Ring-F-nebula/fpga-multitimbral-instrument/firmware/src/fx_pitch_coeff.v

// Bend +/-200 cents plus vibrato +/-100 cents. Q16 frequency ratio.
module fx_pitch_coeff(input signed [9:0] cents,output reg [16:0] coeff);
wire signed [9:0] bounded=cents< -300?-10'sd300:cents>300?10'sd300:cents;
wire [9:0] address=bounded+10'sd300;
always @* case(address)
10'd0:coeff=17'd55109;
10'd1:coeff=17'd55141;
10'd2:coeff=17'd55173;
10'd3:coeff=17'd55205;
10'd4:coeff=17'd55236;
10'd5:coeff=17'd55268;
10'd6:coeff=17'd55300;
10'd7:coeff=17'd55332;
10'd8:coeff=17'd55364;
10'd9:coeff=17'd55396;
10'd10:coeff=17'd55428;
10'd11:coeff=17'd55460;
10'd12:coeff=17'd55492;
10'd13:coeff=17'd55524;
10'd14:coeff=17'd55556;
10'd15:coeff=17'd55589;
10'd16:coeff=17'd55621;
10'd17:coeff=17'd55653;
10'd18:coeff=17'd55685;
10'd19:coeff=17'd55717;
10'd20:coeff=17'd55749;
10'd21:coeff=17'd55782;
10'd22:coeff=17'd55814;
10'd23:coeff=17'd55846;
10'd24:coeff=17'd55878;
10'd25:coeff=17'd55911;
10'd26:coeff=17'd55943;
10'd27:coeff=17'd55975;
10'd28:coeff=17'd56008;
10'd29:coeff=17'd56040;
10'd30:coeff=17'd56072;
10'd31:coeff=17'd56105;
10'd32:coeff=17'd56137;
10'd33:coeff=17'd56170;
10'd34:coeff=17'd56202;
10'd35:coeff=17'd56234;
10'd36:coeff=17'd56267;
10'd37:coeff=17'd56299;
10'd38:coeff=17'd56332;
10'd39:coeff=17'd56365;
10'd40:coeff=17'd56397;
10'd41:coeff=17'd56430;
10'd42:coeff=17'd56462;
10'd43:coeff=17'd56495;
10'd44:coeff=17'd56528;
10'd45:coeff=17'd56560;
10'd46:coeff=17'd56593;
10'd47:coeff=17'd56626;
10'd48:coeff=17'd56658;
10'd49:coeff=17'd56691;
10'd50:coeff=17'd56724;
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
10'd582:coeff=17'd77130;
10'd583:coeff=17'd77174;
10'd584:coeff=17'd77219;
10'd585:coeff=17'd77264;
10'd586:coeff=17'd77308;
10'd587:coeff=17'd77353;
10'd588:coeff=17'd77398;
10'd589:coeff=17'd77442;
10'd590:coeff=17'd77487;
10'd591:coeff=17'd77532;
10'd592:coeff=17'd77577;
10'd593:coeff=17'd77621;
10'd594:coeff=17'd77666;
10'd595:coeff=17'd77711;
10'd596:coeff=17'd77756;
10'd597:coeff=17'd77801;
10'd598:coeff=17'd77846;
10'd599:coeff=17'd77891;
10'd600:coeff=17'd77936;
default:coeff=65536;
endcase
endmodule
