Ring-F-nebula/fpga-multitimbral-instrument/firmware/src/guitar_wave_table.v

// Analytic, sample-measured spectra; six initialized 16-kbit BSRAMs.
// Three registered stages: table read, spectral blend multiply, final sum.
module guitar_wave_table(input clk,enable,input [23:0] phase,step,input [7:0] brightness,
 output reg signed [12:0] value=0);
 wire [1:0] band=step>=24'd368000 ? 2'd2 : step>=24'd184000 ? 2'd1 : 2'd0;
 wire [11:0] address={band,phase[23:14]};
 wire [15:0] body,attack;
 guitar_body_sp body_rom(.clk(clk),.enable(enable),.address(address),.data(body));
 guitar_attack_sp attack_rom(.clk(clk),.enable(enable),.address(address),.data(attack));
 reg [7:0] brightness_q=0;
 reg signed [12:0] body_q=0;
 reg signed [22:0] delta=0;
 wire signed [13:0] difference=$signed(attack)-$signed(body);
 always @(posedge clk)begin
  brightness_q<=brightness;body_q<=$signed(body);
  delta<=difference*$signed({1'b0,brightness_q});
  value<=body_q+($signed(delta)>>>8);
 end
endmodule
module guitar_body_sp(input clk,enable,input [11:0] address,output [15:0] data);
wire [31:0] bank_data[0:2];reg [1:0] bank_q=0;
always @(posedge clk)if(enable)bank_q<=address[11:10];
SP #(.BIT_WIDTH(16),.READ_MODE(1'b0),.WRITE_MODE(2'b00),.INIT_RAM_00(256'h05880552051504d10486043403dc037e031b02b3024701d7016400ee00780000),.INIT_RAM_01(256'h05b105cb05e405fb060f0621062e0638063c063c0636062a061705fe05de05b6),.INIT_RAM_02(256'h04af04ac04ac04af04b504be04ca04d904ea04fe0514052b0545055f057a0596),.INIT_RAM_03(256'h05b0059f058d057905660552053e052a0516050404f204e204d404c704bc04b4),.INIT_RAM_04(256'h05f305fa0600060406070609060906080605060005fa05f205e805dc05cf05c0),.INIT_RAM_05(256'h05620569057105790582058b0594059e05a805b205bc05c605d005da05e305eb),.INIT_RAM_06(256'h05370537053705380539053a053b053d053f054205450548054c05510556055c),.INIT_RAM_07(256'h052305260529052c052e05300531053205330534053505350536053605360536),.INIT_RAM_08(256'h04a304af04bb04c604d004da04e404ed04f504fd0504050a05100516051b051f),.INIT_RAM_09(256'h03d703e103ec03f804040410041d042b0438044604530461046f047c04890496),.INIT_RAM_0A(256'h03a303a203a003a0039f039f03a003a203a403a803ac03b103b703be03c503ce),.INIT_RAM_0B(256'h03790383038d0395039b03a003a403a703a903aa03ab03aa03a903a803a603a5),.INIT_RAM_0C(256'h02270241025c0276028f02a902c102d902f00305031a032d033f0350035f036d),.INIT_RAM_0D(256'h00e900f300ff010c011a012a013c014f01630179018f01a701bf01d901f2020c),.INIT_RAM_0E(256'h00fd00f600ef00e900e200dd00d800d400d100d000cf00d000d200d500db00e1),.INIT_RAM_0F(256'h012c0130013301350135013501330131012e012a0125011f01190112010b0104),.INIT_RAM_10(256'h006f007e008d009d00ac00bb00c900d700e400f000fb01060110011801200126),.INIT_RAM_11(256'hffbdffc2ffc8ffcfffd6ffdfffe8fff3fffe000a00170025003300410050005f),.INIT_RAM_12(256'hffcaffc7ffc4ffc1ffbeffbbffb8ffb6ffb4ffb3ffb2ffb2ffb3ffb4ffb6ffb9),.INIT_RAM_13(256'hffc6ffc9ffcdffd0ffd2ffd4ffd5ffd6ffd7ffd6ffd6ffd5ffd3ffd1ffcfffcc),.INIT_RAM_14(256'hff77ff7bff7fff84ff89ff8eff94ff99ff9effa4ffa9ffaeffb4ffb8ffbdffc2),.INIT_RAM_15(256'hff53ff54ff55ff56ff57ff58ff5aff5cff5eff60ff62ff65ff68ff6bff6fff73),.INIT_RAM_16(256'hff51ff51ff50ff4fff4fff4fff4fff4fff4fff4fff4fff50ff50ff51ff51ff52),.INIT_RAM_17(256'hff7dff7aff76ff72ff6eff6bff67ff64ff61ff5eff5cff59ff57ff56ff54ff53),.INIT_RAM_18(256'hffa1ffa1ffa1ffa0ff9fff9eff9cff9aff98ff95ff93ff8fff8cff89ff85ff81),.INIT_RAM_19(256'hff93ff92ff92ff93ff94ff95ff96ff97ff99ff9aff9bff9dff9eff9fffa0ffa1),.INIT_RAM_1A(256'hffc2ffbeffbaffb6ffb2ffaeffaaffa6ffa3ff9fff9cff9aff97ff96ff94ff93),.INIT_RAM_1B(256'hffaaffb2ffb9ffbfffc4ffc8ffccffceffd0ffd0ffd0ffcfffceffccffc9ffc6),.INIT_RAM_1C(256'hff02ff0aff13ff1dff28ff33ff3eff4aff56ff61ff6dff78ff83ff8eff98ffa1),.INIT_RAM_1D(256'hff2cff20ff15ff0bff02fefbfef4fef0feecfeeafeeafeebfeedfef0fef5fefb),.INIT_RAM_1E(256'h0003fffaffefffe4ffd7ffcaffbcffaeff9fff90ff81ff72ff63ff54ff46ff38),.INIT_RAM_1F(256'h0006000b00110016001a001e002100230024002400230021001d00190013000c),.INIT_RAM_20(256'hffedffe7ffe3ffdfffddffdcffdcffddffdfffe2ffe6ffeaffeffff5fffa0000),.INIT_RAM_21(256'h00ba00ac009d008e007f007000610052004400360029001c00110006fffdfff4),.INIT_RAM_22(256'h010b0110011301150116011601140110010c010500fe00f500eb00e000d400c8),.INIT_RAM_23(256'h00680072007d00880093009f00aa00b600c200cd00d800e300ed00f600fe0105),.INIT_RAM_24(256'h0037003400320031003000300030003200340038003c00410047004e0056005f),.INIT_RAM_25(256'h006c006a0069006600640061005d005a00560052004e004a00460042003e003a),.INIT_RAM_26(256'h00600061006200630065006600670069006a006b006c006d006e006e006d006d),.INIT_RAM_27(256'h007b007700740071006d006b006800660064006200610060005f005f005f005f),.INIT_RAM_28(256'h00ac00aa00a900a700a400a2009f009c009900950092008e008a00860083007f),.INIT_RAM_29(256'h00af00af00b000b000b100b100b100b100b100b100b100b100b000af00af00ad),.INIT_RAM_2A(256'h009100950098009b009e00a000a200a400a600a800a900aa00ab00ac00ad00ae),.INIT_RAM_2B(256'h00430048004c00520057005c00620067006c00720077007c008100850089008d),.INIT_RAM_2C(256'h0031002f002d002b002a002a0029002a002b002c002e003000330037003a003e),.INIT_RAM_2D(256'h004a004c004d004e004e004d004c004a004800450042003f003c003900360034),.INIT_RAM_2E(256'hffb0ffbfffcdffdbffe9fff60002000d00180021002a00310038003e00430047),.INIT_RAM_2F(256'hfee0fee8fef0fefaff05ff10ff1cff29ff37ff45ff54ff63ff73ff82ff91ffa1),.INIT_RAM_30(256'hfef5feeefee7fee1fedbfed6fed2fecffecdfecbfecbfecbfecdfed0fed4feda),.INIT_RAM_31(256'hff25ff2bff2eff30ff31ff30ff2fff2cff28ff23ff1eff17ff11ff0aff03fefc),.INIT_RAM_32(256'hfe0efe27fe41fe59fe71fe87fe9dfeb1fec4fed6fee6fef4ff01ff0dff17ff1f),.INIT_RAM_33(256'hfca1fcb0fcc1fcd3fce6fcfbfd10fd27fd3ffd57fd71fd8afda4fdbffdd9fdf4),.INIT_RAM_34(256'hfc5afc58fc57fc56fc55fc56fc57fc59fc5cfc60fc65fc6bfc73fc7dfc87fc93),.INIT_RAM_35(256'hfc3bfc42fc49fc4ffc54fc58fc5cfc5efc60fc61fc61fc60fc60fc5efc5dfc5b),.INIT_RAM_36(256'hfb77fb84fb91fb9ffbadfbbafbc8fbd5fbe3fbf0fbfcfc08fc14fc1ffc29fc32),.INIT_RAM_37(256'hfae5faeafaf0faf6fafcfb03fb0bfb13fb1cfb26fb30fb3afb45fb51fb5dfb6a),.INIT_RAM_38(256'hfacafacafacafacbfacbfaccfacdfacefacffad0fad2fad4fad7fadafaddfae1),.INIT_RAM_39(256'hfaaafaaffab4fab8fabbfabefac1fac3fac5fac6fac7fac8fac9fac9fac9faca),.INIT_RAM_3A(256'hfa1dfa26fa30fa3afa44fa4efa58fa62fa6cfa75fa7efa87fa8ffa97fa9efaa4),.INIT_RAM_3B(256'hfa31fa24fa18fa0efa06fa00f9fbf9f8f9f7f9f7f9f9f9fcfa00fa06fa0dfa15),.INIT_RAM_3C(256'hfb44fb39fb2cfb1efb0efafcfaeafad6fac2faaefa9afa87fa73fa61fa50fa40),.INIT_RAM_3D(256'hfa86faa1fabbfad5faecfb02fb16fb27fb36fb42fb4bfb51fb54fb54fb51fb4c),.INIT_RAM_3E(256'hfa22fa02f9e9f9d6f9caf9c4f9c4f9c8f9d2f9dff9f1fa05fa1cfa35fa4ffa6a),.INIT_RAM_3F(256'hff88ff12fe9cfe29fdb9fd4dfce5fc82fc24fbccfb7afb2ffaebfaaefa78fa4a)) bank_0(
.DO(bank_data[0]),.DI(32'd0),.BLKSEL(3'd0),.AD({address[9:0],4'd0}),.WRE(1'b0),.CLK(clk),.CE(enable&&address[11:10]==0),.OCE(1'b1),.RESET(1'b0));
SP #(.BIT_WIDTH(16),.READ_MODE(1'b0),.WRITE_MODE(2'b00),.INIT_RAM_00(256'h03790346031002d902a10268022e01f201b60179013b00fd00be007f00400000),.INIT_RAM_01(256'h05c105ac0594057a055e0541052104ff04db04b5048e04640439040b03dc03ac),.INIT_RAM_02(256'h062e0632063506370637063606340630062b0624061b0611060505f705e705d5),.INIT_RAM_03(256'h059b05a605b005bb05c605d105db05e605f005fa0603060c0615061c06230629),.INIT_RAM_04(256'h052d053005330537053b05400546054c0553055a0562056b0574057d05870591),.INIT_RAM_05(256'h054a05450541053d053a053605330530052e052c052b052a05290529052a052b),.INIT_RAM_06(256'h057f057e057d057b057805760573056f056c056805640560055b05570552054e),.INIT_RAM_07(256'h0544054c0553055a05600566056b056f057305770579057c057d057f057f057f),.INIT_RAM_08(256'h049c04a804b304bf04cb04d604e204ed04f80503050d05170521052a0533053c),.INIT_RAM_09(256'h03f003f90402040c04160420042a04350440044b04560461046d047804840490),.INIT_RAM_0A(256'h037e0384038a03900396039d03a303aa03b103b803bf03c703ce03d603df03e7),.INIT_RAM_0B(256'h0313031b0323032b0332033903400347034d0354035a03600366036c03720378),.INIT_RAM_0C(256'h02640271027e028b029702a302af02bb02c602d102db02e502ef02f80302030a),.INIT_RAM_0D(256'h0181018f019d01ab01ba01c801d601e501f402020210021f022d023b02490256),.INIT_RAM_0E(256'h00cc00d400dd00e600f000fa0104010f011a01260132013e014b015801660173),.INIT_RAM_0F(256'h008500870089008b008d009000930097009b00a000a500aa00b000b600bd00c4),.INIT_RAM_10(256'h007c007d007e007e007e007f007f007f007f0080008000800081008200830084),.INIT_RAM_11(256'h004f00540059005e006200650069006c006f00720074007600780079007a007b),.INIT_RAM_12(256'hffdeffe6ffeefff6fffe0006000e0015001d0024002b00320038003e0044004a),.INIT_RAM_13(256'hff6cff71ff77ff7dff83ff8aff91ff98ff9fffa7ffaeffb6ffbeffc6ffceffd6),.INIT_RAM_14(256'hff46ff46ff46ff46ff47ff48ff49ff4bff4dff50ff53ff56ff5aff5eff62ff67),.INIT_RAM_15(256'hff6aff67ff64ff61ff5eff5bff58ff55ff53ff50ff4eff4cff4bff49ff48ff47),.INIT_RAM_16(256'hff91ff8fff8eff8cff8bff89ff86ff84ff82ff7fff7cff79ff77ff74ff70ff6d),.INIT_RAM_17(256'hff8cff8dff8eff8fff90ff91ff92ff93ff93ff94ff94ff94ff93ff93ff92ff92),.INIT_RAM_18(256'hff78ff78ff79ff7aff7bff7cff7dff7eff80ff81ff83ff84ff86ff87ff89ff8a),.INIT_RAM_19(256'hff85ff83ff81ff7fff7dff7cff7bff7aff79ff78ff77ff77ff77ff77ff77ff77),.INIT_RAM_1A(256'hffa9ffa7ffa5ffa3ffa1ff9fff9cff9aff97ff95ff92ff90ff8eff8bff89ff87),.INIT_RAM_1B(256'hffa9ffabffacffaeffafffb0ffb0ffb1ffb1ffb1ffb0ffafffafffadffacffab),.INIT_RAM_1C(256'hff6dff72ff77ff7bff80ff84ff88ff8cff90ff94ff98ff9bff9effa1ffa4ffa7),.INIT_RAM_1D(256'hff38ff39ff3bff3dff3fff42ff45ff48ff4bff4fff53ff57ff5cff60ff64ff69),.INIT_RAM_1E(256'hff62ff5cff56ff51ff4cff48ff44ff41ff3eff3bff39ff38ff37ff37ff37ff37),.INIT_RAM_1F(256'hfff5ffebffe0ffd5ffcbffc1ffb7ffadffa3ff9aff91ff88ff80ff78ff70ff69),.INIT_RAM_20(256'h0090008800800078006f0066005d00530049003f0035002b00200015000b0000),.INIT_RAM_21(256'h00c900c900c900c800c700c500c200bf00bc00b800b400af00aa00a4009e0097),.INIT_RAM_22(256'h009c00a000a400a900ad00b100b500b800bb00be00c100c300c500c700c800c9),.INIT_RAM_23(256'h005c005f006200650068006c007000740078007c008000850089008e00930097),.INIT_RAM_24(256'h00540053005100510050004f004f004f00500050005100520054005500570059),.INIT_RAM_25(256'h0077007500720070006e006b0069006600640061005f005d005b005900570055),.INIT_RAM_26(256'h008900890089008900890088008700860085008400830081007f007d007b0079),.INIT_RAM_27(256'h00770079007a007c007d007f0080008200830084008500860087008800880089),.INIT_RAM_28(256'h006e006d006d006c006c006c006d006d006e006f007000710072007300740076),.INIT_RAM_29(256'h0090008c0089008700840081007e007c007a00770075007400720071006f006e),.INIT_RAM_2A(256'h00b800b700b500b400b200b000ad00ab00a800a500a2009f009c009900960093),.INIT_RAM_2B(256'h009e00a200a600aa00ad00b000b300b500b700b800b900ba00ba00ba00ba00b9),.INIT_RAM_2C(256'h0032003a0042004a0052005900610068006f0076007d00830089008f00940099),.INIT_RAM_2D(256'hffbcffc2ffc8ffceffd5ffdcffe3ffebfff2fffa0002000a0012001a0022002a),.INIT_RAM_2E(256'hff86ff87ff88ff8aff8cff8eff91ff94ff97ff9bff9effa2ffa7ffacffb1ffb6),.INIT_RAM_2F(256'hff7dff7eff7fff80ff80ff80ff81ff81ff81ff81ff82ff82ff82ff83ff84ff85),.INIT_RAM_30(256'hff43ff4aff50ff56ff5bff60ff65ff69ff6dff70ff73ff75ff77ff79ff7bff7c),.INIT_RAM_31(256'hfe9afea8feb5fec2fecefedafee6fef1fefcff06ff10ff1aff23ff2cff34ff3c),.INIT_RAM_32(256'hfdb7fdc5fdd3fde1fdf0fdfefe0cfe1bfe2afe38fe46fe55fe63fe71fe7ffe8d),.INIT_RAM_33(256'hfcfefd08fd11fd1bfd25fd2ffd3afd45fd51fd5dfd69fd75fd82fd8ffd9cfdaa),.INIT_RAM_34(256'hfc8efc94fc9afca0fca6fcacfcb3fcb9fcc0fcc7fccefcd5fcddfce5fcedfcf6),.INIT_RAM_35(256'hfc21fc2afc32fc39fc41fc48fc4ffc56fc5dfc63fc6afc70fc76fc7cfc82fc88),.INIT_RAM_36(256'hfb7cfb88fb93fb9ffbaafbb5fbc0fbcbfbd6fbe0fbeafbf4fbfefc07fc10fc19),.INIT_RAM_37(256'hfacdfad6fadffae9faf3fafdfb08fb13fb1efb2afb35fb41fb4dfb58fb64fb70),.INIT_RAM_38(256'hfa81fa81fa83fa84fa87fa89fa8dfa91fa95fa9afaa0faa6faadfab4fabcfac4),.INIT_RAM_39(256'hfaaefaa9faa5faa0fa9cfa98fa94fa91fa8dfa8afa88fa85fa83fa82fa81fa81),.INIT_RAM_3A(256'hfad6fad7fad7fad6fad5fad4fad2fad0facdfacafac6fac3fabffabbfab6fab2),.INIT_RAM_3B(256'hfa79fa83fa8cfa95fa9efaa6faadfab4fabafac0fac5fac9facdfad0fad3fad5),.INIT_RAM_3C(256'hf9ddf9e4f9ebf9f4f9fdfa06fa10fa1afa25fa2ffa3afa45fa50fa5afa65fa6f),.INIT_RAM_3D(256'hfa19fa09f9fbf9eff9e5f9dcf9d5f9d0f9ccf9caf9c9f9c9f9cbf9cef9d2f9d7),.INIT_RAM_3E(256'hfc24fbf5fbc7fb9cfb72fb4bfb25fb01fadffabffaa2fa86fa6cfa54fa3ffa2b),.INIT_RAM_3F(256'hffc0ff81ff42ff03fec5fe87fe4afe0efdd2fd98fd5ffd27fcf0fcbafc87fc54)) bank_1(
.DO(bank_data[1]),.DI(32'd0),.BLKSEL(3'd0),.AD({address[9:0],4'd0}),.WRE(1'b0),.CLK(clk),.CE(enable&&address[11:10]==1),.OCE(1'b1),.RESET(1'b0));
SP #(.BIT_WIDTH(16),.READ_MODE(1'b0),.WRITE_MODE(2'b00),.INIT_RAM_00(256'h0189016f0155013b0121010700ed00d300b9009f0084006a004f0035001a0000),.INIT_RAM_01(256'h030f02f802e102ca02b2029a0282026a025102390220020701ee01d501bc01a2),.INIT_RAM_02(256'h045e044b04380424041103fd03e903d403bf03aa0395037f03690353033d0326),.INIT_RAM_03(256'h055e05510543053505270518050804f904e904d904c804b704a6049404830470),.INIT_RAM_04(256'h060305fc05f405ec05e305da05d105c705bd05b205a8059c059105850578056c),.INIT_RAM_05(256'h06480646064406420640063d063906360632062d06280623061e06180611060b),.INIT_RAM_06(256'h063006340637063b063e064106430645064706480649064a064a064a064a0649),.INIT_RAM_07(256'h05c705d005d805e005e805f005f705fe0605060b06110617061c06220627062b),.INIT_RAM_08(256'h0521052d053905440550055b05660570057b0585058f059905a305ac05b605bf),.INIT_RAM_09(256'h04540461046f047c048a049704a404b104be04cb04d804e404f104fd05090516),.INIT_RAM_0A(256'h037503830391039f03ad03bb03c903d703e503f30401040f041d042b04380446),.INIT_RAM_0B(256'h029b02a802b502c302d002de02eb02f90306031403220330033d034b03590367),.INIT_RAM_0C(256'h01d601e201ed01f902050211021d022902350241024e025b026702740281028e),.INIT_RAM_0D(256'h0132013c0145014e01580162016b01750180018a0194019f01aa01b501c001cb),.INIT_RAM_0E(256'h00b500bc00c300ca00d100d800df00e700ef00f700ff0107010f011801210129),.INIT_RAM_0F(256'h005e00620067006b00700075007a007f0085008a00900096009c00a200a800ae),.INIT_RAM_10(256'h0027002a002c002f003200350038003b003f004200460049004d005100550059),.INIT_RAM_11(256'h0008000a000b000d000e001000120013001500170019001b001d002000220024),.INIT_RAM_12(256'hfff7fff8fff9fffafffbfffcfffdfffeffff0000000100020003000400060007),.INIT_RAM_13(256'hffebffecffedffeeffeeffeffff0fff1fff1fff2fff3fff4fff4fff5fff6fff7),.INIT_RAM_14(256'hffdcffdeffdfffe0ffe1ffe2ffe3ffe4ffe5ffe5ffe6ffe7ffe8ffe9ffeaffeb),.INIT_RAM_15(256'hffc7ffc8ffcaffcbffcdffceffd0ffd1ffd3ffd4ffd5ffd6ffd8ffd9ffdaffdb),.INIT_RAM_16(256'hffa9ffabffadffafffb1ffb3ffb5ffb7ffb9ffbbffbcffbeffc0ffc2ffc3ffc5),.INIT_RAM_17(256'hff87ff89ff8cff8eff90ff92ff94ff96ff99ff9bff9dff9fffa1ffa3ffa5ffa7),.INIT_RAM_18(256'hff65ff67ff69ff6bff6dff70ff72ff74ff76ff78ff7aff7cff7eff81ff83ff85),.INIT_RAM_19(256'hff4aff4cff4dff4fff50ff52ff53ff55ff57ff58ff5aff5cff5eff60ff62ff63),.INIT_RAM_1A(256'hff3dff3dff3dff3eff3fff3fff40ff41ff42ff42ff43ff44ff46ff47ff48ff49),.INIT_RAM_1B(256'hff40ff3fff3fff3eff3dff3dff3dff3cff3cff3cff3cff3cff3cff3cff3cff3c),.INIT_RAM_1C(256'hff58ff56ff54ff52ff50ff4eff4dff4bff49ff48ff47ff45ff44ff43ff42ff41),.INIT_RAM_1D(256'hff82ff7fff7cff79ff76ff73ff70ff6dff6bff68ff65ff63ff61ff5eff5cff5a),.INIT_RAM_1E(256'hffbbffb7ffb3ffafffabffa8ffa4ffa0ff9dff99ff96ff92ff8fff8bff88ff85),.INIT_RAM_1F(256'hfffcfff8fff3ffefffebffe7ffe3ffdfffdbffd7ffd3ffceffcaffc6ffc2ffbf),.INIT_RAM_20(256'h003e003a00360032002d002900250021001d001900150011000d000800040000),.INIT_RAM_21(256'h007800750071006e006a006700630060005c005800550051004d004900450041),.INIT_RAM_22(256'h00a400a2009f009d009b0098009500930090008d008a008700840081007e007b),.INIT_RAM_23(256'h00be00bd00bc00bb00b900b800b700b500b300b200b000ae00ac00aa00a800a6),.INIT_RAM_24(256'h00c400c400c400c400c400c400c400c400c300c300c300c200c100c100c000bf),.INIT_RAM_25(256'h00b800b900ba00bc00bd00be00be00bf00c000c100c100c200c300c300c300c4),.INIT_RAM_26(256'h009e00a000a200a400a600a800a900ab00ad00ae00b000b100b300b400b600b7),.INIT_RAM_27(256'h007d007f0082008400860088008a008c008e00900093009500970099009b009d),.INIT_RAM_28(256'h005b005d005f0061006300650067006a006c006e00700072007400770079007b),.INIT_RAM_29(256'h003d003e004000420044004500470049004b004d004f00510053005500570059),.INIT_RAM_2A(256'h002600270028002a002b002c002d002f0030003200330035003600380039003b),.INIT_RAM_2B(256'h0016001700180019001a001b001b001c001d001e001f00200021002200240025),.INIT_RAM_2C(256'h000a000b000c000c000d000e000f000f00100011001200120013001400150015),.INIT_RAM_2D(256'hfffafffcfffdfffeffff00000001000200030004000500060007000800090009),.INIT_RAM_2E(256'hffdeffe0ffe3ffe5ffe7ffe9ffebffedffeefff0fff2fff3fff5fff6fff8fff9),.INIT_RAM_2F(256'hffabffafffb3ffb7ffbaffbeffc1ffc5ffc8ffcbffceffd1ffd4ffd6ffd9ffdc),.INIT_RAM_30(256'hff58ff5eff64ff6aff70ff76ff7bff81ff86ff8bff90ff95ff99ff9effa2ffa7),.INIT_RAM_31(256'hfedffee8fef1fef9ff01ff09ff11ff19ff21ff28ff2fff36ff3dff44ff4bff52),.INIT_RAM_32(256'hfe40fe4bfe56fe61fe6cfe76fe80fe8bfe95fe9efea8feb2febbfec4fecefed7),.INIT_RAM_33(256'hfd7ffd8cfd99fda5fdb2fdbffdcbfdd7fde3fdeffdfbfe07fe13fe1efe2afe35),.INIT_RAM_34(256'hfca7fcb5fcc3fcd0fcdefcecfcfafd07fd15fd22fd30fd3dfd4bfd58fd65fd72),.INIT_RAM_35(256'hfbc8fbd5fbe3fbf1fbfffc0dfc1bfc29fc37fc45fc53fc61fc6ffc7dfc8bfc99),.INIT_RAM_36(256'hfaf7fb03fb0ffb1cfb28fb35fb42fb4ffb5cfb69fb76fb84fb91fb9ffbacfbba),.INIT_RAM_37(256'hfa4afa54fa5dfa67fa71fa7bfa85fa90fa9afaa5fab0fabcfac7fad3fadffaea),.INIT_RAM_38(256'hf9d9f9def9e4f9e9f9eff9f5f9fbfa02fa09fa10fa18fa20fa28fa30fa39fa41),.INIT_RAM_39(256'hf9b6f9b6f9b6f9b6f9b7f9b8f9b9f9bbf9bdf9bff9c2f9c5f9c9f9ccf9d0f9d5),.INIT_RAM_3A(256'hf9eff9e8f9e2f9ddf9d8f9d3f9cef9caf9c7f9c3f9c0f9bef9bcf9baf9b8f9b7),.INIT_RAM_3B(256'hfa88fa7bfa6ffa64fa58fa4efa43fa39fa2ffa26fa1dfa14fa0cfa04f9fdf9f5),.INIT_RAM_3C(256'hfb7dfb6cfb5afb49fb38fb27fb17fb07faf8fae8fad9facbfabdfaaffaa2fa94),.INIT_RAM_3D(256'hfcc3fcadfc97fc81fc6bfc56fc41fc2cfc17fc03fbeffbdcfbc8fbb5fba2fb90),.INIT_RAM_3E(256'hfe44fe2bfe12fdf9fde0fdc7fdaffd96fd7efd66fd4efd36fd1ffd08fcf1fcda),.INIT_RAM_3F(256'hffe6ffcbffb1ff96ff7cff61ff47ff2dff13fef9fedffec5feabfe91fe77fe5e)) bank_2(
.DO(bank_data[2]),.DI(32'd0),.BLKSEL(3'd0),.AD({address[9:0],4'd0}),.WRE(1'b0),.CLK(clk),.CE(enable&&address[11:10]==2),.OCE(1'b1),.RESET(1'b0));
assign data=bank_data[bank_q][15:0];
endmodule
module guitar_attack_sp(input clk,enable,input [11:0] address,output [15:0] data);
wire [31:0] bank_data[0:2];reg [1:0] bank_q=0;
always @(posedge clk)if(enable)bank_q<=address[11:10];
SP #(.BIT_WIDTH(16),.READ_MODE(1'b0),.WRITE_MODE(2'b00),.INIT_RAM_00(256'h070806d30691064405ec0589051c04a50425039d030e027901df014100a10000),.INIT_RAM_01(256'h056c05ae05ef062e066a06a206d5070207290747075d0769076c076407510732),.INIT_RAM_02(256'h031d03170318031f032c0340035a037a03a003cc03fd0432046c04a904e8052a),.INIT_RAM_03(256'h0555052b050004d404a7047a044e042203f803d003aa03880369034e03390328),.INIT_RAM_04(256'h065c06630668066a06690664065c065106420630061a060005e405c405a2057c),.INIT_RAM_05(256'h0516052d0545055d0575058d05a505bd05d405ea05ff06130625063606450652),.INIT_RAM_06(256'h0439043c04400446044e04580462046f047d048c049c04ae04c104d504ea0500),.INIT_RAM_07(256'h04ab049f04930488047c04710467045d0454044c04450440043b043804370437),.INIT_RAM_08(256'h04de04e704ed04f204f604f704f704f504f204ed04e604df04d604cc04c204b7),.INIT_RAM_09(256'h03d603e703f8040a041c042f044204550468047a048c049d04ad04bb04c804d4),.INIT_RAM_0A(256'h037a037903770377037603770379037c03810386038e039603a003ac03b903c7),.INIT_RAM_0B(256'h0319032c033d034c03590364036d03740379037d037f03800380037f037e037c),.INIT_RAM_0C(256'h0140015e017d019d01be01df0200022102410261027f029d02b902d402ed0304),.INIT_RAM_0D(256'h0073006e006c006c006e007200790083008f009d00ae00c200d700ee01080123),.INIT_RAM_0E(256'h015c014c013b012a0118010700f500e400d300c300b400a50098008c0082007a),.INIT_RAM_0F(256'h01d201d401d501d501d301d001cc01c601bf01b601ad01a201960189017b016c),.INIT_RAM_10(256'h010b011e013001420153016301730181018f019c01a701b201bb01c201c901ce),.INIT_RAM_11(256'h0019002000280031003d00490057006600760087009900ac00be00d100e500f8),.INIT_RAM_12(256'h0099008800780068005a004c003f0034002a0021001b00160013001200120015),.INIT_RAM_13(256'h010b01140119011d011d011c01180111010900ff00f400e600d800c900b900a9),.INIT_RAM_14(256'hff83ffa2ffc1ffe0ffff001e003b00580074008e00a600bd00d100e300f30101),.INIT_RAM_15(256'hfe72fe72fe75fe7afe82fe8bfe98fea7feb8fecbfee0fef8ff11ff2cff48ff65),.INIT_RAM_16(256'hff47ff34ff22ff0ffefdfeebfed9fec9feb9feabfe9dfe92fe87fe7ffe79fe74),.INIT_RAM_17(256'h000900050000fff9fff1ffe8ffdeffd3ffc7ffbaffacff9dff8dff7cff6bff59),.INIT_RAM_18(256'hffc9ffd2ffdcffe4ffecfff4fffa000000050009000c000e000f000f000e000c),.INIT_RAM_19(256'hff28ff2fff36ff3fff48ff51ff5cff66ff71ff7cff87ff93ff9effa9ffb4ffbf),.INIT_RAM_1A(256'hff4eff45ff3cff33ff2cff25ff20ff1bff18ff16ff15ff15ff17ff19ff1dff22),.INIT_RAM_1B(256'hffbdffbeffbeffbcffb9ffb4ffaeffa7ff9fff96ff8dff82ff78ff6dff63ff58),.INIT_RAM_1C(256'hfee7fef9ff0cff1fff31ff43ff55ff65ff75ff83ff90ff9cffa6ffaeffb4ffb9),.INIT_RAM_1D(256'hfe73fe6cfe67fe63fe63fe64fe67fe6cfe74fe7dfe88fe95fea3feb3fec3fed5),.INIT_RAM_1E(256'hff81ff6fff5dff4aff36ff23ff0ffefbfee8fed5fec3feb2fea2fe94fe87fe7c),.INIT_RAM_1F(256'hfffffffefffdfffbfff8fff5fff1ffebffe5ffddffd3ffc9ffbdffb0ffa1ff92),.INIT_RAM_20(256'h005f005000430037002d0023001b0015000f000b000800050003000200010000),.INIT_RAM_21(256'h0179016c015e014e013d012b0118010500f100dd00ca00b600a30091007f006e),.INIT_RAM_22(256'h013d014d015d016b01780183018c01940199019c019d019d01990194018d0184),.INIT_RAM_23(256'h004c0052005a00640070007d008b009b00ab00bd00cf00e100f401070119012b),.INIT_RAM_24(256'h009d00930088007e0073006a006100590052004c004700440042004200430047),.INIT_RAM_25(256'h00e300e700e900eb00eb00ea00e800e500e000db00d400cd00c400bb00b200a8),.INIT_RAM_26(256'h004c00570062006d00790084008f009a00a400af00b800c100ca00d100d800de),.INIT_RAM_27(256'hfff2fff1fff1fff2fff4fff7fffb00000006000c0014001c0024002e00370041),.INIT_RAM_28(256'h0095008400730063005400460039002d00220018000f00070000fffbfff7fff4),.INIT_RAM_29(256'h018701810179016e016301550147013701270115010300f100de00cc00b900a7),.INIT_RAM_2A(256'h00b800d400ef0108012001350148015901680175017e0186018b018e018e018c),.INIT_RAM_2B(256'hff0dff1dff2fff43ff5aff72ff8cffa8ffc5ffe200010020003f005e007d009b),.INIT_RAM_2C(256'hff47ff37ff28ff1aff0cff01fef7feeffee8fee4fee3fee3fee7feecfef5feff),.INIT_RAM_2D(256'hffeeffeeffedffeaffe5ffdfffd6ffccffc1ffb4ffa6ff98ff88ff78ff67ff57),.INIT_RAM_2E(256'hff1bff2fff42ff54ff67ff79ff8aff9affa9ffb7ffc3ffcfffd8ffe0ffe7ffeb),.INIT_RAM_2F(256'hfe37fe3efe45fe4efe59fe64fe71fe7ffe8dfe9dfeadfebefed0fee2fef5ff08),.INIT_RAM_30(256'hfe85fe77fe6afe5efe53fe4afe41fe3afe34fe30fe2dfe2bfe2bfe2cfe2efe32),.INIT_RAM_31(256'hff7eff74ff68ff5bff4cff3dff2dff1cff0bfef9fee8fed6fec5feb4fea4fe94),.INIT_RAM_32(256'hfef8ff12ff29ff3eff52ff63ff71ff7dff87ff8eff92ff94ff94ff92ff8dff86),.INIT_RAM_33(256'hfd13fd2cfd47fd63fd81fd9ffdbffddffe00fe21fe42fe63fe83fea2fec0fedd),.INIT_RAM_34(256'hfc82fc81fc80fc80fc81fc83fc87fc8cfc93fc9cfca7fcb4fcc3fcd4fce7fcfc),.INIT_RAM_35(256'hfc47fc54fc60fc6afc72fc7afc7ffc84fc87fc89fc8afc89fc89fc87fc86fc84),.INIT_RAM_36(256'hfb38fb45fb53fb63fb74fb86fb98fbabfbbefbd1fbe4fbf6fc08fc19fc2afc39),.INIT_RAM_37(256'hfb3efb34fb2afb21fb1afb13fb0efb0bfb09fb09fb0afb0efb13fb19fb22fb2c),.INIT_RAM_38(256'hfbc9fbc8fbc5fbc0fbbbfbb4fbacfba3fb99fb8ffb84fb78fb6dfb61fb55fb49),.INIT_RAM_39(256'hfb16fb2bfb3ffb52fb64fb74fb83fb91fb9efba8fbb2fbbafbc0fbc4fbc7fbc9),.INIT_RAM_3A(256'hf9bbf9caf9dbf9edfa01fa16fa2cfa43fa5bfa73fa8bfaa3fabbfad3faeafb00),.INIT_RAM_3B(256'hfa5efa3cfa1cfa00f9e6f9d0f9bef9aff9a4f99cf997f996f998f99df9a4f9ae),.INIT_RAM_3C(256'hfcc7fcb2fc97fc78fc56fc30fc08fbdefbb2fb86fb59fb2cfb00fad5faabfa84),.INIT_RAM_3D(256'hfb18fb57fb94fbcefc03fc34fc60fc86fca6fcc0fcd4fce1fce8fce9fce3fcd8),.INIT_RAM_3E(256'hf8aff89cf894f897f8a3f8b9f8d7f8fef92bf95ef996f9d2fa11fa52fa94fad6),.INIT_RAM_3F(256'hff5ffebffe21fd87fcf2fc63fbdbfb5bfae4fa77fa14f9bcf96ff92df8f8f8ce)) bank_0(
.DO(bank_data[0]),.DI(32'd0),.BLKSEL(3'd0),.AD({address[9:0],4'd0}),.WRE(1'b0),.CLK(clk),.CE(enable&&address[11:10]==0),.OCE(1'b1),.RESET(1'b0));
SP #(.BIT_WIDTH(16),.READ_MODE(1'b0),.WRITE_MODE(2'b00),.INIT_RAM_00(256'h0350031e02eb02b70282024b021401db01a10167012c00f100b50079003d0000),.INIT_RAM_01(256'h057f056a0554053b0520050404e504c504a2047e04580430040703db03af0380),.INIT_RAM_02(256'h05e505e905ed05ef05ef05ef05ed05e905e405de05d605cc05c005b305a30592),.INIT_RAM_03(256'h05470553055f056b05760582058d059905a305ae05b805c105ca05d205d905e0),.INIT_RAM_04(256'h04c104c504ca04d004d604dd04e404ec04f404fd05070511051b05260531053c),.INIT_RAM_05(256'h04c904c504c204bf04bc04ba04b804b604b504b404b404b504b604b804ba04bd),.INIT_RAM_06(256'h050c05090506050204fe04fa04f604f104ed04e804e404df04da04d604d104cd),.INIT_RAM_07(256'h05030507050b050e05100513051405160516051605160516051405130511050f),.INIT_RAM_08(256'h048c049604a004a904b204ba04c304cb04d304da04e104e804ee04f404f904fe),.INIT_RAM_09(256'h03e603f103fb04060410041b04260430043b04450450045a0464046f04790483),.INIT_RAM_0A(256'h0345034f03590363036d03770380038a0395039f03a903b303bd03c703d203dc),.INIT_RAM_0B(256'h029c02a702b202bd02c802d302de02e902f302fe03080312031d03270331033b),.INIT_RAM_0C(256'h01d701e401f001fd020a02160223022f023c024802540261026d027902840290),.INIT_RAM_0D(256'h0124012d01360140014a01550160016b01760182018d019901a601b201be01cb),.INIT_RAM_0E(256'h00d200d400d500d800da00de00e200e600eb00f000f600fc0103010b0113011b),.INIT_RAM_0F(256'h00f800f400ef00eb00e700e300e000dd00da00d700d500d400d200d200d100d2),.INIT_RAM_10(256'h013f013c013901350131012d012901240120011b01160111010c0107010200fd),.INIT_RAM_11(256'h012d01320136013a013e01400143014501460147014701470146014501430141),.INIT_RAM_12(256'h00a000ab00b600c100cc00d600e000ea00f300fc0104010c0114011b01210127),.INIT_RAM_13(256'hffe8fff3fffd00080014001f002b00360042004e005a00660072007d00890095),.INIT_RAM_14(256'hff6fff73ff79ff7eff84ff8aff91ff98ff9fffa7ffafffb8ffc1ffcaffd4ffde),.INIT_RAM_15(256'hff55ff55ff54ff54ff54ff55ff56ff57ff58ff59ff5bff5eff60ff63ff67ff6b),.INIT_RAM_16(256'hff6cff6aff68ff67ff65ff63ff62ff60ff5fff5dff5bff5aff59ff58ff57ff56),.INIT_RAM_17(256'hff7eff7dff7dff7cff7bff7aff79ff78ff77ff76ff75ff73ff72ff70ff6fff6d),.INIT_RAM_18(256'hff85ff85ff84ff84ff84ff83ff83ff82ff82ff82ff81ff81ff80ff80ff7fff7f),.INIT_RAM_19(256'hff8eff8dff8dff8cff8cff8bff8bff8aff89ff89ff88ff88ff87ff87ff86ff86),.INIT_RAM_1A(256'hff88ff8aff8bff8cff8dff8eff8eff8fff8fff8fff8fff8fff8fff8fff8fff8e),.INIT_RAM_1B(256'hff52ff57ff5cff60ff65ff69ff6dff71ff74ff77ff7aff7dff80ff82ff84ff86),.INIT_RAM_1C(256'hfef7fefcff02ff08ff0dff13ff19ff1fff25ff2bff31ff37ff3cff42ff47ff4d),.INIT_RAM_1D(256'hfecafec9fec9fecafecbfecdfecffed1fed4fed7fedbfedffee3fee8feedfef2),.INIT_RAM_1E(256'hff20ff16ff0dff05fefdfef5feeefee8fee2feddfed9fed5fed1fecffeccfecb),.INIT_RAM_1F(256'hfff1ffe2ffd4ffc5ffb6ffa8ff9aff8cff7fff71ff65ff58ff4cff40ff35ff2a),.INIT_RAM_20(256'h00cb00c000b400a8009b008f0081007400660058004a003b002c001e000f0000),.INIT_RAM_21(256'h01340131012f012b01270123011e01180112010b010300fb00f300ea00e000d6),.INIT_RAM_22(256'h01130118011d012101250129012c012f01310133013501360137013701360135),.INIT_RAM_23(256'h00b900be00c400c900cf00d500db00e100e700ed00f300f800fe01040109010e),.INIT_RAM_24(256'h007c007e0080008300860089008c008f00930097009b00a000a400a900ae00b3),.INIT_RAM_25(256'h007100710071007100710071007100710072007200730074007500760078007a),.INIT_RAM_26(256'h007a007900790078007800770077007600750075007400740073007300720072),.INIT_RAM_27(256'h008100800080007f007f007e007e007e007d007d007c007c007c007b007b007a),.INIT_RAM_28(256'h00910090008e008d008b008a0089008800870086008500840083008300820081),.INIT_RAM_29(256'h00a900a800a700a600a500a300a100a0009e009d009b00990098009600940093),.INIT_RAM_2A(256'h0099009d00a000a200a500a700a800a900aa00ab00ac00ac00ac00ab00ab00aa),.INIT_RAM_2B(256'h002c0036003f00480051005900610068006f0076007c00820087008d00910095),.INIT_RAM_2C(256'hff77ff83ff8eff9affa6ffb2ffbeffcaffd5ffe1ffecfff80003000d00180022),.INIT_RAM_2D(256'hfedffee5feecfef4fefcff04ff0dff16ff20ff2aff34ff3fff4aff55ff60ff6b),.INIT_RAM_2E(256'hfebdfebbfebafeb9feb9feb9febafebbfebdfec0fec2fec6fecafecefed3fed9),.INIT_RAM_2F(256'hfefefef9fef4feeffeeafee5fee0fedcfed7fed3fecffecbfec7fec4fec1febf),.INIT_RAM_30(256'hff2fff2eff2eff2cff2bff29ff26ff23ff20ff1dff19ff15ff11ff0cff08ff03),.INIT_RAM_31(256'hfeedfef5fefdff04ff0aff10ff15ff1aff1eff22ff26ff28ff2bff2cff2eff2e),.INIT_RAM_32(256'hfe42fe4efe5afe67fe73fe7efe8afe95fea0feabfeb6fec0fecafed3fedcfee5),.INIT_RAM_33(256'hfd7cfd87fd93fd9ffdacfdb8fdc4fdd1fdddfdeafdf6fe03fe10fe1cfe29fe35),.INIT_RAM_34(256'hfccffcd9fce3fceefcf8fd02fd0dfd17fd22fd2dfd38fd43fd4efd59fd64fd70),.INIT_RAM_35(256'hfc2efc39fc43fc4dfc57fc61fc6bfc76fc80fc89fc93fc9dfca7fcb1fcbbfcc5),.INIT_RAM_36(256'hfb87fb91fb9cfba6fbb0fbbbfbc5fbd0fbdafbe5fbf0fbfafc05fc0ffc1afc24),.INIT_RAM_37(256'hfb07fb0cfb12fb18fb1ffb26fb2dfb35fb3dfb46fb4efb57fb60fb6afb74fb7d),.INIT_RAM_38(256'hfaeffaedfaecfaeafaeafaeafaeafaeafaecfaedfaf0faf2faf5faf9fafdfb02),.INIT_RAM_39(256'hfb2ffb2afb26fb21fb1cfb18fb13fb0ffb0afb06fb02fafefafafaf7faf4faf1),.INIT_RAM_3A(256'hfb46fb48fb4afb4bfb4cfb4cfb4bfb4afb48fb46fb44fb41fb3efb3bfb37fb33),.INIT_RAM_3B(256'hfacffadafae5faeffaf9fb03fb0cfb14fb1cfb23fb2afb30fb36fb3bfb3ffb43),.INIT_RAM_3C(256'hfa27fa2efa36fa3ffa48fa52fa5dfa67fa73fa7efa8afa95faa1faadfab9fac4),.INIT_RAM_3D(256'hfa5dfa4dfa40fa34fa2afa22fa1cfa17fa13fa11fa11fa11fa13fa17fa1bfa20),.INIT_RAM_3E(256'hfc51fc25fbf9fbd0fba8fb82fb5efb3bfb1bfafcfae0fac5faacfa96fa81fa6e),.INIT_RAM_3F(256'hffc3ff87ff4bff0ffed4fe99fe5ffe25fdecfdb5fd7efd49fd15fce2fcb0fc80)) bank_1(
.DO(bank_data[1]),.DI(32'd0),.BLKSEL(3'd0),.AD({address[9:0],4'd0}),.WRE(1'b0),.CLK(clk),.CE(enable&&address[11:10]==1),.OCE(1'b1),.RESET(1'b0));
SP #(.BIT_WIDTH(16),.READ_MODE(1'b0),.WRITE_MODE(2'b00),.INIT_RAM_00(256'h017a01610148012f011600fd00e400cb00b20098007f0066004c003300190000),.INIT_RAM_01(256'h02f002da02c302ad0296028002690251023a0223020b01f301db01c301ab0192),.INIT_RAM_02(256'h042d041b040903f703e403d203be03ab03970383036f035a03450330031b0305),.INIT_RAM_03(256'h051d0510050404f704e904db04cd04bf04b004a104910481047104610450043f),.INIT_RAM_04(256'h05b105ab05a4059d0595058d0585057c0573056905600555054b054005340529),.INIT_RAM_05(256'h05e705e605e505e405e205e005de05db05d805d405d005cc05c705c205bd05b7),.INIT_RAM_06(256'h05c405c905cd05d105d405d805db05de05e005e205e405e505e605e705e705e7),.INIT_RAM_07(256'h0556055f056705700578057f0587058e0595059c05a305a905af05b505ba05bf),.INIT_RAM_08(256'h04b204bd04c904d404df04ea04f504ff050a0514051e05280531053b0544054d),.INIT_RAM_09(256'h03ee03fb040704140421042d043a04460452045f046b04770483048f049b04a6),.INIT_RAM_0A(256'h0322032e033b034803540361036e037b0388039403a103ae03bb03c803d403e1),.INIT_RAM_0B(256'h0262026d027902840290029c02a702b302bf02cb02d702e402f002fc03090315),.INIT_RAM_0C(256'h01be01c701d001da01e401ed01f70201020c02160220022b02360241024c0257),.INIT_RAM_0D(256'h013e0145014c0153015a0162016901710179018101890192019a01a301ac01b5),.INIT_RAM_0E(256'h00e500ea00ee00f300f800fd01020108010d01130118011e0124012b01310138),.INIT_RAM_0F(256'h00af00b200b400b700ba00bd00c000c300c600ca00cd00d100d500d900dd00e1),.INIT_RAM_10(256'h009300940095009600980099009b009d009e00a000a200a400a600a800aa00ad),.INIT_RAM_11(256'h00840085008600860087008800890089008a008b008c008d008e008f00900091),.INIT_RAM_12(256'h007800790079007a007b007c007d007e007e007f008000800081008200830083),.INIT_RAM_13(256'h0063006500660068006a006b006c006e006f0070007100730074007500760077),.INIT_RAM_14(256'h0040004300460048004b004d004f0052005400560058005a005c005e00600062),.INIT_RAM_15(256'h000d001100140018001b001f002200250029002c002f003200350038003b003e),.INIT_RAM_16(256'hffccffd1ffd5ffd9ffddffe2ffe6ffeaffeefff2fff6fffafffe000200060009),.INIT_RAM_17(256'hff85ff89ff8eff92ff97ff9bffa0ffa4ffa9ffadffb2ffb6ffbbffbfffc3ffc8),.INIT_RAM_18(256'hff41ff44ff49ff4dff51ff55ff59ff5dff62ff66ff6aff6fff73ff77ff7cff80),.INIT_RAM_19(256'hff0aff0dff10ff13ff16ff19ff1cff1fff23ff26ff2aff2dff31ff35ff39ff3d),.INIT_RAM_1A(256'hfeeafeecfeedfeeefef0fef1fef3fef5fef7fef9fefbfefdff00ff02ff05ff07),.INIT_RAM_1B(256'hfee9fee8fee7fee7fee6fee6fee6fee6fee6fee6fee6fee7fee7fee8fee9fee9),.INIT_RAM_1C(256'hff08ff05ff02fefffefdfefbfef8fef6fef4fef2fef1feeffeeefeecfeebfeea),.INIT_RAM_1D(256'hff44ff40ff3bff37ff33ff2eff2aff26ff23ff1fff1bff18ff14ff11ff0eff0b),.INIT_RAM_1E(256'hff99ff93ff8dff87ff82ff7cff77ff71ff6cff67ff62ff5dff58ff53ff4eff49),.INIT_RAM_1F(256'hfffafff4ffedffe7ffe1ffdbffd5ffceffc8ffc2ffbcffb6ffb0ffaaffa4ff9e),.INIT_RAM_20(256'h005c00560050004a0044003e00380032002b0025001f00190013000c00060000),.INIT_RAM_21(256'h00b200ad00a800a3009e00990094008f00890084007e00790073006d00670062),.INIT_RAM_22(256'h00f200ef00ec00e800e500e100dd00da00d600d200cd00c900c500c000bc00b7),.INIT_RAM_23(256'h0115011401120111010f010e010c010a010801050103010100fe00fb00f800f5),.INIT_RAM_24(256'h0117011801190119011a011a011a011a011a011a011a01190119011801170116),.INIT_RAM_25(256'h00fb00fe01000103010501070109010b010d010f011001120113011401160117),.INIT_RAM_26(256'h00c700cb00cf00d300d600da00dd00e100e400e700ea00ed00f000f300f600f9),.INIT_RAM_27(256'h00840089008d00910096009a009e00a300a700ab00af00b300b700bc00bf00c3),.INIT_RAM_28(256'h003d00410045004a004e00530057005c006000650069006e00720077007b0080),.INIT_RAM_29(256'hfffafffe00020006000a000e00120016001a001e00230027002b002f00340038),.INIT_RAM_2A(256'hffc5ffc8ffcbffceffd1ffd4ffd7ffdbffdeffe1ffe5ffe8ffecffeffff3fff7),.INIT_RAM_2B(256'hffa0ffa2ffa4ffa6ffa8ffaaffacffaeffb1ffb3ffb5ffb8ffbaffbdffc0ffc2),.INIT_RAM_2C(256'hff8aff8bff8cff8dff8fff90ff91ff92ff94ff95ff96ff98ff9aff9bff9dff9e),.INIT_RAM_2D(256'hff7dff7eff7fff80ff80ff81ff82ff82ff83ff84ff85ff86ff87ff87ff88ff89),.INIT_RAM_2E(256'hff70ff71ff72ff73ff74ff75ff76ff77ff77ff78ff79ff7aff7aff7bff7cff7d),.INIT_RAM_2F(256'hff56ff58ff5aff5cff5eff60ff62ff63ff65ff67ff68ff6aff6bff6cff6dff6f),.INIT_RAM_30(256'hff23ff27ff2bff2fff33ff36ff3aff3dff40ff43ff46ff49ff4cff4eff51ff53),.INIT_RAM_31(256'hfecffed5fedcfee2fee8feedfef3fef8fefeff03ff08ff0dff12ff16ff1bff1f),.INIT_RAM_32(256'hfe54fe5dfe66fe6efe77fe7ffe87fe8ffe97fe9efea6feadfeb4febbfec2fec8),.INIT_RAM_33(256'hfdb4fdbffdcafdd5fde0fdeafdf4fdfffe09fe13fe1cfe26fe30fe39fe42fe4b),.INIT_RAM_34(256'hfcf7fd04fd10fd1cfd29fd35fd41fd4dfd59fd64fd70fd7cfd87fd93fd9efda9),.INIT_RAM_35(256'hfc2cfc38fc45fc52fc5ffc6cfc78fc85fc92fc9ffcacfcb8fcc5fcd2fcdefceb),.INIT_RAM_36(256'hfb65fb71fb7dfb89fb95fba1fbaefbbafbc6fbd3fbdffbecfbf9fc05fc12fc1f),.INIT_RAM_37(256'hfabcfac5facffad8fae2faecfaf6fb01fb0bfb16fb21fb2cfb37fb43fb4efb5a),.INIT_RAM_38(256'hfa46fa4bfa51fa57fa5dfa64fa6bfa72fa79fa81fa88fa90fa99faa1faaafab3),.INIT_RAM_39(256'hfa19fa19fa1afa1bfa1cfa1efa20fa22fa25fa28fa2cfa2ffa33fa37fa3cfa41),.INIT_RAM_3A(256'hfa43fa3efa39fa34fa30fa2cfa28fa25fa22fa20fa1efa1cfa1bfa1afa19fa19),.INIT_RAM_3B(256'hfaccfac0fab5faabfaa0fa97fa8dfa84fa7bfa73fa6bfa63fa5cfa55fa4ffa49),.INIT_RAM_3C(256'hfbb0fb9ffb8ffb7ffb6ffb5ffb50fb41fb33fb25fb17fb09fafcfaf0fae3fad7),.INIT_RAM_3D(256'hfce5fcd0fcbbfca6fc91fc7dfc69fc55fc42fc2efc1cfc09fbf7fbe5fbd3fbc1),.INIT_RAM_3E(256'hfe55fe3dfe25fe0dfdf5fdddfdc6fdaffd97fd80fd6afd53fd3dfd26fd10fcfb),.INIT_RAM_3F(256'hffe7ffcdffb4ff9aff81ff68ff4eff35ff1cff03feeafed1feb8fe9ffe86fe6e)) bank_2(
.DO(bank_data[2]),.DI(32'd0),.BLKSEL(3'd0),.AD({address[9:0],4'd0}),.WRE(1'b0),.CLK(clk),.CE(enable&&address[11:10]==2),.OCE(1'b1),.RESET(1'b0));
assign data=bank_data[bank_q][15:0];
endmodule
