Ring-F-nebula/fpga-multitimbral-instrument/firmware/src/panel_map_address.v

// Parallel, mutually exclusive rectangle decoders, with dynamic labels
// taking priority over matrix labels. Latency and ROM addresses unchanged.
module panel_map_address(input [10:0] x,input [9:0] y,input [2:0] page_q,input [1:0] instrument_q,
 input [1:0] record_button_state,input [2:0] event_label_state,audio_label_state,practice_label_state,
 input [2:0] matrix_status,matrix_feedback,input running_q,finished_q,input [255:0] info_q,output [13:0] map_address);
 reg [7:0] map_row_base;
 always @*case(page_q)
 0:map_row_base=0;1:map_row_base=38;2:map_row_base=76;3:map_row_base=114;
 4:map_row_base=152;5:map_row_base=190;6:map_row_base=228;default:map_row_base=10;
 endcase

 wire [17:0] matrix_hit;
 wire [13:0] matrix_tree[1:63];
 wire [7:0] matrix_row_0=8'd227+{2'd0,y[9:4]};
 assign matrix_hit[0]=(page_q==6&&x>=0&&x<1024&&y>=16&&y<112);
 assign matrix_tree[32]=matrix_hit[0] ? {matrix_row_0,x[9:4]} : 14'd0;
 wire [7:0] matrix_row_1=8'd199+{2'd0,y[9:4]};
 assign matrix_hit[1]=(page_q==6&&x>=0&&x<1024&&y>=560&&y<592);
 assign matrix_tree[33]=matrix_hit[1] ? {matrix_row_1,x[9:4]} : 14'd0;
 wire [1:0] matrix_col_2=x[5:4]-2'd2;
 assign matrix_hit[2]=(page_q==6&&x>=96&&x<160&&y>=192&&y<208);
 assign matrix_tree[34]=matrix_hit[2] ? {12'd3776,matrix_col_2} : 14'd0;
 wire [1:0] matrix_col_3=x[5:4]-2'd2;
 assign matrix_hit[3]=(page_q==6&&x>=352&&x<416&&y>=192&&y<208);
 assign matrix_tree[35]=matrix_hit[3] ? {12'd3777,matrix_col_3} : 14'd0;
 wire [1:0] matrix_col_4=x[5:4]-2'd2;
 assign matrix_hit[4]=(page_q==6&&x>=608&&x<672&&y>=192&&y<208);
 assign matrix_tree[36]=matrix_hit[4] ? {12'd3778,matrix_col_4} : 14'd0;
 wire [1:0] matrix_col_5=x[5:4]-2'd2;
 assign matrix_hit[5]=(page_q==6&&x>=864&&x<928&&y>=192&&y<208);
 assign matrix_tree[37]=matrix_hit[5] ? {12'd3779,matrix_col_5} : 14'd0;
 wire [1:0] matrix_col_6=x[5:4]-2'd2;
 assign matrix_hit[6]=(page_q==6&&x>=96&&x<160&&y>=304&&y<320);
 assign matrix_tree[38]=matrix_hit[6] ? {12'd3780,matrix_col_6} : 14'd0;
 wire [1:0] matrix_col_7=x[5:4]-2'd2;
 assign matrix_hit[7]=(page_q==6&&x>=352&&x<416&&y>=304&&y<320);
 assign matrix_tree[39]=matrix_hit[7] ? {12'd3781,matrix_col_7} : 14'd0;
 wire [1:0] matrix_col_8=x[5:4]-2'd2;
 assign matrix_hit[8]=(page_q==6&&x>=608&&x<672&&y>=304&&y<320);
 assign matrix_tree[40]=matrix_hit[8] ? {12'd3782,matrix_col_8} : 14'd0;
 wire [1:0] matrix_col_9=x[5:4]-2'd2;
 assign matrix_hit[9]=(page_q==6&&x>=864&&x<928&&y>=304&&y<320);
 assign matrix_tree[41]=matrix_hit[9] ? {12'd3783,matrix_col_9} : 14'd0;
 wire [1:0] matrix_col_10=x[5:4]-2'd2;
 assign matrix_hit[10]=(page_q==6&&x>=96&&x<160&&y>=416&&y<432);
 assign matrix_tree[42]=matrix_hit[10] ? {12'd3784,matrix_col_10} : 14'd0;
 wire [1:0] matrix_col_11=x[5:4]-2'd2;
 assign matrix_hit[11]=(page_q==6&&x>=352&&x<416&&y>=416&&y<432);
 assign matrix_tree[43]=matrix_hit[11] ? {12'd3785,matrix_col_11} : 14'd0;
 wire [1:0] matrix_col_12=x[5:4]-2'd2;
 assign matrix_hit[12]=(page_q==6&&x>=608&&x<672&&y>=416&&y<432);
 assign matrix_tree[44]=matrix_hit[12] ? {12'd3786,matrix_col_12} : 14'd0;
 wire [1:0] matrix_col_13=x[5:4]-2'd2;
 assign matrix_hit[13]=(page_q==6&&x>=864&&x<928&&y>=416&&y<432);
 assign matrix_tree[45]=matrix_hit[13] ? {12'd3787,matrix_col_13} : 14'd0;
 wire [1:0] matrix_col_14=x[5:4]-2'd2;
 assign matrix_hit[14]=(page_q==6&&x>=96&&x<160&&y>=528&&y<544);
 assign matrix_tree[46]=matrix_hit[14] ? {12'd3788,matrix_col_14} : 14'd0;
 wire [1:0] matrix_col_15=x[5:4]-2'd2;
 assign matrix_hit[15]=(page_q==6&&x>=352&&x<416&&y>=528&&y<544);
 assign matrix_tree[47]=matrix_hit[15] ? {12'd3789,matrix_col_15} : 14'd0;
 wire [1:0] matrix_col_16=x[5:4]-2'd2;
 assign matrix_hit[16]=(page_q==6&&x>=608&&x<672&&y>=528&&y<544);
 assign matrix_tree[48]=matrix_hit[16] ? {12'd3790,matrix_col_16} : 14'd0;
 wire [1:0] matrix_col_17=x[5:4]-2'd2;
 assign matrix_hit[17]=(page_q==6&&x>=864&&x<928&&y>=528&&y<544);
 assign matrix_tree[49]=matrix_hit[17] ? {12'd3791,matrix_col_17} : 14'd0;
 assign matrix_tree[50]=14'd0;
 assign matrix_tree[51]=14'd0;
 assign matrix_tree[52]=14'd0;
 assign matrix_tree[53]=14'd0;
 assign matrix_tree[54]=14'd0;
 assign matrix_tree[55]=14'd0;
 assign matrix_tree[56]=14'd0;
 assign matrix_tree[57]=14'd0;
 assign matrix_tree[58]=14'd0;
 assign matrix_tree[59]=14'd0;
 assign matrix_tree[60]=14'd0;
 assign matrix_tree[61]=14'd0;
 assign matrix_tree[62]=14'd0;
 assign matrix_tree[63]=14'd0;
 assign matrix_tree[31]=matrix_tree[62]|matrix_tree[63];
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
 wire [7:0] base_row=map_row_base+{2'd0,y[9:4]};
 wire blank=page_q==6 || (page_q==0&&instrument_q==1&&x>=128&&((y>=368&&y<424)||(y>=64&&y<96&&x<512)));
 assign map_address=(|dynamic_hit)?dynamic_tree[1]:(|matrix_hit)?matrix_tree[1]:blank?14'd16383:{base_row,x[9:4]};
endmodule
