Ring-F-nebula/fpga-multitimbral-instrument/firmware/src/panel_rom.v

// Generated initialized Arora V SP BSRAM. See UG300 section 3.2.
// Same two-cycle text / one-cycle digit latency as the behavioral reference.
module panel_rom(input clk,input [13:0] map_address,input [3:0] row,
    output [31:0] text_row,input [8:0] digit_address,output [31:0] digit_row);
    wire [15:0] tile,text_bits;reg [3:0] row_q=0;
    always @(posedge clk)row_q<=row;
    panel_map_sp map(.clk(clk),.address(map_address),.data(tile));
    panel_text_sp text_pixels(.clk(clk),.address({tile[10:0],row_q}),.data(text_bits));
    genvar px;generate for(px=0;px<16;px=px+1)begin:expand_coverage
        assign text_row[px*2+:2]={2{text_bits[px]}};
    end endgenerate
    panel_digits_sp digit_pixels(.clk(clk),.address(digit_address),.data(digit_row));
endmodule
module panel_map_sp(input clk,input [13:0] address,output [15:0] data);
wire [31:0] bank_data[0:15];reg [3:0] bank_q=0;
always @(posedge clk)bank_q<=address[13:10];
SP #(.BIT_WIDTH(16),.READ_MODE(1'b0),.WRITE_MODE(2'b00),.INIT_RAM_04(256'h0000000000000000000500040003000200000000000000000000000100000000),.INIT_RAM_06(256'h0000000000000000000000000000000000000008000700060000000000000000),.INIT_RAM_08(256'h0000000000000000000e000d000c000b0000000000000000000a000900000000),.INIT_RAM_0A(256'h0000000000000014001300000000000000000012001100100000000f00000000),.INIT_RAM_0B(256'h00000000001f001e001d001c001b001a00000000000000190018001700160015),.INIT_RAM_0C(256'h0000000000000000002500240023002200000000000000000021002000000000),.INIT_RAM_0E(256'h0000000000000000002600000000000000000000000000000000000000000000),.INIT_RAM_0F(256'h000000000000002f002e002d002c0000000000000000002b002a002900280027),.INIT_RAM_10(256'h0037003600350034003300320031003000000000000000000000000000000000),.INIT_RAM_11(256'h0000000000000000000000000000000000000000000000000000003a00390038),.INIT_RAM_14(256'h004200410040003f003e003d003c003b00000000000000000000000000000000),.INIT_RAM_15(256'h0000000000000000000000000000000000000000000000000000004500440043),.INIT_RAM_1C(256'h0048004700460000000000000000000000000000000000000000000000000000),.INIT_RAM_1D(256'h00000000004b004a004900000000000000000000000000000000000000000000),.INIT_RAM_1E(256'h0000000000000050004f004e004d004c00000000000000000000000000000000),.INIT_RAM_20(256'h0056005500540000000000000000000000000000000000530052005100000000),.INIT_RAM_21(256'h0000000000590058005700000000000000000000000000000000000000000000),.INIT_RAM_22(256'h000000000000005e005d005c005b005a00000000000000000000000000000000),.INIT_RAM_24(256'h0000000000000000000000000000000000000000000000610060005f00000000),.INIT_RAM_2C(256'h0000000000660065006400630062000000000000000000000000000000000000),.INIT_RAM_2E(256'h006c006b000000000000000000000000006a0069000000000000006800670000),.INIT_RAM_2F(256'h000000000000000000710070006f006e0000000000000000000000000000006d),.INIT_RAM_30(256'h0000000000760075007400730072000000000000000000000000000000000000),.INIT_RAM_31(256'h0000000000790078007700000000000000000000000000000000000000000000),.INIT_RAM_32(256'h00820081000000000000000000000080007f007e007d00000000007c007b007a),.INIT_RAM_33(256'h0000000000000000008800870086008500000000000000000000000000840083),.INIT_RAM_34(256'h00000000000000000000000000000000000000000000008b008a008900000000),.INIT_RAM_38(256'h00000000000000000000000000000000000000000000008e008d008c00000000)) bank_0(
.DO(bank_data[0]),.DI(32'd0),.BLKSEL(3'd0),.AD({address[9:0],4'd0}),
.WRE(1'b0),.CLK(clk),.CE(address[13:10]==0),.OCE(1'b1),.RESET(1'b0));
SP #(.BIT_WIDTH(16),.READ_MODE(1'b0),.WRITE_MODE(2'b00),.INIT_RAM_08(256'h0000000000000000000000000000000000000000000000910090008f00000000),.INIT_RAM_0C(256'h0000000000000000000000000000000000000000000000940093009200000000),.INIT_RAM_14(256'h0000000000000000000000960095000000000000000000000000000000000000),.INIT_RAM_15(256'h0000000000000000009b009a0000000000000000000000000099009800970000),.INIT_RAM_16(256'h009d009c00000000000000000000000000000000000000000000000000000000),.INIT_RAM_17(256'h00000000000000a300a200a1000000000000000000000000000000a0009f009e),.INIT_RAM_18(256'h0000000000000000000000a600a50000000000000000000000a4000000000000),.INIT_RAM_19(256'h000000000000000000aa00a9000000000000000000000000000000a800a70000),.INIT_RAM_1A(256'h00ac00ab00000000000000000000000000000000000000000000000000000000),.INIT_RAM_1B(256'h000000000000000000b100b0000000000000000000000000000000af00ae00ad),.INIT_RAM_1C(256'h0000000000000000000000000000000000000000000000b400b300b200000000),.INIT_RAM_1D(256'h000000c000bf00be00bd00bc00bb00ba00b900b800b700b600b5000000000000),.INIT_RAM_21(256'h000000cc00cb00ca00c900c800c700c600c500c400c300c200c1000000000000),.INIT_RAM_2C(256'h0000000000000000000000000000000000000000000000cf00ce00cd00000000),.INIT_RAM_30(256'h0000000000000000000000000000000000000000000000d200d100d000000000)) bank_1(
.DO(bank_data[1]),.DI(32'd0),.BLKSEL(3'd0),.AD({address[9:0],4'd0}),
.WRE(1'b0),.CLK(clk),.CE(address[13:10]==1),.OCE(1'b1),.RESET(1'b0));
SP #(.BIT_WIDTH(16),.READ_MODE(1'b0),.WRITE_MODE(2'b00),.INIT_RAM_00(256'h0000000000000000000000000000000000000000000000d500d400d300000000),.INIT_RAM_04(256'h0000000000000000000000000000000000000000000000d800d700d600000000),.INIT_RAM_0C(256'h0000000000000000000000000000000000000000000000dc00db00da00d90000),.INIT_RAM_10(256'h0000000000000000000000000000000000000000000000e000df00de00dd0000),.INIT_RAM_1C(256'h000000000000000000e400e300e200e100000000000000000000000100000000),.INIT_RAM_1E(256'h0000000000000000000000000000000000000008000700060000000000000000),.INIT_RAM_20(256'h000000000000000000e800e700e600e50000000000000000000a000900000000),.INIT_RAM_22(256'h0000000000000014001300000000000000000012001100100000000f00000000),.INIT_RAM_23(256'h00000000001f001e001d001c001b001a00000000000000190018001700160015),.INIT_RAM_24(256'h000000000000000000ec00eb00ea00e900000000000000000021002000000000),.INIT_RAM_26(256'h0000000000000000002600000000000000000000000000000000000000000000),.INIT_RAM_27(256'h000000000000002f002e002d002c0000000000000000002b002a002900280027),.INIT_RAM_28(256'h00f400f300f200f100f000ef00ee00ed00000000000000000000000000000000),.INIT_RAM_29(256'h0000000000000000000000000000000000000000000000f900f800f700f600f5),.INIT_RAM_2C(256'h0101010000ff00fe00fd00fc00fb00fa00000000000000000000000000000000),.INIT_RAM_2D(256'h0000000000000000000000000000000000000000000001060105010401030102),.INIT_RAM_34(256'h0000010a01090108006800000107000000000000000000000000000000000000),.INIT_RAM_36(256'h0000000000000000010f010a010e010d010c010b000000000000000000000000),.INIT_RAM_38(256'h0000011501140113011201110110000000000000000000530052005100000000),.INIT_RAM_39(256'h0117011600000000000000000000000000000000000000000000000000000000),.INIT_RAM_3A(256'h000000000000011f011e011d011c011b011a0119011800000000000000000000),.INIT_RAM_3C(256'h0126012501240123012201210120000000000000000000610060005f00000000),.INIT_RAM_3D(256'h0000000000000000000000000000000000000000012c012b012a012901280127),.INIT_RAM_3E(256'h00000000000001340133013201310130012f012e012d00000000000000000000)) bank_2(
.DO(bank_data[2]),.DI(32'd0),.BLKSEL(3'd0),.AD({address[9:0],4'd0}),
.WRE(1'b0),.CLK(clk),.CE(address[13:10]==2),.OCE(1'b1),.RESET(1'b0));
SP #(.BIT_WIDTH(16),.READ_MODE(1'b0),.WRITE_MODE(2'b00),.INIT_RAM_00(256'h013b013a01390138013701360135000000000000000000000000000000000000),.INIT_RAM_01(256'h000000000000000000000000000000000000000001410140013f013e013d013c),.INIT_RAM_06(256'h0000000000000000000000000000000001440143014200000000000000000000),.INIT_RAM_07(256'h0000000000000147014601450000000000000000000000000000000000000000),.INIT_RAM_0A(256'h00000000000000000000000000000000014a0149014800000000000000000000),.INIT_RAM_0B(256'h000000000000014d014c014b0000000000000000000000000000000000000000),.INIT_RAM_0C(256'h00000000000001510150014f014e0000000000000000008b008a008900000000),.INIT_RAM_10(256'h00000157015601550154015301520000000000000000008e008d008c00000000),.INIT_RAM_11(256'h0159000000000000015800000000000000000000000000000000000000000000),.INIT_RAM_12(256'h000000000000000000000000015f015e015d015c015b0000000000000000015a),.INIT_RAM_13(256'h0000000000000162016100000000000000000160000000000000000000000000),.INIT_RAM_16(256'h0000000000000000000000000167016601650164016300000000000000000000),.INIT_RAM_17(256'h0000000000000169016800000000000000000000000000000000000000000000),.INIT_RAM_1E(256'h00000000000000000000000000000000016c016b016a00000000000000000000),.INIT_RAM_1F(256'h000000000000016f016e016d0000000000000000000000000000000000000000),.INIT_RAM_20(256'h0000017501740173017201710170000000000000000000910090008f00000000),.INIT_RAM_21(256'h0177000000000000017600000000000000000000000000000000000000000000),.INIT_RAM_22(256'h00000000000000000000000000000000017b017a017900000000000000000178),.INIT_RAM_23(256'h000000000000017e017d017c0000000000000000000000000000000000000000),.INIT_RAM_24(256'h000001840183018201810180017f000000000000000000940093009200000000),.INIT_RAM_25(256'h0185000000000000000000000000000000000000000000000000000000000000),.INIT_RAM_2A(256'h0000000000000000000000000000018901880187018600000000000000000000),.INIT_RAM_2E(256'h000000000000000000000000018e018d018c018b018a00000000000000000000),.INIT_RAM_2F(256'h000000000000019101900000000000000000018f000000000000000000000000),.INIT_RAM_30(256'h00000000019601950194019301920000000000000000000000a4000000000000),.INIT_RAM_34(256'h0000019c019b019a019901980197000000000000000000b400b300b200000000),.INIT_RAM_35(256'h0159000000000000015800000000000000000000000000000000000000000000),.INIT_RAM_36(256'h00000000000000000000000001a0019f0000019e019d0000000000000000015a),.INIT_RAM_3A(256'h00000000000000000000000001a501a401a301a201a100000000000000000000),.INIT_RAM_3B(256'h000000000000019101900000000000000000018f000000000000000000000000)) bank_3(
.DO(bank_data[3]),.DI(32'd0),.BLKSEL(3'd0),.AD({address[9:0],4'd0}),
.WRE(1'b0),.CLK(clk),.CE(address[13:10]==3),.OCE(1'b1),.RESET(1'b0));
SP #(.BIT_WIDTH(16),.READ_MODE(1'b0),.WRITE_MODE(2'b00),.INIT_RAM_02(256'h00000000000000000000000001a0019f018801a701a600000000000000000000),.INIT_RAM_04(256'h000001ad01ac01ab01aa01a901a8000000000000000000cf00ce00cd00000000),.INIT_RAM_05(256'h0177000000000000017600000000000000000000000000000000000000000000),.INIT_RAM_06(256'h00000000000000000000000001a501a401b001af01ae00000000000000000178),.INIT_RAM_07(256'h000000000000019101900000000000000000018f000000000000000000000000),.INIT_RAM_08(256'h000001b601b501b401b301b201b1000000000000000000d200d100d000000000),.INIT_RAM_09(256'h0185000000000000000000000000000000000000000000000000000000000000),.INIT_RAM_0E(256'h000000000000000001bc01bb000001ba01b901b801b700000000000000000000),.INIT_RAM_10(256'h000001c101c001bf01be01bd0000000000000000000000000000000000000000),.INIT_RAM_11(256'h01cb01ca01c901c801c700000000000001c601c501c401c301c2000000000000),.INIT_RAM_12(256'h000000000000000001d201d101d001cf01ce01cd01cc00000000000000000000),.INIT_RAM_13(256'h000000000000019101900000000000000000018f000000000000000000000000),.INIT_RAM_14(256'h000001d701d601d501d401d30000000000000000000000000000000000000000),.INIT_RAM_15(256'h01e001df01de01dd01dc000000000000000001db01da01d901d8000000000000),.INIT_RAM_18(256'h0000000000000000000000000000000000000000000000d500d400d300000000),.INIT_RAM_1C(256'h0000000000000000000000000000000000000000000000d800d700d600000000),.INIT_RAM_20(256'h01e3000000000000000001e201e1000000000000000000000000000000000000),.INIT_RAM_21(256'h01e900000000000000000000000001e801e701e60000000001e50000000001e4),.INIT_RAM_22(256'h0000000001f001ef01ee01ed01ec0000000000000000000001eb01ea00000000),.INIT_RAM_24(256'h0000000000000000000000000000000000000000000000dc00db00da00d90000),.INIT_RAM_28(256'h0000000000000000000000000000000000000000000000e000df00de00dd0000),.INIT_RAM_34(256'h000000000000000001f401f301f201f100000000000000000000000100000000),.INIT_RAM_36(256'h0000000000000000000000000000000000000008000700060000000000000000),.INIT_RAM_38(256'h000000000000000001f801f701f601f50000000000000000000a000900000000),.INIT_RAM_3A(256'h0000000000000014001300000000000000000012001100100000000f00000000),.INIT_RAM_3B(256'h00000000001f001e001d001c001b001a00000000000000190018001700160015),.INIT_RAM_3C(256'h000000000000000001fc01fb01fa01f900000000000000000021002000000000),.INIT_RAM_3E(256'h0000000000000000002600000000000000000000000000000000000000000000),.INIT_RAM_3F(256'h000000000000002f002e002d002c0000000000000000002b002a002900280027)) bank_4(
.DO(bank_data[4]),.DI(32'd0),.BLKSEL(3'd0),.AD({address[9:0],4'd0}),
.WRE(1'b0),.CLK(clk),.CE(address[13:10]==4),.OCE(1'b1),.RESET(1'b0));
SP #(.BIT_WIDTH(16),.READ_MODE(1'b0),.WRITE_MODE(2'b00),.INIT_RAM_00(256'h0204020302020201020001ff01fe01fd00000000000000000000000000000000),.INIT_RAM_04(256'h020b020a02090208020702060169020500000000000000000000000000000000),.INIT_RAM_10(256'h000000000000020f020e020d020c000000000000000000530052005100000000),.INIT_RAM_11(256'h0000021402130212000000000000000000000211021000000000000000000000),.INIT_RAM_12(256'h0219021800000000000000000217021602150000000000000000000000000000),.INIT_RAM_13(256'h00000000000000000211021000000000000000000000000000000000021b021a),.INIT_RAM_14(256'h000000000000021f021e021d021c000000000000000000610060005f00000000),.INIT_RAM_15(256'h0000022402230222000000000000000000000221022000000000000000000000),.INIT_RAM_16(256'h0229022800000000000000000227022602250000000000000000000000000000),.INIT_RAM_17(256'h00000000000000000221022000000000000000000000000000000000022b022a),.INIT_RAM_20(256'h000000000230022f022e022d022c000000000000000000000000000000000000),.INIT_RAM_21(256'h0234023302320231000000000000000000000000000000000000000000000000),.INIT_RAM_22(256'h0236023500000000000000000000000000000000000000000000000000000000),.INIT_RAM_23(256'h000000000000000000000000000000000000000000000000000000000237022e),.INIT_RAM_24(256'h00000000023c023b023a023902380000000000000000008b008a008900000000),.INIT_RAM_25(256'h0240023f023e023d000000000000000000000000000000000000000000000000),.INIT_RAM_26(256'h0242024100000000000000000000000000000000000000000000000000000000),.INIT_RAM_27(256'h000000000000000000000000000000000000000000000000000000000243023a),.INIT_RAM_28(256'h00000000000000000000000000000000000000000000008e008d008c00000000),.INIT_RAM_2C(256'h0000000000000000024502440000000000000000000000000000000000000000),.INIT_RAM_2D(256'h0000000001760000000000000000000000000246000000000000000000000000),.INIT_RAM_2E(256'h0244000000000000000000000178017700000000000000000000000000000000),.INIT_RAM_2F(256'h0000000000000000024600000000000000000000000000000000000000000245),.INIT_RAM_31(256'h0000000000000000000000000000000000000247000000000000000000000000),.INIT_RAM_32(256'h0000000000000000000000000000018500000000000000000000000000000000),.INIT_RAM_33(256'h0000000000000000024700000000000000000000000000000000000000000000),.INIT_RAM_38(256'h0000000000000237024a02490248000000000000000000910090008f00000000),.INIT_RAM_39(256'h024e024d024c024b000000000000000000000000000000000000000000000000),.INIT_RAM_3A(256'h0250024f00000000000000000000000000000000000000000000000000000000),.INIT_RAM_3B(256'h00000000000000000000000000000000000000000000000000000230022f0251),.INIT_RAM_3C(256'h0000000000000243025402530252000000000000000000940093009200000000),.INIT_RAM_3D(256'h0258025702560255000000000000000000000000000000000000000000000000),.INIT_RAM_3E(256'h025a025900000000000000000000000000000000000000000000000000000000),.INIT_RAM_3F(256'h0000000000000000000000000000000000000000000000000000023c023b025b)) bank_5(
.DO(bank_data[5]),.DI(32'd0),.BLKSEL(3'd0),.AD({address[9:0],4'd0}),
.WRE(1'b0),.CLK(clk),.CE(address[13:10]==5),.OCE(1'b1),.RESET(1'b0));
SP #(.BIT_WIDTH(16),.READ_MODE(1'b0),.WRITE_MODE(2'b00),.INIT_RAM_04(256'h0000000000000000024502440000000000000000000000000000000000000000),.INIT_RAM_05(256'h0000000001760000000000000000000000000246000000000000000000000000),.INIT_RAM_06(256'h0244000000000000000000000178017700000000000000000000000000000000),.INIT_RAM_07(256'h0000000000000000024600000000000000000000000000000000000000000245),.INIT_RAM_08(256'h00000000000000000000000000000000000000000000000000a4000000000000),.INIT_RAM_09(256'h0000000000000000000000000000000000000247000000000000000000000000),.INIT_RAM_0A(256'h0000000000000000000000000000018500000000000000000000000000000000),.INIT_RAM_0B(256'h0000000000000000024700000000000000000000000000000000000000000000),.INIT_RAM_0C(256'h0000000000000000000000000000000000000000000000b400b300b200000000),.INIT_RAM_10(256'h0000000000000237025e025d025c000000000000000000000000000000000000),.INIT_RAM_11(256'h024e024d0260025f000000000000000000000000000000000000000000000000),.INIT_RAM_12(256'h025d025c00000000000000000000000000000000000000000000000000000000),.INIT_RAM_13(256'h000000000000000000000000000000000000000000000000000000000237025e),.INIT_RAM_14(256'h0000000000000243026302620261000000000000000000000000000000000000),.INIT_RAM_15(256'h0258025702650264000000000000000000000000000000000000000000000000),.INIT_RAM_16(256'h0262026100000000000000000000000000000000000000000000000000000000),.INIT_RAM_17(256'h0000000000000000000000000000000000000000000000000000000002430263),.INIT_RAM_1C(256'h0000000000000000024502440000000000000000000000cf00ce00cd00000000),.INIT_RAM_1D(256'h0000000001760000000000000000000000000246000000000000000000000000),.INIT_RAM_1E(256'h0244000000000000000000000178017700000000000000000000000000000000),.INIT_RAM_1F(256'h0000000000000000024600000000000000000000000000000000000000000245),.INIT_RAM_20(256'h0000000000000000000000000000000000000000000000d200d100d000000000),.INIT_RAM_21(256'h0000000000000000000000000000000000000247000000000000000000000000),.INIT_RAM_22(256'h0000000000000000000000000000018500000000000000000000000000000000),.INIT_RAM_23(256'h0000000000000000024700000000000000000000000000000000000000000000),.INIT_RAM_30(256'h0000000000000000000000000000000000000000000000d500d400d300000000),.INIT_RAM_34(256'h0267026600000000000000000000000000000000000000d800d700d600000000),.INIT_RAM_35(256'h0000000000000000000000000000000000000000000000000000000002680000),.INIT_RAM_37(256'h00000000000000000000000000000000026a0269000000000000000000000000),.INIT_RAM_38(256'h026d026c026b0000000000000000000000000000000000000000000000000000),.INIT_RAM_39(256'h02710000000000000000000000000000000000000000000000000270026f026e),.INIT_RAM_3A(256'h0000000000000000000000000000000002790278027702760275027402730272),.INIT_RAM_3B(256'h0000000000000000000002810280027f027e027d027c027b027a000000000000),.INIT_RAM_3C(256'h0000028302820000000000000000000000000000000000dc00db00da00d90000),.INIT_RAM_3D(256'h0000000000000000000000000000000000000000000000000000028500000284),.INIT_RAM_3F(256'h000000000000000000000169028b028a02840289028802870286000000000000)) bank_6(
.DO(bank_data[6]),.DI(32'd0),.BLKSEL(3'd0),.AD({address[9:0],4'd0}),
.WRE(1'b0),.CLK(clk),.CE(address[13:10]==6),.OCE(1'b1),.RESET(1'b0));
SP #(.BIT_WIDTH(16),.READ_MODE(1'b0),.WRITE_MODE(2'b00),.INIT_RAM_00(256'h0000000000000000000000000000000000000000000000e000df00de00dd0000),.INIT_RAM_0C(256'h0000000000000000028f028e028d028c00000000000000000000000100000000),.INIT_RAM_0E(256'h0000000000000000000000000000000000000008000700060000000000000000),.INIT_RAM_10(256'h000000000000000002930292029102900000000000000000000a000900000000),.INIT_RAM_12(256'h0000000000000014001300000000000000000012001100100000000f00000000),.INIT_RAM_13(256'h00000000001f001e001d001c001b001a00000000000000190018001700160015),.INIT_RAM_14(256'h0000000000000000029702960295029400000000000000000021002000000000),.INIT_RAM_16(256'h0000000000000000002600000000000000000000000000000000000000000000),.INIT_RAM_17(256'h000000000000002f002e002d002c0000000000000000002b002a002900280027),.INIT_RAM_18(256'h029f029e029d029c029b029a0299029800000000000000000000000000000000),.INIT_RAM_19(256'h00000000000000000000000000000000000000000000000000000000000002a0),.INIT_RAM_1C(256'h0000000000fe000002a100000169000000000000000000000000000000000000),.INIT_RAM_1D(256'h00000000000000000000000000000000000000000000000000000000000002a2),.INIT_RAM_24(256'h02a902a802a702a602a502a402a3000000000000000000000000000000000000),.INIT_RAM_25(256'h0000000000000000000000000000000002b002af02ae02ad02ac02ab02aa01a6),.INIT_RAM_28(256'h02b702b602b502b402b302b202b1000000000000000000530052005100000000),.INIT_RAM_29(256'h0000000000000000000000000000000002bf02be02bd02bc02bb02ba02b902b8),.INIT_RAM_2A(256'h0000000002c402c302c202c102c0000000000000000000000000000000000000),.INIT_RAM_2B(256'h0000000000000000000002ca02c902c802c702c602c500000000000000000000),.INIT_RAM_2C(256'h02d102d002cf02ce02cd02cc02cb000000000000000000610060005f00000000),.INIT_RAM_2D(256'h0000000000000000000000000000000002d902d802d702d602d502d402d302d2),.INIT_RAM_2E(256'h0000000002de02dd02dc02db02da000000000000000000000000000000000000),.INIT_RAM_2F(256'h000000000000000002e502e402e302e202e102e002df00000000000000000000),.INIT_RAM_30(256'h02ec02eb02ea02e902e802e702e6000000000000000000000000000000000000),.INIT_RAM_31(256'h0000000000000000000002f702f602f502f402f302f202f102f002ef02ee02ed),.INIT_RAM_34(256'h000002fc02fb02fa000002f902f8000000000000000000000000000000000000),.INIT_RAM_35(256'h000000000000000000000306030503040303030203010300000002ff02fe02fd),.INIT_RAM_3C(256'h00000000000000000000000000000000000000000000008b008a008900000000)) bank_7(
.DO(bank_data[7]),.DI(32'd0),.BLKSEL(3'd0),.AD({address[9:0],4'd0}),
.WRE(1'b0),.CLK(clk),.CE(address[13:10]==7),.OCE(1'b1),.RESET(1'b0));
SP #(.BIT_WIDTH(16),.READ_MODE(1'b0),.WRITE_MODE(2'b00),.INIT_RAM_00(256'h00000000030b030a0309030803070000000000000000008e008d008c00000000),.INIT_RAM_04(256'h000000000310030f030e030d030c000000000000000000000000000000000000),.INIT_RAM_05(256'h0000017801770000000000000245024400000000000000000000000000000000),.INIT_RAM_06(256'h0315031400000000000000000000031303120311000000000000000000000000),.INIT_RAM_07(256'h00000000000000000000031b031a031903180317000000000000000000000316),.INIT_RAM_09(256'h0000000001850000000000000000000000000000000000000000000000000000),.INIT_RAM_0A(256'h0320031f00000000000000000000031e031d031c000000000000000000000000),.INIT_RAM_0B(256'h0000000000000000000003260325032403230322000000000000000000000321),.INIT_RAM_10(256'h0000000000000000000000000000000000000000000000910090008f00000000),.INIT_RAM_14(256'h0000000000000000000000000000000000000000000000940093009200000000),.INIT_RAM_18(256'h0000000000000000032903280327000000000000000000000000000000000000),.INIT_RAM_19(256'h032e032d000000000000000000000000032c032b032a00000000000000000000),.INIT_RAM_1A(256'h000000000000000000000000033203310330000000000000000000000000032f),.INIT_RAM_1B(256'h0000000000000000000000000000000000000000033503340333000000000000),.INIT_RAM_1C(256'h0000000000000000033803370336000000000000000000000000000000000000),.INIT_RAM_1D(256'h033d033c000000000000000000000000033b033a033900000000000000000000),.INIT_RAM_1E(256'h00000000000000000000000003410340033f000000000000000000000000033e),.INIT_RAM_1F(256'h0000000000000000000000000000000000000000034403430342000000000000),.INIT_RAM_20(256'h00000000000000000000000000000000000000000000000000a4000000000000),.INIT_RAM_24(256'h0000000000000000000000000000000000000000000000b400b300b200000000),.INIT_RAM_34(256'h0000000000000000000000000000000000000000000000cf00ce00cd00000000),.INIT_RAM_38(256'h034b034a03490348034703460345000000000000000000d200d100d000000000),.INIT_RAM_39(256'h000000000000000000000000000000000000000000000350034f034e034d034c),.INIT_RAM_3A(256'h0351000000000000000000000000000000000000000000000000000000000000),.INIT_RAM_3B(256'h0000000000000000000000000000000000000358035703560355035403530352),.INIT_RAM_3C(256'h035f035e035d035c035b035a0359000000000000000000000000000000000000),.INIT_RAM_3D(256'h0000000000000000000000000000000000000000036503640363036203610360),.INIT_RAM_3E(256'h0366000000000000000000000000000000000000000000000000000000000000),.INIT_RAM_3F(256'h000000000000000000000000000000000000036d036c036b036a036903680367)) bank_8(
.DO(bank_data[8]),.DI(32'd0),.BLKSEL(3'd0),.AD({address[9:0],4'd0}),
.WRE(1'b0),.CLK(clk),.CE(address[13:10]==8),.OCE(1'b1),.RESET(1'b0));
SP #(.BIT_WIDTH(16),.READ_MODE(1'b0),.WRITE_MODE(2'b00),.INIT_RAM_08(256'h0000000000000000000000000000000000000000000000d500d400d300000000),.INIT_RAM_0C(256'h0000000000000000000000000000000000000000000000d800d700d600000000),.INIT_RAM_14(256'h0000000000000000000000000000000000000000000000dc00db00da00d90000),.INIT_RAM_18(256'h0000000000000000000000000000000000000000000000e000df00de00dd0000),.INIT_RAM_24(256'h000000000000000003710370036f036e00000000000000000000000100000000),.INIT_RAM_26(256'h0000000000000000000000000000000000000008000700060000000000000000),.INIT_RAM_28(256'h000000000000000003750374037303720000000000000000000a000900000000),.INIT_RAM_2A(256'h0000000000000014001300000000000000000012001100100000000f00000000),.INIT_RAM_2B(256'h00000000001f001e001d001c001b001a00000000000000190018001700160015),.INIT_RAM_2C(256'h0000000000000000037903780377037600000000000000000021002000000000),.INIT_RAM_2E(256'h0000000000000000002600000000000000000000000000000000000000000000),.INIT_RAM_2F(256'h000000000000002f002e002d002c0000000000000000002b002a002900280027),.INIT_RAM_30(256'h03810380037f037e037d037c037b037a00000000000000000000000000000000),.INIT_RAM_31(256'h0000000000000000038d038c038b038a03890388038703860385038403830382),.INIT_RAM_34(256'h039503940393039203910390038f038e00000000000000000000000000000000),.INIT_RAM_35(256'h0000000000000000016903a0039f039e039d039c039b039a0399039803970396),.INIT_RAM_3C(256'h03a703a603a503a403a303a203a1000000000000000000000000000000000000),.INIT_RAM_3D(256'h00000000000000000000000000000000000000000000000003ab03aa03a903a8)) bank_9(
.DO(bank_data[9]),.DI(32'd0),.BLKSEL(3'd0),.AD({address[9:0],4'd0}),
.WRE(1'b0),.CLK(clk),.CE(address[13:10]==9),.OCE(1'b1),.RESET(1'b0));
SP #(.BIT_WIDTH(16),.READ_MODE(1'b0),.WRITE_MODE(2'b00),.INIT_RAM_00(256'h03b203b103b003af03ae03ad03ac000000000000000000530052005100000000),.INIT_RAM_01(256'h00000000000000000000000000000000000000000000000003b603b503b403b3),.INIT_RAM_02(256'h03c103c003bf03be03bd03bc03bb03ba03b903b803b700000000000000000000),.INIT_RAM_03(256'h00000000000000000000000000000000000000000000000000000000000003c2),.INIT_RAM_04(256'h0000000000000000000000000000000000000000000000610060005f00000000),.INIT_RAM_0C(256'h03c503c403c30000000000000000000000000000000000000000000000000000),.INIT_RAM_0D(256'h00000000000000000000000003c803c703c60000000000000000000000000000),.INIT_RAM_0E(256'h000003cf03ce03cd03cc000000000000000000000000000003cb03ca03c90000),.INIT_RAM_0F(256'h00000000000000000000000003d403d303d203d103d000000000000000000000),.INIT_RAM_10(256'h016903d603d50000000000000000000000000000000000000000000000000000),.INIT_RAM_11(256'h00000000000000000000000003d903d803d70000000000000000000000000000),.INIT_RAM_12(256'h000003e003df03de03dd000000000000000000000000000003dc03db03da0000),.INIT_RAM_13(256'h00000000000000000000000003e503e403e303e203e100000000000000000000),.INIT_RAM_14(256'h00000000000000000000000000000000000000000000008b008a008900000000),.INIT_RAM_18(256'h00000000000000000000000000000000000000000000008e008d008c00000000),.INIT_RAM_24(256'h03ec03eb03ea03e903e803e703e6000000000000000000000000000000000000),.INIT_RAM_25(256'h00000000000000000000000000000000000000000000000000000000000003ed),.INIT_RAM_26(256'h0000000003f603f503f403f303f203f103f003ef03ee00000000000000000000),.INIT_RAM_28(256'h03fd03fc03fb03fa03f903f803f7000000000000000000910090008f00000000),.INIT_RAM_29(256'h00000000000000000000000000000000000000000000000000000000000003fe),.INIT_RAM_2A(256'h000000000407040604050404040304020401040003ff00000000000000000000),.INIT_RAM_2C(256'h0000000000000000000000000000000000000000000000940093009200000000),.INIT_RAM_30(256'h000000000000040b040a04090408000000000000000000000000000000000000),.INIT_RAM_32(256'h00000000000000000000040d040c01a600680000000000000000000000000000),.INIT_RAM_33(256'h00000000000000000000038d040f0108010d040e000000000000000000000000),.INIT_RAM_36(256'h0417041604150000000004140413041204110410000000000000000000000000),.INIT_RAM_37(256'h00000000000000000000041e041d041c041b041a000000000000000004190418),.INIT_RAM_38(256'h000000000423042204210420041f0000000000000000000000a4000000000000),.INIT_RAM_3C(256'h0000000004280427042604250424000000000000000000b400b300b200000000)) bank_10(
.DO(bank_data[10]),.DI(32'd0),.BLKSEL(3'd0),.AD({address[9:0],4'd0}),
.WRE(1'b0),.CLK(clk),.CE(address[13:10]==10),.OCE(1'b1),.RESET(1'b0));
SP #(.BIT_WIDTH(16),.READ_MODE(1'b0),.WRITE_MODE(2'b00),.INIT_RAM_00(256'h0000042e042d042c042b042a0429000000000000000000000000000000000000),.INIT_RAM_02(256'h0000000000000000000000000000043204310430042f00000000000000000000),.INIT_RAM_03(256'h0000000000000000000000000000000004360435043404330000000000000000),.INIT_RAM_04(256'h0000043c043b043a043904380437000000000000000000000000000000000000),.INIT_RAM_0A(256'h00000000000000000000000004410440043f043e043d00000000000000000000),.INIT_RAM_0B(256'h0000000000000000000000000000044604450444044304420000000000000000),.INIT_RAM_0C(256'h0000000000000000000000000000000000000000000000cf00ce00cd00000000),.INIT_RAM_0E(256'h000000000000000000000000044b044a04490448044700000000000000000000),.INIT_RAM_0F(256'h00000000000000000000000000000450044f044e044d044c0000000000000000),.INIT_RAM_10(256'h0000000000000000000000000000000000000000000000d200d100d000000000),.INIT_RAM_18(256'h0454045304520451000000000000000000000000000000000000000000000000),.INIT_RAM_19(256'h045c045b045a0459045804570456000000000000000000000000000000000455),.INIT_RAM_1A(256'h00000000000004610460045f045e045d00000000000000000000000000000000),.INIT_RAM_1B(256'h0000000000000000000004660465046404630462000000000000000000000000),.INIT_RAM_20(256'h0000000000000000000000000000000000000000000000d500d400d300000000),.INIT_RAM_24(256'h000000000000046a046904680467000000000000000000d800d700d600000000),.INIT_RAM_25(256'h000000000000046e046d046c046b000000000000000000000000000000000000),.INIT_RAM_26(256'h000000000000047204710470046f000000000000000000000000000000000000),.INIT_RAM_28(256'h0000000000000476047504740473000000000000000000000000000000000000),.INIT_RAM_29(256'h000000000000047a047904780477000000000000000000000000000000000000),.INIT_RAM_2A(256'h000000000000047e047d047c047b000000000000000000000000000000000000),.INIT_RAM_2C(256'h0000000000000000000000000000000000000000000000dc00db00da00d90000),.INIT_RAM_30(256'h0486048504840483048204810480047f00000000000000e000df00de00dd0000),.INIT_RAM_31(256'h0496049504940493049204910490048f048e048d048c048b048a048904880487),.INIT_RAM_3C(256'h0000000000000000049a04990498049700000000000000000000000100000000),.INIT_RAM_3E(256'h0000000000000000000000000000000000000008000700060000000000000000)) bank_11(
.DO(bank_data[11]),.DI(32'd0),.BLKSEL(3'd0),.AD({address[9:0],4'd0}),
.WRE(1'b0),.CLK(clk),.CE(address[13:10]==11),.OCE(1'b1),.RESET(1'b0));
SP #(.BIT_WIDTH(16),.READ_MODE(1'b0),.WRITE_MODE(2'b00),.INIT_RAM_00(256'h0000000000000000049e049d049c049b0000000000000000000a000900000000),.INIT_RAM_02(256'h0000000000000014001300000000000000000012001100100000000f00000000),.INIT_RAM_03(256'h00000000001f001e001d001c001b001a00000000000000190018001700160015),.INIT_RAM_04(256'h000000000000000004a204a104a0049f00000000000000000021002000000000),.INIT_RAM_06(256'h0000000000000000002600000000000000000000000000000000000000000000),.INIT_RAM_07(256'h000000000000002f002e002d002c0000000000000000002b002a002900280027),.INIT_RAM_08(256'h04aa04a904a804a704a604a504a404a300000000000000000000000000000000),.INIT_RAM_09(256'h0000000000000000000000000000000004b204b104b004af04ae04ad04ac04ab),.INIT_RAM_0C(256'h04ba04b904b804b704b604b504b404b300000000000000000000000000000000),.INIT_RAM_0D(256'h0000000000000000000000000000000004c104c004bf04be02d404bd04bc04bb),.INIT_RAM_14(256'h000004c704c604c504c404c304c2000000000000000000000000000000000000),.INIT_RAM_16(256'h000000000000000004c800000000000000000000000000000000000000000000),.INIT_RAM_18(256'h04cf04ce04cd04cc04cb04ca04c9000000000000000000530052005100000000),.INIT_RAM_1A(256'h000000000000000004d604d504d404d304d204d104d000000000000000000000),.INIT_RAM_1C(256'h04dd04dc04db04da04d904d804d7000000000000000000610060005f00000000),.INIT_RAM_1E(256'h000000000000000004e404e304e204e104e004df04de00000000000000000000),.INIT_RAM_20(256'h04eb04ea04e904e804e704e604e5000000000000000000000000000000000000),.INIT_RAM_21(256'h00000000000000000000000000000000000004f204f104f004ef04ee04ed04ec),.INIT_RAM_22(256'h000004fc04fb04fa04f904f804f704f604f504f404f300000000000000000000),.INIT_RAM_2C(256'h00000000000000000000000000000000000000000000008b008a008900000000),.INIT_RAM_30(256'h00000000000000000000000000000000000000000000008e008d008c00000000),.INIT_RAM_34(256'h000005020501050004ff04fe04fd000000000000000000000000000000000000),.INIT_RAM_36(256'h0000000000000000000005020504050304ff04fe04fd00000000000000000000),.INIT_RAM_38(256'h0000000005090508050705060505000000000000000000000000000000000000),.INIT_RAM_3A(256'h0000000000000000000000000000050a05070506050500000000000000000000)) bank_12(
.DO(bank_data[12]),.DI(32'd0),.BLKSEL(3'd0),.AD({address[9:0],4'd0}),
.WRE(1'b0),.CLK(clk),.CE(address[13:10]==12),.OCE(1'b1),.RESET(1'b0));
SP #(.BIT_WIDTH(16),.READ_MODE(1'b0),.WRITE_MODE(2'b00),.INIT_RAM_00(256'h05110510050f050e050d050c050b000000000000000000910090008f00000000),.INIT_RAM_02(256'h051c051b051a0519051805170516051505140513051200000000000000000000),.INIT_RAM_04(256'h00000000051f051e051d02f80415000000000000000000940093009200000000),.INIT_RAM_06(256'h052400000521052301b40522000000000521052000fe00000000000000000000),.INIT_RAM_10(256'h00000000000000000000000000000000000000000000000000a4000000000000),.INIT_RAM_14(256'h052b052a05290528052705260525000000000000000000b400b300b200000000),.INIT_RAM_15(256'h000000000000000000000000000000000000000005310530052f052e052d052c),.INIT_RAM_16(256'h053c053b053a0539053805370536053505340533053200000000000000000000),.INIT_RAM_17(256'h000000000000000000000000000000000000000000000000000000000000053d),.INIT_RAM_24(256'h0000000000000000000000000000000000000000000000cf00ce00cd00000000),.INIT_RAM_28(256'h053e000000000000000000000000000000000000000000d200d100d000000000),.INIT_RAM_29(256'h000000000000000000000549054805470546054505440543054205410540053f),.INIT_RAM_2A(256'h054c054b054a0000000000000000000000000000000000000000000000000000),.INIT_RAM_2B(256'h0000000000000000000000000000000000000000055205510550054f054e054d),.INIT_RAM_2C(256'h0553000000000000000000000000000000000000000000000000000000000000),.INIT_RAM_2D(256'h00000000000000000000055e055d055c055b055a055905580557055605550554),.INIT_RAM_2E(256'h05610560055f0000000000000000000000000000000000000000000000000000),.INIT_RAM_2F(256'h0000000000000000000000000000000000000000056705660565056405630562),.INIT_RAM_38(256'h0000000000000000000000000000000000000000000000d500d400d300000000),.INIT_RAM_39(256'h0000000000000000000000000000056f056e056d056c056b056a056905680000),.INIT_RAM_3A(256'h0570000000000000000000000000000000000000000000000000000000000000),.INIT_RAM_3B(256'h0000000000000000000000000000000000000000000000000574057305720571),.INIT_RAM_3C(256'h0000000000000000000000000000000000000000000000d800d700d600000000),.INIT_RAM_3D(256'h0000000000000000000000000000057c057b057a057905780577057605750000),.INIT_RAM_3E(256'h057d000000000000000000000000000000000000000000000000000000000000),.INIT_RAM_3F(256'h00000000000000000000000000000000000000000000000005810580057f057e)) bank_13(
.DO(bank_data[13]),.DI(32'd0),.BLKSEL(3'd0),.AD({address[9:0],4'd0}),
.WRE(1'b0),.CLK(clk),.CE(address[13:10]==13),.OCE(1'b1),.RESET(1'b0));
SP #(.BIT_WIDTH(16),.READ_MODE(1'b0),.WRITE_MODE(2'b00),.INIT_RAM_04(256'h0000000000000000000000000000000000000000000000dc00db00da00d90000),.INIT_RAM_08(256'h0588058705860585058405830582000000000000000000e000df00de00dd0000),.INIT_RAM_09(256'h000000000000059505940593059205910590058f058e058d058c058b058a0589),.INIT_RAM_10(256'h059d0000000000000000000000000000059c059b059a05990598059705960000),.INIT_RAM_11(256'h05a1000000000000000005a0059f00000000000000000000000000000000059e),.INIT_RAM_12(256'h0000000000000000000000000000000000000000000000000000000005a305a2),.INIT_RAM_14(256'h0000000000000000000000000000000005aa05a905a805a705a605a505a40000),.INIT_RAM_17(256'h00000000000005af05ae05ad05ac05ab00000000000000000000000000000000),.INIT_RAM_18(256'h05b0000000000000000000000000000000000000000000000000000000000000),.INIT_RAM_19(256'h05b705b605b505b405b30000000000000000000005b2000000000000000005b1),.INIT_RAM_1A(256'h000000000000000000000000000000000000000000000000000005ba05b905b8),.INIT_RAM_1B(256'h00000000000005bf05be05bd05bc05bb00000000000000000000000000000000),.INIT_RAM_1C(256'h05c0000000000000000000000000000000000000000000000000000000000000),.INIT_RAM_1D(256'h05c705c605c505c405c30000000000000000000005c2000000000000000005c1),.INIT_RAM_1E(256'h000000000000000000000000000000000000000000000000000005ca05c905c8),.INIT_RAM_20(256'h05cb000000000000000000000000000000000000000000000000000000000000),.INIT_RAM_21(256'h05db05da05d905d805d705d605d505d405d305d205d105d005cf05ce05cd05cc),.INIT_RAM_22(256'h0000000000000000000000000000000000000000000000000000000005dd05dc),.INIT_RAM_24(256'h05de000000000000000000000000000000000000000000000000000000000000),.INIT_RAM_25(256'h05ee05ed05ec05eb05ea05e905e805e705e605e505e405e305e205e105e005df),.INIT_RAM_26(256'h0000000000000000000000000000000000000000000000000000000005f005ef),.INIT_RAM_28(256'h0000000005f205f1000000000000000000000000000000000000000000000000),.INIT_RAM_29(256'h05f7000000000000000000000000000005f605f505f405f30000000000000000),.INIT_RAM_2A(256'h0000000000000000000006020601060005ff05fe05fd05fc05fb05fa05f905f8),.INIT_RAM_2C(256'h0000000006040603000000000000000000000000000000000000000000000000),.INIT_RAM_2D(256'h0609000000000000000000000000000006080607060606050000000000000000),.INIT_RAM_2E(256'h0000000000000000000006140613061206110610060f060e060d060c060b060a),.INIT_RAM_30(256'h00000000061a0619000000000618000000000000061700000000061606150000),.INIT_RAM_31(256'h00000000061f061900000000061e00000000061d061c00000000061b06150000),.INIT_RAM_32(256'h0000000006270626000006250624062300000622062100000000062006150000),.INIT_RAM_33(256'h00000000062e06260000062d062c06230000062b062a00000000062906280000),.INIT_RAM_34(256'h000000000000063806370636063506340000000000000633063206310630062f),.INIT_RAM_35(256'h00000000000006380637063e063d063c00000000000006330632063b063a0639),.INIT_RAM_36(256'h000000000000064406430642063d063c00000000000006410640063f063a0639),.INIT_RAM_37(256'h000000000000064e064d064c064b064a00000000000006490648064706460645),.INIT_RAM_38(256'h000000000000065806570656065506540000000000000653065206510650064f),.INIT_RAM_39(256'h00000000000006580660065f065e065d0000000000000653065c065b065a0659),.INIT_RAM_3A(256'h000000000000066a066906680667066600000000000006650664066306620661),.INIT_RAM_3B(256'h00000000000006740673067206710670000000000000066f066e066d066c066b),.INIT_RAM_3C(256'h000000000000067e067d067c067b067a00000000000006790678067706760675),.INIT_RAM_3D(256'h000000000000065806570656065506540000000000000653065206510650064f),.INIT_RAM_3E(256'h000000000000000000000684068306820000000000000000000006810680067f),.INIT_RAM_3F(256'h0000000000000000000000000000068600000000000000000000000000000685)) bank_14(
.DO(bank_data[14]),.DI(32'd0),.BLKSEL(3'd0),.AD({address[9:0],4'd0}),
.WRE(1'b0),.CLK(clk),.CE(address[13:10]==14),.OCE(1'b1),.RESET(1'b0));
SP #(.BIT_WIDTH(16),.READ_MODE(1'b0),.WRITE_MODE(2'b00),.INIT_RAM_00(256'h0000000000000000000000000000068600000000000000000000000000000687),.INIT_RAM_01(256'h000000000000000000000000068b068a00000000000000000000000006890688),.INIT_RAM_02(256'h0000000000000000000000000000068d0000000000000000000000000000068c),.INIT_RAM_03(256'h00000000000000000000000006910690000000000000000000000000068f068e),.INIT_RAM_04(256'h0000000000000000000000000695069400000000000000000000000006930692),.INIT_RAM_05(256'h0000000000000674069d069c069b069a000000000000066f0699069806970696),.INIT_RAM_06(256'h000000000000067406a506a406a306a2000000000000066f06a106a0069f069e),.INIT_RAM_07(256'h0000000006b106b006af06ae06ad06ac0000000006ab06aa06a906a806a706a6),.INIT_RAM_08(256'h0000000000000638063706b706b606b50000000000000633063206b406b306b2),.INIT_RAM_09(256'h00000000000006c106c006bf06be06bd00000000000006bc06bb06ba06b906b8),.INIT_RAM_0A(256'h0000000000000000000006c405580557000000000000000006c306c205430542),.INIT_RAM_0B(256'h0000000000000000000006ca06c906c8000000000000000006c306c706c606c5),.INIT_RAM_0C(256'h000000000000000006d206d106d006cf000000000000000006ce06cd06cc06cb),.INIT_RAM_0D(256'h00000000000006dc06db06da06d906d800000000000006d706d606d506d406d3),.INIT_RAM_0E(256'h0000000006e806e706e606e506e406e30000000006e206e106e006df06de06dd),.INIT_RAM_0F(256'h00000000000006ee06ed06ec06b606b500000000000006eb06ea06e906b306b2),.INIT_RAM_10(256'h00000000000006c106c006bf06be06bd00000000000006bc06bb06ba06b906b8),.INIT_RAM_11(256'h0000000000000000000006f406f306f2000000000000000006c306f106f006ef),.INIT_RAM_12(256'h000000000000000006fa06f906f806cf000000000000000006f706f606f506cb),.INIT_RAM_13(256'h000000000000000006d206d106d006cf000000000000000006ce06cd06cc06cb),.INIT_RAM_14(256'h000000000000070006ff06fe06be06bd00000000000006fd06fc06fb06b906b8),.INIT_RAM_15(256'h00000000000000000000070607050704000000000000000006c3070307020701),.INIT_RAM_16(256'h00000000000000000000070d070c070b0000000000000000070a070907080707),.INIT_RAM_17(256'h000000000000000007130712071106cf00000000000000000710070f070e06cb),.INIT_RAM_18(256'h000000000000071d071c071b071a071900000000000007180717071607150714),.INIT_RAM_19(256'h0000072b072a07290728072707260725000007240723072207210720071f071e),.INIT_RAM_1A(256'h000000000737073607350734073307320000000007310730072f072e072d072c),.INIT_RAM_1B(256'h000000000000070006ff06fe06be06bd00000000000006fd06fc06fb06b906b8),.INIT_RAM_1C(256'h00000000000000000000070607050704000000000000000006c3070307020701),.INIT_RAM_1D(256'h00000000000000000000070d070c070b0000000000000000070a070907080707),.INIT_RAM_1E(256'h000000000000000007130712071106cf00000000000000000710070f070e06cb),.INIT_RAM_1F(256'h000000000000073d073c073b06be06bd000000000000073a0739073806b906b8),.INIT_RAM_20(256'h00000000074907480747074607450744000000000743074207410740073f073e),.INIT_RAM_21(256'h0000000007550754075307520751075000000000074f074e074d074c074b074a),.INIT_RAM_22(256'h0000000007610760075f075e075d075c00000000075b075a0759075807570756),.INIT_RAM_23(256'h0000076f076e076d076c076b076a076900000768076707660765076407630762),.INIT_RAM_24(256'h0000000007790778076c07770776077500000000077407730765077207710770),.INIT_RAM_25(256'h0000078707860785078407830782078100000780077f077e077d077c077b077a),.INIT_RAM_26(256'h000000000000079207910790078f078e00000000078d078c078b078a07890788),.INIT_RAM_27(256'h000007a0079f079e079d079c079b079a00000799079807970796079507940793),.INIT_RAM_28(256'h0000000000000000000007a2063506340000000000000000000007a10630062f),.INIT_RAM_29(256'h0000000000000000000007a807a707a60000000000000000000007a507a407a3),.INIT_RAM_2A(256'h00000000000000000000000007ac067a0000000000000000000007ab07aa07a9),.INIT_RAM_2B(256'h0000000000000000000007b207b107b00000000000000000000007af07ae07ad)) bank_15(
.DO(bank_data[15]),.DI(32'd0),.BLKSEL(3'd0),.AD({address[9:0],4'd0}),
.WRE(1'b0),.CLK(clk),.CE(address[13:10]==15),.OCE(1'b1),.RESET(1'b0));
assign data=bank_data[bank_q][15:0];
endmodule
module panel_text_sp(input clk,input [14:0] address,output [15:0] data);
wire [31:0] bank_data[0:31];reg [4:0] bank_q=0;
always @(posedge clk)bank_q<=address[14:10];
SP #(.BIT_WIDTH(16),.READ_MODE(1'b0),.WRITE_MODE(2'b00),.INIT_RAM_01(256'h3fff0fff00000000000000000000000000000000000000000000000000000000),.INIT_RAM_02(256'hf80607000740ffe0ff700038001c000800000000000000000000000000000000),.INIT_RAM_03(256'h03ff0c000c000fff0fff000e0006000700020000000000000000000000000000),.INIT_RAM_04(256'hfffefffe1c001800ffffffff3800300030000000000000000000000000000000),.INIT_RAM_05(256'h01ff01ff0000000003ff03ff0000000000000000000000000000000000000000),.INIT_RAM_06(256'h0000e000000000000000e0000000000000000000000000000000000000000000),.INIT_RAM_07(256'hfc06047ffc060006ff06887f0804fe0200000000000000000000000000000000),.INIT_RAM_08(256'h20433fc220437fe0000f3fc120413fc700000000000000000000000000000000),.INIT_RAM_09(256'h0fff3fff7ffffc07f007e007e007c007c007c007c007e007e007f007fe0f7fff),.INIT_RAM_0A(256'h0000000000000000000000010001000300030003000300010001000100000000),.INIT_RAM_0B(256'he018c0180c38fc38fc300c700c70fc20fc000c000c00fc20fc70003c001ef80e),.INIT_RAM_0C(256'h00f00020060007ff07ff8606860607ff07ff0606060607ff87ff8006000601ff),.INIT_RAM_0D(256'hff003c00fffcfffc300030013003ffcfffdc007800f001c0ffffffff07000600),.INIT_RAM_0E(256'h0003000000ff00ff00000600078003e70077003c001c000e07ff07ff00000000),.INIT_RAM_0F(256'h000000000000000003fe00000000000000000000000000000000000000000000),.INIT_RAM_10(256'h0000000000000000000000000000000000000000000000000000f00000000000),.INIT_RAM_11(256'h000000000000000000000000000000000000000000000000000000fffc060406),.INIT_RAM_12(256'h0000000000000000000000000000000000000000000000000000fff000037fe2),.INIT_RAM_13(256'h20006000fe002000200020002000000000000000000000000000000000000000),.INIT_RAM_14(256'h0000000000030000000000000000000000000000000000000000000000000000),.INIT_RAM_15(256'h11121ff011109ff201031fe12018201c3ffe0101000000000000000000000000),.INIT_RAM_16(256'h13fb0c0c06187fff00201ffe00403fff004000c0000000000000000000000000),.INIT_RAM_17(256'h004000c000800180010003000200020006000000000000000000000000000000),.INIT_RAM_18(256'h1c241e443344214420477fc00048004c1fc47000000000000000000000000000),.INIT_RAM_19(256'h47e6442644264426442647e6400660067ffe0000000000000000000000000000),.INIT_RAM_1A(256'h00000000c0008000800000000000000000000000000000000000000000000000),.INIT_RAM_1B(256'h600d7ffd000118111ff118111ff300023ffa0102008600000000000000000000),.INIT_RAM_1C(256'h010c010c010c010c010c7f0c010c010c01000100010000000000000000000000),.INIT_RAM_1D(256'h410c410861087ff800007ffc01000100fffe0100010000000000000000000000),.INIT_RAM_1E(256'h401840187ff800000000fffe10403060fffd0200020000000000000000000000),.INIT_RAM_1F(256'h0000000000000000000000030000000000010000000000000000000000000000),.INIT_RAM_20(256'h000000000000000000000007000700070007000700070007000700070007000f),.INIT_RAM_21(256'h0000000000000000000001c003e003e003c00180000000000000000000000000),.INIT_RAM_22(256'h000000000000000000000000000000000000000000000000020c0f0e3e0c781c),.INIT_RAM_23(256'h00000000000000000000000000000000000000000000000004000e000f8003e0),.INIT_RAM_24(256'h0000000000000000000000000000000000000000000000000000001e01fec7e0),.INIT_RAM_25(256'h000000000000000000000000000000000000000000000000000000c000fc007f),.INIT_RAM_26(256'h0000000000000000000000000000000000000000000000000000000020002000),.INIT_RAM_27(256'h000000000000000000000000000000000000000000002011187104c310121ff2),.INIT_RAM_28(256'h0000000000000000000000000000000000000000000018060f3800e01ffe2041),.INIT_RAM_29(256'h0000000000000000000000000000000000000000000000100030002000600040),.INIT_RAM_2A(256'h000000000000000000000000000000000000000000007ff0001b40de63b43624),.INIT_RAM_2B(256'h0000000000000000000000000000000000000000000060067ffe400640064426),.INIT_RAM_2C(256'h0000000000000000000000000000000000000000000001c18301030103011ff1),.INIT_RAM_2D(256'h000000000000000000000000000000000000000000000000ffff010c010c010c),.INIT_RAM_2E(256'h00000000000000000000000000000000000000000000000200060004600c7ffc),.INIT_RAM_2F(256'h0000000000000000000000000000000000000000000040187ff8401840187ff8),.INIT_RAM_30(256'h3c4a244a144a057e3f4a257e254a254a257f3f12043c04040000000000000000),.INIT_RAM_31(256'h821182233fff022202221ffa022286229ffe100210029ffe0000000000000000),.INIT_RAM_32(256'h0330000183f1448987f90488e7f9008187f00806cffd00c00000000000000000),.INIT_RAM_33(256'h81e6801803ff041003ff00830fff000c03ff000807ff00100000000000000000),.INIT_RAM_34(256'hc00000000000f8000000c0002000800090001000f00000000000000000000000),.INIT_RAM_35(256'hf8e1883f880c8bff8808f808880a880989088900f9ff00040004000000000000),.INIT_RAM_36(256'h3060f0403640fc443844f0462042fe4041fffc408040fc400000000000000000),.INIT_RAM_37(256'h1820203f4020c43fc420843f840084ff8400847f0400fc7f0000000000000000),.INIT_RAM_38(256'h012102610241fe114211fe100010fe104010ff104010401f0000000000000000),.INIT_RAM_39(256'h01000100ff08010f0108ff0f0000ffdf8c00043fff8020002000000000000000),.INIT_RAM_3A(256'h0344018400070004000400070000001f00010001000f00000000000000000000),.INIT_RAM_3B(256'h000000000000000000000000000000000000000000000000000000000000c3b0),.INIT_RAM_3C(256'h0000000000000000000000000000000000000000000000000000000000008208),.INIT_RAM_3D(256'h0000000000000000000000000000000000000000000000000000000000008c0c),.INIT_RAM_3E(256'h0000000000000000000000000000000000000000000000000000000040008301),.INIT_RAM_3F(256'h0000000000000000000000000000000000000000000000000000000000003000)) bank_0(
.DO(bank_data[0]),.DI(32'd0),.BLKSEL(3'd0),.AD({address[9:0],4'd0}),
.WRE(1'b0),.CLK(clk),.CE(address[14:10]==0),.OCE(1'b1),.RESET(1'b0));
SP #(.BIT_WIDTH(16),.READ_MODE(1'b0),.WRITE_MODE(2'b00),.INIT_RAM_00(256'h0000000000000000000000000000000000000000000000000000000000008900),.INIT_RAM_01(256'h000000000000000000000000000000000000000000000000000000000000f03c),.INIT_RAM_02(256'h0000000000000000000000000000000000000000000000000000000002000c3f),.INIT_RAM_03(256'h000000000000000000000000000000000000000000000000000000000000013f),.INIT_RAM_04(256'h000000000000000000000000000000000000000000000000000000000100ff00),.INIT_RAM_05(256'h0000000000000000000000000000000000000000000000000000000001840347),.INIT_RAM_06(256'h2f80a0c0a1802f802100e1000300000000000000000000000000000000000000),.INIT_RAM_07(256'h8049fe593050fc503040fe7f0000000000000000000000000000000000000000),.INIT_RAM_08(256'h000701ff003000fc003001fc0000000000000000000000000000000000000000),.INIT_RAM_09(256'hc000c000c000ff80c000c000c000000000000000000000000000000000000000),.INIT_RAM_0A(256'hce00cc00cc00c87fd80010001000000000000000000000000000000000000000),.INIT_RAM_0B(256'h018f01fc01c80008000800080008000000000000000000000000000000000000),.INIT_RAM_0C(256'h8000000000000000c00000000000000000000000000000000000000000000000),.INIT_RAM_0D(256'h1f911091109110b311bf1f830003000300000000000000000000000000000000),.INIT_RAM_0E(256'h010007000c00180070007ffe0000000000000000000000000000000000000000),.INIT_RAM_0F(256'h200021fc6020fc2021fe20202020000000000000000000000000000000000000),.INIT_RAM_10(256'h0000000000000003000000000000000000000000000000000000000000000000),.INIT_RAM_11(256'h00800080ffa03030101800000000000000000000000000000000000000000000),.INIT_RAM_12(256'hffc41804ffe71000300000000000000000000000000000000000000000000000),.INIT_RAM_13(256'h000f0000001f0000000000000000000000000000000000000000000000000000),.INIT_RAM_14(256'h000000000000000000002000220027002e00aa00a20023002fc0220022002300),.INIT_RAM_15(256'h000000000000000000000000007c006000400050f8590049024e1c467046c04f),.INIT_RAM_16(256'h0000000000000000000000000002000c00180030003f0002018300e10018000c),.INIT_RAM_17(256'h0000000000000000000000000200fe000200020002000200fe0000000000ff00),.INIT_RAM_18(256'h0000000000000000000000000c108c1f8c10cc10cc10cc10cc1fcc00cf00ee3f),.INIT_RAM_19(256'h000000000000000000000000000001ff010003000308000800e8008801880188),.INIT_RAM_1A(256'h00000000000000000000000040008000000000000000c00000004000c0008000),.INIT_RAM_1B(256'h00000000000000000000006030601c610666016800f07fff006000608060119e),.INIT_RAM_1C(256'h000000000000000000000000000001e0018001000100010001000180ffff0100),.INIT_RAM_1D(256'h00000000000000000000000002008ffcf8c060c870889088990409fc0d05fdfc),.INIT_RAM_1E(256'h0000000000000000000000000002000300000000000000000001000100030003),.INIT_RAM_1F(256'h000000000000000001888718cc1800100130ff303120ff003100ff303018fe08),.INIT_RAM_20(256'h000000000000000000c68703fc003800ffc210233062fec303028303ffe00c01),.INIT_RAM_21(256'h00000000000000000004000700000000000f00100018000500030001001f0000),.INIT_RAM_22(256'hfe00800000000000000000000000000000000000000000000000000000000000),.INIT_RAM_23(256'hffbf300000000000000000000000000000000000000000000000000000000000),.INIT_RAM_24(256'hc007fff000000000000000000000000000000000000000000000000000000000),.INIT_RAM_25(256'h41107f1300000000000000000000000000000000000000000000000000000000),.INIT_RAM_26(256'h1188019800000000000000000000000000000000000000000000000000000000),.INIT_RAM_27(256'h0fe4000000000000000000000000000000000000000000000000000000000000),.INIT_RAM_28(256'h0004000000000000000000000000000000000000000000000000000000000000),.INIT_RAM_29(256'h2004000000000000000000000000000000000000000000000000000000000000),.INIT_RAM_2A(256'h0102000000000000000000000000000000000000000000000000000000000000),.INIT_RAM_2B(256'h84c6068200000000000000000000000000000000000000000000000000000000),.INIT_RAM_2C(256'hffc1180100000000000000000000000000000000000000000000000000000000),.INIT_RAM_2D(256'hff23082000000000000000000000000000000000000000000000000000000000),.INIT_RAM_2E(256'h0000f80000000000000000000000000000000000000000000000000000000000),.INIT_RAM_2F(256'h8281f63f8201fa00820000000000000000000000000000000000000000000000),.INIT_RAM_30(256'h7fd04067ffc00087000000000000000000000000000000000000000000000000),.INIT_RAM_31(256'h00083fe802080110000000000000000000000000000000000000000000000000),.INIT_RAM_32(256'h0000000000000000000000000000020004000400fc008400fc000000fc008000),.INIT_RAM_33(256'h0000000000000000000000000100ff000100ff08010fff08000fffc0841f8400),.INIT_RAM_34(256'h00000000000000000000000078024003c042cfc3c842c843c840c84fcfc0c000),.INIT_RAM_35(256'h000000000000000000000000700088d08b100e104d104d584d3049104920497c),.INIT_RAM_36(256'h0000000000000000000000001f0431843184219401a401c4018707860d841988),.INIT_RAM_37(256'h0000000000000000100050009000b000a0008000a00090008800200030001000),.INIT_RAM_38(256'h0000000000000000a14122362218241424242422ff7f2448247f24082408fe08),.INIT_RAM_39(256'h0000000000000000000000030006000800110002000c00080001000200040008),.INIT_RAM_3A(256'h0000000000000000000000000000800000000000000000008000000000000000),.INIT_RAM_3B(256'h000000000000000000006831c642c18c411d45354524c520743f07e50085611d),.INIT_RAM_3C(256'h0000000000000000007e00420042007e0042007e000001ff002400a7002400ff),.INIT_RAM_3D(256'h0000000000000000000000000000f0000000000080002000c0000000e0000000),.INIT_RAM_3E(256'h00000000000000000007240444045dff240c8418143f1484bc24001720fffe04),.INIT_RAM_3F(256'h0000000000000000000020c02980e700260025bf24892888291f2fc2e102013f)) bank_1(
.DO(bank_data[1]),.DI(32'd0),.BLKSEL(3'd0),.AD({address[9:0],4'd0}),
.WRE(1'b0),.CLK(clk),.CE(address[14:10]==1),.OCE(1'b1),.RESET(1'b0));
SP #(.BIT_WIDTH(16),.READ_MODE(1'b0),.WRITE_MODE(2'b00),.INIT_RAM_00(256'h0000000000000000000000020002000300020002000200020002000200030000),.INIT_RAM_01(256'h0000000000000000000000000000218320c62044306c303870305838c8688c4c),.INIT_RAM_02(256'h00000000000000000000000006001a408280630022001400ffe01800ffc01800),.INIT_RAM_03(256'h00000000000000000000000071208123ff208120ff218120ffaf08a8ff630860),.INIT_RAM_04(256'h0000000000000000000000000000000000000000000000000001000000000000),.INIT_RAM_05(256'h00000000000000000000000000000000c0004800700040008000fc000000f800),.INIT_RAM_06(256'h000000000000000000000000000092001220f21b1204f21a1220f27f0281fabf),.INIT_RAM_07(256'h00000000000000000000000000000003c0643b071e2421477f8401077fc0404f),.INIT_RAM_08(256'h000000000000000000000000000000003fe904080488048808880848084e104c),.INIT_RAM_09(256'h0000fffc61804080c080fff80c00040000000000000000000000000000000000),.INIT_RAM_0A(256'h30c030efffe04040c0808187ff00020006000000000000000000000000000000),.INIT_RAM_0B(256'h000c000c000f0000000000010001000000000000000000000000000000000000),.INIT_RAM_0C(256'h00000000000000000000000000000020ffe000200020ffe000200020ffe00000),.INIT_RAM_0D(256'h00000000000000000000000000000001ff8100c100c100c100c1ffc130c130c0),.INIT_RAM_0E(256'h00000000000000000000000000000000001f001000100000000c000f000c000c),.INIT_RAM_0F(256'hc1c0c0c0c1e0613024082e183b3031203000e7fc200020c06040000000000000),.INIT_RAM_10(256'h7c00ffe1300130c1ffc330c230c2ffc230c230cfffc000000000000000000000),.INIT_RAM_11(256'h0000001f0000000c000f000c000c000f000c000c000f00000000000000000000),.INIT_RAM_12(256'h000000000000000000000000000000000000000000000000080818183230e360),.INIT_RAM_13(256'h000000000000000000000000000000000000000000003000302430c63303b601),.INIT_RAM_14(256'h0000000000000000000000000000000000000000000000000018000e00030000),.INIT_RAM_15(256'h0000fe00fe00fc0001008400fe00000000000000000000000000000000000000),.INIT_RAM_16(256'h040907f907f800000ffe012007f9000000000000000000000000000000000000),.INIT_RAM_17(256'h04006600a400a400e4000400f600400000000000000000000000000000000000),.INIT_RAM_18(256'h01c1034903e903c907f9020987f9008000000000000000000000000000000000),.INIT_RAM_19(256'h0062001000140068000a00140004002300000000000000000000000000000000),.INIT_RAM_1A(256'h9e009e009f008d00cd009f00de00040000000000000000000000000000000000),.INIT_RAM_1B(256'h07fa07fa00020ffe012307f80003000000000000000000000000000000000000),.INIT_RAM_1C(256'hf0220814f0180018f0145826f862800000000000000000000000000000000000),.INIT_RAM_1D(256'h3f8f00003f870004ffe711017fcf040000000000000000000000000000000000),.INIT_RAM_1E(256'h401040106020a020b04010401880000000000000000000000000000000000000),.INIT_RAM_1F(256'h5ac06200620062007a0042017ec1080000000000000000000000000000000000),.INIT_RAM_20(256'h01fa000201f2011203fe011207fe000000000000000000000000000000000000),.INIT_RAM_21(256'h0000e000e0000000c0000000f000000000000000000000000000000000000000),.INIT_RAM_22(256'hfe140015fe570056ffd6447eff13107c00000000000000000000000000000000),.INIT_RAM_23(256'h0000000000000000000300000001000000000000000000000000000000000000),.INIT_RAM_24(256'hc180000000000000000000000000000000000000000000000000000000000000),.INIT_RAM_25(256'h000000000000000000000000000000000000000000000000000000000000e000),.INIT_RAM_26(256'h00000000000000000000000000000000000000000000000000000000000007f8),.INIT_RAM_27(256'h0000000000000000000000000000000000000000000000000000000000008000),.INIT_RAM_28(256'h0000000000000000000000000000000000000000000000000000000000000635),.INIT_RAM_29(256'h000000000000000000000000000000000000000000000000000000001e009e00),.INIT_RAM_2A(256'h0000000000000000000000000000000000000000000000000000000007f80409),.INIT_RAM_2B(256'h0000000000000000000000000000000000000000000000000000000080000063),.INIT_RAM_2C(256'h000000000000000000000000000000000000000000000000000000001f070004),.INIT_RAM_2D(256'h0000000000000000000000000000000000000000000000000000000000084008),.INIT_RAM_2E(256'h0000000000000000000000000000000000000000000000000000000062004200),.INIT_RAM_2F(256'h00000000000000000000000000000000000000000000000000000000039d00e2),.INIT_RAM_30(256'h00000000000000000000000000000000000000000000000000000000f000e000),.INIT_RAM_31(256'h000000000000000000000000000000000000000000000000000000007c450029),.INIT_RAM_32(256'h04000c183df8a5c8c448c44864482dc8fc48044004580df8fd1805180d18fdf8),.INIT_RAM_33(256'he800080418f713e1300020e30364f842188311f23322fe62224360c2fc824083),.INIT_RAM_34(256'h0001003100310019000900090003001f000100010001000100000000001f0000),.INIT_RAM_35(256'hc11c4fc8401ed02a4ccae302421f840487c40000000000000000000000000000),.INIT_RAM_36(256'h5147d05541f5c1571155895741f2f04308400000000000000000000000000000),.INIT_RAM_37(256'h2022f93f0622ffbf1002ff1f1020ff3f20020000000000000000000000000000),.INIT_RAM_38(256'h000082040201000f000080070000000700000000000000000000000000000000),.INIT_RAM_39(256'h013202220ffb00460042045f07f20082f0820000000000000000000000000000),.INIT_RAM_3A(256'h2406e4860466fc36000ef8060806fe0681ff0000000000000000000000000000),.INIT_RAM_3B(256'h7c120093ff90001f0100ff0f0108ffbf10000000000000000000000000000000),.INIT_RAM_3C(256'h0000010201030000c00000000000800300000000000000000000000000000000),.INIT_RAM_3D(256'h91ff110111ff100017ff9044908213fff0100010000000000000000000000000),.INIT_RAM_3E(256'h54308419840e8406840b9f118410e400047f0000000000000000000000000000),.INIT_RAM_3F(256'hfe88248824e825c8fe884488c5e8f88f00800000000000000000000000000000)) bank_2(
.DO(bank_data[2]),.DI(32'd0),.BLKSEL(3'd0),.AD({address[9:0],4'd0}),
.WRE(1'b0),.CLK(clk),.CE(address[14:10]==2),.OCE(1'b1),.RESET(1'b0));
SP #(.BIT_WIDTH(16),.READ_MODE(1'b0),.WRITE_MODE(2'b00),.INIT_RAM_00(256'h0003000100010001000100000000000000000000000000000000000000000000),.INIT_RAM_01(256'h00000000000000000000000000000000000000000000000000003fe84108410f),.INIT_RAM_02(256'h00000000000000000000000000000000000000000000000000004a1a09c5c945),.INIT_RAM_03(256'h00000000000000000000000000000000000000000000000000000620f009fe3f),.INIT_RAM_04(256'h0000000000000000000000000000000000000000000000000000800300000003),.INIT_RAM_05(256'h0000000000000000000000000000000000000000000000000000041b03e201c2),.INIT_RAM_06(256'h000000000000000000000000000000000000000000000000000004062406e406),.INIT_RAM_07(256'h0000000000000000000000000000000000000000000000000000819c42104613),.INIT_RAM_08(256'h0000000000000000000000000000000000000000000000000000000300040004),.INIT_RAM_09(256'h0000000000000000000000000000000000000000000000000000f10111ff5101),.INIT_RAM_0A(256'h0000000000000000000000000000000000000000000000000000107f24004c20),.INIT_RAM_0B(256'h00000000000000000000000000000000000000000000000000000267c88c3088),.INIT_RAM_0C(256'h0000000000000000000000000000000000000000000000000000000100000000),.INIT_RAM_0D(256'hffe000000000fff0000000000000000000000000000000000000000000000000),.INIT_RAM_0E(256'h02010201ffe13001100000000000000000000000000000000000000000000000),.INIT_RAM_0F(256'h00010003001f0000000000000000000000000000000000000000000000000000),.INIT_RAM_10(256'h000000000000000007800d880c78cfc06f00fc009c600c300c00fffc00000000),.INIT_RAM_11(256'h00000000000000000080ff8400870080ff8000800083ff820000000ffff18601),.INIT_RAM_12(256'h00000000000000000004000700040004000700040004000700000000003f0001),.INIT_RAM_13(256'h00f8fc48034806c80cd898d8d0c060f860000000000000000000000000000000),.INIT_RAM_14(256'h22602a633a641a663263f2613260220062006200000000000000000000000000),.INIT_RAM_15(256'h0006000400040004000c001f0000000000000000000000000000000000000000),.INIT_RAM_16(256'h00000000000000000000000000000000fef08080808048806c9c2cf824802480),.INIT_RAM_17(256'h0000000000000000000000000000000000070a003a01e201c261c3e343e26262),.INIT_RAM_18(256'h0000000000000000000000000000000000000010001c00070001000100030002),.INIT_RAM_19(256'h908010809080f780000000000000000000000000000000000000000000000000),.INIT_RAM_1A(256'h140414051c0d0878000000000000000000000000000000000000000000000000),.INIT_RAM_1B(256'h060008000800c700000000000000000000000000000000000000000000000000),.INIT_RAM_1C(256'h0002000200020001000000000000000000000000000000000000000000000000),.INIT_RAM_1D(256'h0000000000000000000000000000000000000000000000001080108010807780),.INIT_RAM_1E(256'h0000000000000000000000000000000000000000000000004178228c3e8422e4),.INIT_RAM_1F(256'h000000000000000000000000000000000000000000000000c7004800c8000808),.INIT_RAM_20(256'h0000000000000000000000000000000000000000000000000003000000000001),.INIT_RAM_21(256'h070003000300fffcfffcc000c000e000c0000000000000000000000000000000),.INIT_RAM_22(256'h0038007000300fff0fff00010001000000000000000000000000000000000000),.INIT_RAM_23(256'h800c80180038fff0ffe000c001c0018000000000000000000000000000000000),.INIT_RAM_24(256'h000300030007000f000f00000000000000000000000000000000000000000000),.INIT_RAM_25(256'h003000300030fff0fff0003000300070fff0fff0000000000000fffefffe0600),.INIT_RAM_26(256'h03800380038003ff03ff03800380038003ff03ff0000000080009fff9fff001c),.INIT_RAM_27(256'h000c000c000c000c000cfffcfffc300c300c300c300c300c300dffffffffc006),.INIT_RAM_28(256'h060006000200000000c000ff00ff00c000c000c000c000c000c000ff00ff0001),.INIT_RAM_29(256'h0000000000000000000000000000000000000000000000300070fff0fff00030),.INIT_RAM_2A(256'h000000000000000000000000000000000000000000000380038003ff03ff0380),.INIT_RAM_2B(256'h000000000000000000000000000000000000000000000000fff8fffc001c000c),.INIT_RAM_2C(256'h00000000000000000000000000000000000000000000000001ff03ff07000700),.INIT_RAM_2D(256'h008000801ffc00841c8c2188bf7e235222523e1022fe3e240044000000000000),.INIT_RAM_2E(256'hc0058fe2882288228fe20002fffb010001149ff6012201210000000000000000),.INIT_RAM_2F(256'h80068fc78845885c884480440c5fefc20c060c1fcc020fc20000000000000000),.INIT_RAM_30(256'h4200220003ff0200020003ff00000fff00c6008207ff00100010000000000000),.INIT_RAM_31(256'h10001000d0002000e0002000e00020002000e0002000e0000000000000000000),.INIT_RAM_32(256'h110c1204f03f100c103ff00c001ffce0c18041fff98001ff0000000000000000),.INIT_RAM_33(256'h00400040fe7f00400040007ff00011ff1018f01010ff10020002000000000000),.INIT_RAM_34(256'h5220d220922f9420942014609c7f44004400bfff880004000000000000000000),.INIT_RAM_35(256'h0207fa040204f23c03840324f23f0400fd00037fe60104010000000000000000),.INIT_RAM_36(256'h0f8108bf0881089f88814f81088f388968bfcf89c20f82010000000000000000),.INIT_RAM_37(256'h224c24c82488248924890008fc880cc81848110ffe8020400000000000000000),.INIT_RAM_38(256'h1c2915e9326122412041208427f72003f801200027e720000000000000000000),.INIT_RAM_39(256'h00d2006200020002000200020002000200030000000000000000000000000000),.INIT_RAM_3A(256'h0000000000000000000000000000000000000000000000000000000000007fff),.INIT_RAM_3B(256'h0000000000000000000000000000000000000000000000000000000000003ff8),.INIT_RAM_3C(256'h0000000000000000000000000000000000000000000000000000000080009ffc),.INIT_RAM_3D(256'h000000000000000000000000000000000000000000000000000000008200c3ff),.INIT_RAM_3E(256'h0000000000000000000000000000000000000000000000000000000000000800),.INIT_RAM_3F(256'h000000000000000000000000000000000000000000000000000000001000f1f8)) bank_3(
.DO(bank_data[3]),.DI(32'd0),.BLKSEL(3'd0),.AD({address[9:0],4'd0}),
.WRE(1'b0),.CLK(clk),.CE(address[14:10]==3),.OCE(1'b1),.RESET(1'b0));
SP #(.BIT_WIDTH(16),.READ_MODE(1'b0),.WRITE_MODE(2'b00),.INIT_RAM_00(256'h000000000000000000000000000000000000000000000000000000000040007f),.INIT_RAM_01(256'h0000000000000000000000000000000000000000000000000000000000005d1f),.INIT_RAM_02(256'h000000000000000000000000000000000000000000000000000000000000027e),.INIT_RAM_03(256'h0000000000000000000000000000000000000000000000000000000000008881),.INIT_RAM_04(256'h0000000000000000000000000000000000000000000000000000000000002147),.INIT_RAM_05(256'h000000000000000000000000000000000000000000000000000000000400c807),.INIT_RAM_06(256'h00000000000000000000000000000000000000000000000000000000006000d1),.INIT_RAM_07(256'h1800000000000000000000000000000000000000000000000000000000000000),.INIT_RAM_08(256'h0400000000000000000000000000000000000000000000000000000000000000),.INIT_RAM_09(256'h6000400000000000000000000000000000000000000000000000000000000000),.INIT_RAM_0A(256'h0060006000000000000000000000000000000000000000000000000000000000),.INIT_RAM_0B(256'h000c000400000000000000000000000000000000000000000000000000000000),.INIT_RAM_0C(256'h0300010000000000000000000000000000000000000000000000000000000000),.INIT_RAM_0D(256'h0600000000000000000000000000000000000000000000000000000000000000),.INIT_RAM_0E(256'h1000000000000000000000000000000000000000000000000000000000000000),.INIT_RAM_0F(256'h0c00000000000000000000000000000000000000000000000000000000000000),.INIT_RAM_10(256'h98009800980098001b001e007800780018001800180018007f00180018001800),.INIT_RAM_11(256'h8309830983898f899cc980c980df9fff800180018ff980018001000100031fff),.INIT_RAM_12(256'h31bdffb531a531a531a5ffa500250325ff2503250325032dff3f00040004ff84),.INIT_RAM_13(256'h01060107010401040306ff0781008123813383e2ffc200830183ff00fe000607),.INIT_RAM_14(256'hf980830f013f00307820f861306120616061c861f86198601860307f207f6000),.INIT_RAM_15(256'h3019301b30183ff83ff80001400c783c3cf007c007840ecd1c6b183b38303fe0),.INIT_RAM_16(256'h0000f0381fc00f0810503fe000403ff020103ff420187ff00020000000000000),.INIT_RAM_17(256'h00003ff40604048404c40c4408440867082600043ff402080108000000000000),.INIT_RAM_18(256'h18001800f80018001800f800f8000000fe00ff00c000c0004000fc00fc000000),.INIT_RAM_19(256'h0600060007ff0600060007ff07ff00001fff1fff00c000c000800fff0fffc00c),.INIT_RAM_1A(256'h3ff1303130313ff100010003ffff0000c00cfffcc00cc00cfffc00000000ffff),.INIT_RAM_1B(256'h00020002ffe2fff2000200020003ff00ff00030003000300ff00ff000200020f),.INIT_RAM_1C(256'h7040604060cf60cf60c060c060c060ff78ff78000000000041ff63ff60003000),.INIT_RAM_1D(256'h010001007ffe7fff0100010001003ffc7ffe010c010c011800183ffe7ffe0030),.INIT_RAM_1E(256'h0e00fff80c020c06ffdc8070c060e0e0fffe01000300fffc06000600fffc0c00),.INIT_RAM_1F(256'h000000070010001c0006000100000000001f00000000000f00000000001f0000),.INIT_RAM_20(256'h1e00e20000000000000000000000000000000000000000004f006f00d800d800),.INIT_RAM_21(256'h108479e700000000000000000000000000000000000000000008183c1c7886c8),.INIT_RAM_22(256'h0100000000000000000000000000000000000000000001840184ff8431843185),.INIT_RAM_23(256'h2808100800000000000000000000000000000000000000040006fc07ff040304),.INIT_RAM_24(256'h4001ffe100000000000000000000000000000000000000000000007f01ff1980),.INIT_RAM_25(256'h09280fe50000000000000000000000000000000000000000000030183ff83ff8),.INIT_RAM_26(256'h3e00000000000000000000000000000000000000000000000000000000000000),.INIT_RAM_27(256'hfc82008200000000000000000000000000000000000000000000000000000000),.INIT_RAM_28(256'h9ff8810800000000000000000000000000000000000000000000000000000000),.INIT_RAM_29(256'h0488fcff00000000000000000000000000000000000000000000000000000000),.INIT_RAM_2A(256'hffc8080f00000000000000000000000000000000000000000000000000000000),.INIT_RAM_2B(256'h4ffc000000000000000000000000000000000000000000000000000000000000),.INIT_RAM_2C(256'h002000a000000000000000000000000000000000000000000000000000000000),.INIT_RAM_2D(256'h0000000000000000000000000000000000000000000000001800f800f8001800),.INIT_RAM_2E(256'h000000000000000000000000000000000000000000000000060007ff07ff0600),.INIT_RAM_2F(256'h000000000000000000000000000000000000000000000000e001e00100310031),.INIT_RAM_30(256'h0000000000000000000000000000000000000000000000000001c003c0020002),.INIT_RAM_31(256'h0000000000000000000000000000000000000000000000000000081f9c7ff860),.INIT_RAM_32(256'h00000000000000000000000000000000000000000000000000007ffe7fff0100),.INIT_RAM_33(256'h000000000000000000000000000000000000000000000000001c80f8f3801f00),.INIT_RAM_34(256'h0000000000000000000000000000000000000000000000000006000700000000),.INIT_RAM_35(256'h0000000000000000000000000000000004006c0044009f00840084004f006000),.INIT_RAM_36(256'h000000000000000000000000000000070c041fc64426128500057fe5108679e6),.INIT_RAM_37(256'h0000000000000000000000000010801080208020804080400040c0800080e100),.INIT_RAM_38(256'h0000000000000000000000000000c840287f28402840287f2a003effec0829ff),.INIT_RAM_39(256'h0000000000000000000000000000380f401840114f81480f480948094f89400f),.INIT_RAM_3A(256'h00000000000000000000000000008e0088108b9c08bc0ba408248fe409260fa0),.INIT_RAM_3B(256'h0000000000000000000000000000c6003c0024003c002000bc0080013c008000),.INIT_RAM_3C(256'h0000000000000000000000000000fe1884458582fc4785c58488fcef8542844f),.INIT_RAM_3D(256'h00000000000000000000000000001c3143c040c04100c9000fe009248fe48108),.INIT_RAM_3E(256'h000000000000000000000000000000e8fc880488f48814fff4880488f4ff0488),.INIT_RAM_3F(256'h0000000000000000000000000000fe200b4f0888f88b088a080bffe8000b8048)) bank_4(
.DO(bank_data[4]),.DI(32'd0),.BLKSEL(3'd0),.AD({address[9:0],4'd0}),
.WRE(1'b0),.CLK(clk),.CE(address[14:10]==4),.OCE(1'b1),.RESET(1'b0));
SP #(.BIT_WIDTH(16),.READ_MODE(1'b0),.WRITE_MODE(2'b00),.INIT_RAM_00(256'h00000000000000000000000000008c31a3d4449047f844081ffe040887f84000),.INIT_RAM_01(256'h000000000000000000000000000000900170016d005500fd00a100bd002101ff),.INIT_RAM_02(256'hc400cc00c400c00020002c00e600c200c000c800cc0006000000000000000000),.INIT_RAM_03(256'h2040207fe040007f0100fd0081ff8048804ff840007f00000000000000000000),.INIT_RAM_04(256'h0100010001ff000000000fff0061004000c007ff000c00040000000000000000),.INIT_RAM_05(256'hfc004000400040004000f8000000000000000000000000000000000000000000),.INIT_RAM_06(256'hc0ffc008fe0810081808087f0000000000000000000000000000000000000000),.INIT_RAM_07(256'h00000000001f0003000200040000000000000000000000000000000000000000),.INIT_RAM_08(256'h000000000000000000000000000000000000000000000000c200c600c600c400),.INIT_RAM_09(256'h000000000000000000000000000000000000000000002000e07820402040e07f),.INIT_RAM_0A(256'h00000000000000000000000000000000000000000000010001ff0100010001ff),.INIT_RAM_0B(256'h0000000000000000000000000000000000000000080010002000600040004000),.INIT_RAM_0C(256'h000000000000000000000000000000000000000002080c0830082008c008fe08),.INIT_RAM_0D(256'h00000000000000000000000000000000000000000010000c000300010000003f),.INIT_RAM_0E(256'h18007e0010001000000000000000000000000000000000000000000000000000),.INIT_RAM_0F(256'h20601060fe7f8000000000000000000000000000000000000000000000000000),.INIT_RAM_10(256'h000c0008007f0001000000000000000000000000000000000000000000000000),.INIT_RAM_11(256'h000e000e000c0000000000000000000000000000000000000000000000000000),.INIT_RAM_12(256'h000000000000000000000000f3001a001e001600f600160014001000ff001000),.INIT_RAM_13(256'h0000000000000000000000000cfffc000400047efc4304430c43fc03007fff60),.INIT_RAM_14(256'h0000000000000000000000000030603f4030c030803f80308030003f000000ff),.INIT_RAM_15(256'h000000000000000000000000000000c000c000600060c03fc03100310013001b),.INIT_RAM_16(256'h00000000000000000000000000002180218021802180218021806180f3809d80),.INIT_RAM_17(256'h000000000000000000000000000003cc044c0c0c060c038c00cc00cc04c60787),.INIT_RAM_18(256'h0000000000000000000000000000000000000000000000000ff8000000000000),.INIT_RAM_19(256'h0000000000000000000000008000800080008000f80080008000800080000000),.INIT_RAM_1A(256'h0000000000000000000000000000000000000001000f00000000000000000000),.INIT_RAM_1B(256'h220022002200be00a2002200e20022003e000000000000000000000000000000),.INIT_RAM_1C(256'hf91009110911f91109100910f97f01100410e210000000000000000000000000),.INIT_RAM_1D(256'h001300120813181300120013001300100010001f000000000000000000000000),.INIT_RAM_1E(256'h6318631863186318673839d80000000000000000000000000000000000000000),.INIT_RAM_1F(256'h00200038000e00020026003c0000000000000000000000000000000000000000),.INIT_RAM_20(256'h000000000ff80000000000000000000000000000000000000000000000000000),.INIT_RAM_21(256'hf800800080008000800000000000000000000000000000000000000000000000),.INIT_RAM_22(256'h000f000000000000000000000000000000000000000000000000000000000000),.INIT_RAM_23(256'h000000000000000000000000000000000000000000000000000022003e002200),.INIT_RAM_24(256'h0000000000000000000000000000000000000000000000000000010f01180910),.INIT_RAM_25(256'h0000000000000000000000000000000000000000000000000000001e00100010),.INIT_RAM_26(256'h0000000000000000000000000000000000000000000000000000000063186318),.INIT_RAM_27(256'h00000000000000000000000000000000000000000000000000000000001e0032),.INIT_RAM_28(256'h0000000000000000000000000000000000000000000000008000800080008000),.INIT_RAM_29(256'h0000000000000000000000000000000000000000000000000000000000000001),.INIT_RAM_2A(256'hfe0002007a004a00fe000000ff00100000000000000000000000000000000000),.INIT_RAM_2B(256'h012dfd2d810d81fd8021f82003ff000000000000000000000000000000000000),.INIT_RAM_2C(256'h00000fff0061004000c007ff000c000400000000000000000000000000000000),.INIT_RAM_2D(256'h4000f80000000000000000000000000000000000000000000000000000000000),.INIT_RAM_2E(256'h1808087f00000000000000000000000000000000000000000000000000000000),.INIT_RAM_2F(256'h0002000400000000000000000000000000000000000000000000000000000000),.INIT_RAM_30(256'h1c003000c000f8000800ff000800f8000000fe00000080000000000000000000),.INIT_RAM_31(256'h920e921bb621b41fa41024ff2010e01f2400e67f020100000000000000000000),.INIT_RAM_32(256'h809b801a803a802a806b80488048800b800880ff804800280000000000000000),.INIT_RAM_33(256'h0038006000c0808080800080008000c000600038001f00000000000000000000),.INIT_RAM_34(256'h43004300430043014301c300e7003b0000000000000000000000000000000000),.INIT_RAM_35(256'h089818180c18071801980198098d0f0f00000000000000000000000000000000),.INIT_RAM_36(256'h00000000000000000ff800000000000000000000000000000000000000000000),.INIT_RAM_37(256'h80008000f8008000800080008000000000000000000000000000000000000000),.INIT_RAM_38(256'h00000001000f0000000000000000000000000000000000000000000000000000),.INIT_RAM_39(256'h00000000000000000000000000001f00e0000000fe000200fe000200fe000000),.INIT_RAM_3A(256'h00000000000000000000000000002304e18d20d02071e12d212d212de12d012c),.INIT_RAM_3B(256'h0000000000000000000000000000010001ff0100010001ff0100010001ff0000),.INIT_RAM_3C(256'h000000000000000000000000080010002000600040004000fc00400040004000),.INIT_RAM_3D(256'h00000000000000000000000002080c0830082008c008fe08c0ffc008fe081008),.INIT_RAM_3E(256'h0000000000000000000000000010000c000300010000003f00000000001f0003),.INIT_RAM_3F(256'h00000000000000000000000000000000000000000000000000003000f0009200)) bank_5(
.DO(bank_data[5]),.DI(32'd0),.BLKSEL(3'd0),.AD({address[9:0],4'd0}),
.WRE(1'b0),.CLK(clk),.CE(address[14:10]==5),.OCE(1'b1),.RESET(1'b0));
SP #(.BIT_WIDTH(16),.READ_MODE(1'b0),.WRITE_MODE(2'b00),.INIT_RAM_00(256'h0000000000000000000000000000000000000000000000000000080008609a19),.INIT_RAM_01(256'h00000000000000000000000000000000000000000000000000000062006680dc),.INIT_RAM_02(256'h000000000000000000000000000000000000000000000000000000000000001f),.INIT_RAM_03(256'h0000000000000000000000000000000000000000000000000000000000004300),.INIT_RAM_04(256'h0000000000000000000000000000000000000000000000000000000000000798),.INIT_RAM_05(256'h0000000000000000000000000000000000000000000000000000000080008000),.INIT_RAM_06(256'he400020000000000000000000000000000000000000000000000000000000000),.INIT_RAM_07(256'hff7f400200000000000000000000000000000000000000000000000000000000),.INIT_RAM_08(256'h001f000000000000000000000000000000000000000000000000000000000000),.INIT_RAM_09(256'h0818000000000000000000000000000000000000000000000000000000000000),.INIT_RAM_0A(256'h00000000000000000000f0000e003400640084002400e40024002700e0000c00),.INIT_RAM_0B(256'h00000000000000000000407f4000ffa24012410eff233c3f6022fa22133f6002),.INIT_RAM_0C(256'h0000000000000000000000000000003f00000012081b18050000000400190000),.INIT_RAM_0D(256'h000000000000000000000000c8188818081808180c180ff80818881808180818),.INIT_RAM_0E(256'h000000000000000000000000001f0001000100020006000c0008001f00000000),.INIT_RAM_0F(256'h00000000000000000000000000000000000000000ff800000000000000000000),.INIT_RAM_10(256'h00000000000000008000800080008000f8008000800080008000000000000000),.INIT_RAM_11(256'h00000000000000000000000000000001000f0000000000000000000000000000),.INIT_RAM_12(256'h44004800c8000800000000000000000000000000000000000000000000000000),.INIT_RAM_13(256'h3f20cc200c3f0c00000000000000000000000000000000000000000000000000),.INIT_RAM_14(256'hc004807f00040004000000000000000000000000000000000000000000000000),.INIT_RAM_15(256'h00000019001f0000000000000000000000000000000000000000000000000000),.INIT_RAM_16(256'h2220622041c00000000000000000000000000000000000000000000000000000),.INIT_RAM_17(256'h00000000000000000000000004003400640084000400f40004004700c6004400),.INIT_RAM_18(256'h0000000000000000000007000c060c468c660c16ef0f1eff1c060c26ec3f0c20),.INIT_RAM_19(256'h00000000000000000000001e0010c011c010001000ff001000108000c0ffc004),.INIT_RAM_1A(256'h0000000000000000000000000000000f001c001000103018300e000300000000),.INIT_RAM_1B(256'h0000000000000000000000000000e0803100110012003600e40009c01a201220),.INIT_RAM_1C(256'h0000000000000000000000000000000000010003000300010000000000000000),.INIT_RAM_1D(256'he200000000000000000000000000000000000000000000000000000000000000),.INIT_RAM_1E(256'h803f000000000000000000000000000000000000000000000000000000000000),.INIT_RAM_1F(256'h0200020000000000000000000000000000000000000000000000000000000000),.INIT_RAM_20(256'h0640000000000000000000000000000000000000000000000000000000000000),.INIT_RAM_21(256'h0000000000000000120032006600840084000400f00004002600c20088002c00),.INIT_RAM_22(256'h00000000000000000ca27132c112330afa060207f23f1202fe221218020cfe20),.INIT_RAM_23(256'h00000000000000000018000700010004000f080018070004001f00040000003f),.INIT_RAM_24(256'h00000000000040107ff0401040107ff0401040107ff00000fffc18c01040fff8),.INIT_RAM_25(256'h00000000000000040f98083018201060104010401ff84006600d18180c300460),.INIT_RAM_26(256'h8000000000000000000000000000000000000000000000000000000000000000),.INIT_RAM_27(256'hf200000000000000000000000000000000000000000000000000000000000000),.INIT_RAM_28(256'hcb002a00bc001c000800ff0008002a002a0008009f0030000000000000000000),.INIT_RAM_29(256'h04ff040cfc7f040c0c0cfc61003eff1c20321061fe7f80000000000000000000),.INIT_RAM_2A(256'h80308030803f80308030803f800080ff800c8008807f00010000000000000000),.INIT_RAM_2B(256'h002000300018600c600f00180030003000300018000f00000000000000000000),.INIT_RAM_2C(256'h10c010c010c010c010c030c079c0cec000000000000000000000000000000000),.INIT_RAM_2D(256'h02260606030601c600660066026303c300000000000000000000000000000000),.INIT_RAM_2E(256'h00000000000000000e007000c00060001000fc000200260028002000fe008000),.INIT_RAM_2F(256'h0000000000000000043c4807ca015e025a04d20f1220f232138ad002147f1600),.INIT_RAM_30(256'h0000000000000000001e001000170014001408171810001f0011001700110010),.INIT_RAM_31(256'h0000000000000000000000000000000000000000000000000000080008000800),.INIT_RAM_32(256'h0000000000000000000000000000000000000000000000000000000c0c0cfc0c),.INIT_RAM_33(256'h000000000000000000000000000000000000000000000000000000000030803f),.INIT_RAM_34(256'h0000000000000000000000000000000000000000000000000000000000000060),.INIT_RAM_35(256'h00000000000000000000000000000000000000000000000000000000000010c0),.INIT_RAM_36(256'h00000000000000000000000000000000000000000000000000000000000001e6),.INIT_RAM_37(256'h0400fc0000000000000000000000000000000000000000000000000000000000),.INIT_RAM_38(256'h0610e61f00000000000000000000000000000000000000000000000000000000),.INIT_RAM_39(256'h0000001f00000000000000000000000000000000000000000000000000000000),.INIT_RAM_3A(256'h00e0000000000000000000000000000000000000000000000000000000000000),.INIT_RAM_3B(256'hc010001000000000000000000000000000000000000000000000000000000000),.INIT_RAM_3C(256'h004f004000000000000000000000000000000000000000000000000000000000),.INIT_RAM_3D(256'h0000800000000000000000000000000000000000000000000000000000000000),.INIT_RAM_3E(256'hec580fff0060c38807ff00000000000000000000000000000000000000000000),.INIT_RAM_3F(256'h842f8421842187e3800600000000000000000000000000000000000000000000)) bank_6(
.DO(bank_data[6]),.DI(32'd0),.BLKSEL(3'd0),.AD({address[9:0],4'd0}),
.WRE(1'b0),.CLK(clk),.CE(address[14:10]==6),.OCE(1'b1),.RESET(1'b0));
SP #(.BIT_WIDTH(16),.READ_MODE(1'b0),.WRITE_MODE(2'b00),.INIT_RAM_00(256'hf80080068018f060008000000000000000000000000000000000000000000000),.INIT_RAM_01(256'h03ff0031002001ff000400040000000000000000000000000000000000000000),.INIT_RAM_02(256'h8080f8008200f900808000000000000000000000000000000000000000000000),.INIT_RAM_03(256'hffc00a4f1a40f25f23c000000000000000000000000000000000000000000000),.INIT_RAM_04(256'h049ffca103e30023fc4000000000000000000000000000000000000000000000),.INIT_RAM_05(256'hfffa31832080fff0040704000000000000000000000000000000000000000000),.INIT_RAM_06(256'h0003000000000001000000000000000000000000000000000000000000000000),.INIT_RAM_07(256'h8000400000008000800000000000000000000000000000000000000000000000),.INIT_RAM_08(256'h4094c08400ff0789c80800000000000000000000000000000000000000000000),.INIT_RAM_09(256'hf04223fbe20a420a43fb00000000000000000000000000000000000000000000),.INIT_RAM_0A(256'h23fd202027ffe12000a000000000000000000000000000000000000000000000),.INIT_RAM_0B(256'h001100ff000003ff000c00000000000000000000000000000000000000000000),.INIT_RAM_0C(256'h000000000000000000000400fc00040004000400fc0004000400fc0004000400),.INIT_RAM_0D(256'h00000000000000000000c610161f161026102610479f17100f10e61f06101f90),.INIT_RAM_0E(256'h000000000000000000000001002300330013001b080b180b0003003f00000000),.INIT_RAM_0F(256'h00000000000000000000000000e0019003180208020802080208020803180190),.INIT_RAM_10(256'h00000000000000000000000000000000000000fe0000000000fe000000000000),.INIT_RAM_11(256'h00000000000000000000040147ffc401c40187ff84010401e7ff0401040107ff),.INIT_RAM_12(256'h0000000000000000000803900438042b0464044404400441044f044007f00040),.INIT_RAM_13(256'h000000000000000000000000000000000000800000000000c000000080000000),.INIT_RAM_14(256'h0000000000000000000000000000000000200c21032660f85fff802080710446),.INIT_RAM_15(256'h00000000000000000000000000000000842187e184218421842984258423f421),.INIT_RAM_16(256'h00000000000000000000000000002000e0002207218ce06020302010e00807ff),.INIT_RAM_17(256'h0000000000000000000000000000008000ff0080008000ff0080008000ff0000),.INIT_RAM_18(256'h00000000000000000000000000000000088008800980f9000900f9000800fd00),.INIT_RAM_19(256'h0000000000000000000000000000c7804e476a4cea486a4f6bc86a4fea480a5f),.INIT_RAM_1A(256'h00000000000000000000000000000007fe04922c9343094209c20084fff70480),.INIT_RAM_1B(256'h00000000000000000000000000008020ffe780208020ffe180218020ffe30002),.INIT_RAM_1C(256'h0000000000000000000000000000000080008000800080008000000000000000),.INIT_RAM_1D(256'h00000000000000000000000000000000c4500450049e04f80491c49144fe5f97),.INIT_RAM_1E(256'h000000000000000000000000000000004c7dcfc144434642404af7fb444847f8),.INIT_RAM_1F(256'h0000000000000000000000000000000083a49224122533fc222423fd22242224),.INIT_RAM_20(256'h000000000000000000000000000000000190034902270029001101ff00110011),.INIT_RAM_21(256'h0000000000020002000410041ffc10841ffc80003ffc00807ffe008000800000),.INIT_RAM_22(256'h000000000141017f1f4131412141317f110009ff091009221122117f1f080000),.INIT_RAM_23(256'h00000000000000000000000000000000f8000000000000000000000000000000),.INIT_RAM_24(256'h00000000000000000000000000000000000f0000000000000000000000000000),.INIT_RAM_25(256'h0000000000800080008001800ff8008000800080008000000000000000000000),.INIT_RAM_26(256'h00000000000000004600c600e600a6002600160016001e000e000e0006000000),.INIT_RAM_27(256'h0000000000000000f98819881988198919891989198a198a198e198cf98c0000),.INIT_RAM_28(256'h000000000000000000c100c300c600cc00cc00c800cc00cc00c400c300c10000),.INIT_RAM_29(256'h000000000000000000000000000000000ff80000000000000000000000000000),.INIT_RAM_2A(256'h000000008000800080008000f800800080008000800000000000000000000000),.INIT_RAM_2B(256'h000000000000000000000001000f000000000000000000000000000000000000),.INIT_RAM_2C(256'hdc0010001000100010003c00f00010009000fc00900010001000000000000000),.INIT_RAM_2D(256'hd0811066101c10361021d06217ff1c0418051881d0ff10082008000000000000),.INIT_RAM_2E(256'h04fffc04dc0494048404847ff40407040004f0040c7f06040204000000000000),.INIT_RAM_2F(256'h10302038614b4f4c490449044907c9044904497f4904cf240014000000000000),.INIT_RAM_30(256'h0004000400040004000400040004003f0000000000000003001c000000000000),.INIT_RAM_31(256'h0c200000fffefffe00000300038001c000800000000000000000000000000000),.INIT_RAM_32(256'h06071ffe1ffe000c000c001c0018001800180000000000000000000000000000),.INIT_RAM_33(256'hfffc300c300c300cfffcfffc0000000000000000000000000000000000000000),.INIT_RAM_34(256'h00ff00c000c000c000ff00ff0000000000000000000000000000000000000000),.INIT_RAM_35(256'h38703ce01fc00f80078007c007e00ef00c301c120807200e700cf818b8381c70),.INIT_RAM_36(256'h079c03f801f000f000f080f081f801b80398031c030c030c070c060f060f060f),.INIT_RAM_37(256'h307830e033c0b700fe00ffffffff30003000300cfffcfffc300c300c300cfffc),.INIT_RAM_38(256'h0078001e00070003000107ff07ff0000000000c000ff00ff00c000c000c000ff),.INIT_RAM_39(256'h0000000000000000000000000000000000000000000000008002c00f801e1038),.INIT_RAM_3A(256'h00000000000000000000000000000000000000000000000010001c039e070f0f),.INIT_RAM_3B(256'h000000000000000000000000000000000000000000000000300030013007301e),.INIT_RAM_3C(256'h0000000000000000000000000000000000000000000000000000020007c003f0),.INIT_RAM_3D(256'h100c3018343032203160304030403ffe00c000d0008800840000000000000000),.INIT_RAM_3E(256'h0001000208020ffe08420ffe0000dffe00403fff804000400000000000000000),.INIT_RAM_3F(256'h44014401c7ff8401840107ff8000dfff418c01048fff40200020000000000000)) bank_7(
.DO(bank_data[7]),.DI(32'd0),.BLKSEL(3'd0),.AD({address[9:0],4'd0}),
.WRE(1'b0),.CLK(clk),.CE(address[14:10]==7),.OCE(1'b1),.RESET(1'b0));
SP #(.BIT_WIDTH(16),.READ_MODE(1'b0),.WRITE_MODE(2'b00),.INIT_RAM_00(256'h052405a402ac02a80422f6240108009007fe0021002007fc0000000000000000),.INIT_RAM_01(256'h900010003000e000200027ffa0002000e00020002000e0000000000000000000),.INIT_RAM_02(256'h01ff00c20006f3ff0800380060ff880009fff900010001ff0000000000000000),.INIT_RAM_03(256'h04022402e402247f2480e4c024302488e48004ff100288020000000000000000),.INIT_RAM_04(256'h1a400c40004f0048004c004f0048004c004f00400040007f0000000000000000),.INIT_RAM_05(256'h0000000000000000000000000000000000000000000000000000000000001f02),.INIT_RAM_06(256'h00000000000000000000000000000000000000000000000000000000040147ff),.INIT_RAM_07(256'h0000000000000000000000000000000000000000000000000000000000000038),.INIT_RAM_08(256'h0000000000000000000000000000000000000000000000000000000000008800),.INIT_RAM_09(256'h000000000000000000000000000000000000000000000000000000000000f900),.INIT_RAM_0A(256'h00000000000000000000000000000000000000000000000000000000000004ff),.INIT_RAM_0B(256'h000000000000000000000000000000000000000000000000000000000c001a78),.INIT_RAM_0C(256'h66004600c200c000fe00fe000c001c00180030006000fe00fe00000000000000),.INIT_RAM_0D(256'h018c018c018c018c018c9f8c3f8c018c018c01800180019c3ffe1e0000000000),.INIT_RAM_0E(256'hc18c710c330c030cff0fff0f03000300030003080318ff0cff06000200000000),.INIT_RAM_0F(256'h000100000000000c000f000f000c000c000c000c000c000f000f000000000000),.INIT_RAM_10(256'h08400840fffc08400840084008407ff800000000000000000000000000000000),.INIT_RAM_11(256'h00c03ffe00c000c01ffe03100218040800000000000000000000000000000000),.INIT_RAM_12(256'hfff0000000000000ffe6fffe003c007080e0c180630036001c001c0000000000),.INIT_RAM_13(256'h33073300330033003333333f331e330733033f003f0000000000000000000000),.INIT_RAM_14(256'h0c030fff00000402060607fe04020402060607fe0402060607fe000000000000),.INIT_RAM_15(256'h40004000fc004000400040004000f80000000000000000000000000000000000),.INIT_RAM_16(256'hc008fe08c0ffc008fe0810081808087f00000000000000000000000000000000),.INIT_RAM_17(256'h0000003f00000000001f00030002000400000000000000000000000000000000),.INIT_RAM_18(256'h980000000000900098009c008600820080008000b0009c008c00040000000000),.INIT_RAM_19(256'h38c1100000001fff1fff18011fff1fff1801180118011fff1fff000000000000),.INIT_RAM_1A(256'h893389338933893389339933f933013301330133ff3fff3f3000200000000000),.INIT_RAM_1B(256'h0009000900090009000900090009000800080008000f000f0000000000000000),.INIT_RAM_1C(256'h00000000000000000000000000000000000002008600ec00780038003c006c00),.INIT_RAM_1D(256'h0000000000000000000000000000000000003ff03fff0003000000003ffc3ffc),.INIT_RAM_1E(256'h00000000000000000000000000000000ff81ffe30037001e004c00cc00cc818c),.INIT_RAM_1F(256'h00000000000000000000000000000000001f001f000000000008001c000f0003),.INIT_RAM_20(256'h0000000000000000000000000000000000000000000000000808081008200860),.INIT_RAM_21(256'h00000000000000000000000000000000000000000000000010020c0c03300120),.INIT_RAM_22(256'h000000000000000000000000000000000010fff0fff00010001000100010fff0),.INIT_RAM_23(256'h00000000000000000000000000000000000400070007000433043f043f043307),.INIT_RAM_24(256'h0000000000000000000000000000000008030c030fff080308030c030fff0803),.INIT_RAM_25(256'h0000000000000000000000000000000000000000000000000800100020006000),.INIT_RAM_26(256'h00000000000000000000000000000000000000000000000002080c0830082008),.INIT_RAM_27(256'h0000000000000000000000000000000000000000000000000010000c00030001),.INIT_RAM_28(256'h00000000000000000000000000000000860086008e008c008c009c0098009800),.INIT_RAM_29(256'h000000000000000000000000000000000f013f8730df30d120c121df07ff1ec1),.INIT_RAM_2A(256'h0000000000000000000000000000000081008100010001330133193ff93f8933),.INIT_RAM_2B(256'h000000000000000000000000000000000007000f000c00080008000800090009),.INIT_RAM_2C(256'ha2002200e20022003e0000000000000000000000000000000000000000000000),.INIT_RAM_2D(256'h09100910f97f01100410e2100000000000000000000000000000000000000000),.INIT_RAM_2E(256'h00120013001300100010001f0000000000000000000000000000000000000000),.INIT_RAM_2F(256'h673839d800000000000000000000000000000000000000000000000000000000),.INIT_RAM_30(256'h0026003c00000000000000000000000000000000000000000000000000000000),.INIT_RAM_31(256'h222422273fe0020c7fe402020000000000000000000000000000000000000000),.INIT_RAM_32(256'h006004fa191300601fff00400000000000000000000000000000000000000000),.INIT_RAM_33(256'h1800180018001800180000000000000000000000000000000000000000000000),.INIT_RAM_34(256'h08081f8800080008000800000000000000000000000000000000000000000000),.INIT_RAM_35(256'h180022000200fe00800080000000000000000000000000000000000000000000),.INIT_RAM_36(256'h090c0922f920013f0400e2000000000000000000000000000000000000000000),.INIT_RAM_37(256'h02c80688048808c8187000000000000000000000000000000000000000000000),.INIT_RAM_38(256'h00000000000000000000000000000000000022003e002200220022002200be00),.INIT_RAM_39(256'h000000000000000000000000000000000000010f01180910f91009110911f911),.INIT_RAM_3A(256'h000000000000000000000000000000000000001e001000100013001208131813),.INIT_RAM_3B(256'h0000000000000000000000000000000000000000631863186318631863186318),.INIT_RAM_3C(256'h0000000000000000000000000000000000000000001e003200200038000e0002),.INIT_RAM_3D(256'h0000000000000000000000000000000000007ff0000ea23412640e8423243fe4),.INIT_RAM_3E(256'h000000000000000000000000000000000000004000403fff004012411bff053c),.INIT_RAM_3F(256'h000000000000000000000000000000000000000018001800180018001808f818)) bank_8(
.DO(bank_data[8]),.DI(32'd0),.BLKSEL(3'd0),.AD({address[9:0],4'd0}),
.WRE(1'b0),.CLK(clk),.CE(address[14:10]==8),.OCE(1'b1),.RESET(1'b0));
SP #(.BIT_WIDTH(16),.READ_MODE(1'b0),.WRITE_MODE(2'b00),.INIT_RAM_00(256'h00000000000000000000000000000000000000001fc8018801080208060c0c0f),.INIT_RAM_01(256'h000000000000000000000000000000000000fe00800080008000fc0002000e00),.INIT_RAM_02(256'h000000000000000000000000000000000000013f01000900f900091f0920f930),.INIT_RAM_03(256'h0000000000000000000000000000000000000000382024604640448025803970),.INIT_RAM_04(256'h0000000000000000f80000000000000000000000000000000000000000000000),.INIT_RAM_05(256'h0000000000000000000f00000000000000000000000000000000000000000000),.INIT_RAM_06(256'h008001800ff80080008000800080000000000000000000000000000000000000),.INIT_RAM_07(256'h0000000000000000000000000000000000000000000000000000000000800080),.INIT_RAM_08(256'h3400fc0004000400fc0000000000000000000000000000000000000000000000),.INIT_RAM_09(256'hf290011fe9002f00e207023c0000000000000000000000000000000000000000),.INIT_RAM_0A(256'h003f0001001f0011001f00010000000000000000000000000000000000000000),.INIT_RAM_0B(256'h0204222618c20c88202c3fe20000000000000000000000000000000000000000),.INIT_RAM_0C(256'h04121ffe041200023ffe00800000000000000000000000000000000000000000),.INIT_RAM_0D(256'hc80088008800c800700000000000000000000000000000000000000000000000),.INIT_RAM_0E(256'h0002000600040008001800000000000000000000000000000000000000000000),.INIT_RAM_0F(256'hff000400fc000000fe0080000000000000000000000000000000000000000000),.INIT_RAM_10(256'h087fe8080a0ffb00013f00000000000000000000000000000000000000000000),.INIT_RAM_11(256'h001200130002003f0012000a0000000000000000000000000000000000000000),.INIT_RAM_12(256'h0000000000000000000000000000000000001900720082008400c40044002400),.INIT_RAM_13(256'h0000000000000000000000000000000000003230c61c2e072a032204e20c0208),.INIT_RAM_14(256'h00000000000000000000000000000000000000180007001100110010081f1800),.INIT_RAM_15(256'h000000000000000000000000000000000000a212323212660a84068407043ff0),.INIT_RAM_16(256'h000000000000000000000000000000000000180c077101c104330ffa000207f2),.INIT_RAM_17(256'h0000000000000000000000000000000000000000200060004000800080087018),.INIT_RAM_18(256'h0000000000000000000000000000000000000000003800240046004400250039),.INIT_RAM_19(256'h0000000000000000000000000000000000001000700092001800a000fc000400),.INIT_RAM_1A(256'h000000000000000000000000000000000000840005302d0ce90f2b102a0fea08),.INIT_RAM_1B(256'h0000000000000000000000000000000000000018001900260024000d080d181b),.INIT_RAM_1C(256'h2400e6002200e8002400e2000000000000000000000000000000000000000000),.INIT_RAM_1D(256'hff10071f0c10101fa010c01f0000000000000000000000000000000000000000),.INIT_RAM_1E(256'h001f001c00060001000000000000000000000000000000000000000000000000),.INIT_RAM_1F(256'h10241fe610221fe810241fe20000000000000000000000000000000000000000),.INIT_RAM_20(256'h1fff1c07060c011000a000c00000000000000000000000000000000000000000),.INIT_RAM_21(256'h0000000000000000000000000000000000002200e20026002400e40024000000),.INIT_RAM_22(256'h000000000000000000000000000000000000063cfe270602060e063bfe220000),.INIT_RAM_23(256'h000000000000000000000000000000000000000c000f000c000c000c080f1800),.INIT_RAM_24(256'h0000000000000000000000000000000000003c2227e202260e243be422240000),.INIT_RAM_25(256'h0000000000000000000000000000000000000c060ffe0c060c060c060ffe0000),.INIT_RAM_26(256'h0200000000000000000000000000000000000000000000000000000000000000),.INIT_RAM_27(256'h0003000000000000000000000000000000000000000000000000000000000000),.INIT_RAM_28(256'h0002000000000000000000000000000000000000000000000000000000000000),.INIT_RAM_29(256'h0800000000000000000000000000000000000000000000000000000000000000),.INIT_RAM_2A(256'h000c000000000000000000000000000000000000000000000000000000000000),.INIT_RAM_2B(256'hffc000400040ffc000400040ffc000000000fff8c30081008100fff018000800),.INIT_RAM_2C(256'h4043c0c291821b030e0206020f030980204070dfd980890080013fef00000600),.INIT_RAM_2D(256'hf02011301319120f8006000e040efc0b0419041104110411fc11207f30011001),.INIT_RAM_2E(256'h180f308820c06021c0014000c020fe3f00200420fc204020403f6004fc0c0008),.INIT_RAM_2F(256'h707cf0c0b0c0b0c0b0ffb000b00097ff8006b202f3ff303030203020f3ff0006),.INIT_RAM_30(256'h07f0041304100410041007f0080f0e3803e001c0036b063a043a0ff200230020),.INIT_RAM_31(256'h00006700cc000c000c00cc008c008f00ee001c000c004c007f00cc000c000c00),.INIT_RAM_32(256'h00000840e871081e080f081908100831c8ff0b010e030c420c40e87f18041004),.INIT_RAM_33(256'h00000400ecff9c049404840484048404e47f040407040004e0040c7f06040206),.INIT_RAM_34(256'h00002060407080d78298be08a208a208a20ba208a208a20ca2ffa20cbe6c002c),.INIT_RAM_35(256'h00000010fe10001000100011fc1100110011feff8001900198018801841f8070),.INIT_RAM_36(256'h00000060e67f86608660fe60867f8660fe60867f8601fe0d0019ff3120213001),.INIT_RAM_37(256'h00000200023804600460fc640c640c640c64fc640064fc64000000fffe040008),.INIT_RAM_38(256'h00008600fe0086008620863ffe2100210021ff3f48004c3f8401fe0110ff1001),.INIT_RAM_39(256'h0000000400040074004400c400c40044006400350024002400440045007c0000),.INIT_RAM_3A(256'h031084108c10c87050d0f090bc90359023122114235423540230ff9002100210),.INIT_RAM_3B(256'h83c3fc017c10c62001c0ff8003010043ffc20040ffc00050ffe00047ffc00180),.INIT_RAM_3C(256'hff0f01010100ff0101030107ff0000060007ffe60c0704060407ffc0600f2000),.INIT_RAM_3D(256'h010f030846086c0f380818083c0f26008100c37f660324020006ffbf00001800),.INIT_RAM_3E(256'ha48154c30066fc3c60186038fc38602c6464fc456447f446fc4665fcfc040004),.INIT_RAM_3F(256'h4304e30ec199409340904070406340606062786303fe80228222c12260e32020)) bank_9(
.DO(bank_data[9]),.DI(32'd0),.BLKSEL(3'd0),.AD({address[9:0],4'd0}),
.WRE(1'b0),.CLK(clk),.CE(address[14:10]==9),.OCE(1'b1),.RESET(1'b0));
SP #(.BIT_WIDTH(16),.READ_MODE(1'b0),.WRITE_MODE(2'b00),.INIT_RAM_00(256'h8c06860c8209811b813280b080a0e0e0c0e0c060804080400040004000400040),.INIT_RAM_01(256'h7ffd10191ff9101910191ff9101910191ff910191ff9018101813ffd01830182),.INIT_RAM_02(256'h0000000000000000000000000000000000000000000000000000000000000040),.INIT_RAM_03(256'h0000000000000000000000000000000000000000000000000000000000000002),.INIT_RAM_04(256'h0000000000000000000000000000000000000000000000000000000000000400),.INIT_RAM_05(256'h0000000000000000000000000000000000000000000000000000000000000410),.INIT_RAM_06(256'h0000000000000000000000000000000000000000000000000000000000000110),.INIT_RAM_07(256'h0000000000000000000000000000000000000000000000000000000000000062),.INIT_RAM_08(256'h0000000000000000000000000000000000000000000000000000000000000100),.INIT_RAM_09(256'h0000000000000000000000000000000000000000000000000000000000000008),.INIT_RAM_0A(256'h0000000000000000000000000000000000000000000000000000000000000204),.INIT_RAM_0B(256'h0000000000000000000000000000000000000000000000000000000000008802),.INIT_RAM_0C(256'hc60cc60cc60cc60cc60cc7fcc7fc000000000000000000000000000000000000),.INIT_RAM_0D(256'h87ff060006000600060007ff07ff000000000000000000000000000000000000),.INIT_RAM_0E(256'hfee161c36086e006ff0cff1c8018803880100000000000000000000000000000),.INIT_RAM_0F(256'h000f00000000000003ff03ff0001000100010000000000000000000000000000),.INIT_RAM_10(256'hcffccfccc0ccc0ccc0ccc0ccc0cccfcccfccc0ccc0ccc0c0c0c0c0c8c7fcc7fc),.INIT_RAM_11(256'h879e81d800e000e003f087b89e18881c060c07ff07ff060006000600860087ff),.INIT_RAM_12(256'h0e010c3f1cff38e030007003203f00fffcf7fc060c0e1c1c18181838387ffeff),.INIT_RAM_13(256'h0e0c060c070c038c018c01cc008c000c03ff03ff000c000c000c000c000c000f),.INIT_RAM_14(256'h0000000000000000000000000000000000000000000000004000e000e00ee3fe),.INIT_RAM_15(256'h000000000000000000000000000000000000000000000000000008001c030f0f),.INIT_RAM_16(256'h00000000000000000000000000000000000000000000000000000000c000e400),.INIT_RAM_17(256'h000000000000000000000000000000000000000000000000000000000007040f),.INIT_RAM_18(256'h1ff810181ff8101b1ffe101c1ff800107fff00203ffe00403ffe000000000000),.INIT_RAM_19(256'h1f86108c309020a008e208e20842884208420842c84208020ffe000000000000),.INIT_RAM_1A(256'he00883c8860884088408e408840887ff8000e18c9fff818c818c000000000000),.INIT_RAM_1B(256'h840887f8840804080408040907fb04090408040b07f800600040000000000000),.INIT_RAM_1C(256'h000000001000f0009000900090009000900090009000f0000000000000000000),.INIT_RAM_1D(256'h304160428046004410441044104413fc100410041004103cf1c0000000000000),.INIT_RAM_1E(256'he0fc14844984c9058847e84708420e420042d04208420c40047f000000000000),.INIT_RAM_1F(256'h0eff7800c2100410881190ff8011ff118811887f881188118011000000000000),.INIT_RAM_20(256'h0d000d0006010007000c00180010007f00000000001f00000000000000000000),.INIT_RAM_21(256'h0000000000000000000000000000000000000000000000000000000000004000),.INIT_RAM_22(256'h0000000000000000000000000000000000000000000000000000000000000600),.INIT_RAM_23(256'h7c007c0000000000000000000000000000000000000000000000000000000000),.INIT_RAM_24(256'h0318061c02080000000000000000000000000000000000000000000000000000),.INIT_RAM_25(256'hff04ff0400040000000000000000000000000000000000000000000000000000),.INIT_RAM_26(256'h1800180018001800000000000000000000000000000000000000000000000000),.INIT_RAM_27(256'he006e00600060006000000000000000000000000000000000000000000000000),.INIT_RAM_28(256'h1fff1fff00000000000000000000000000000000000000000000000000000000),.INIT_RAM_29(256'hc000c00000000000000000000000000000000000000000000000000000000000),.INIT_RAM_2A(256'h8001000300030000000000000000000000000000000000000000000000000000),.INIT_RAM_2B(256'hffff018001800080000000000000000000000000000000000000000000000000),.INIT_RAM_2C(256'h6083300010000000000000000000000000000000000000000000000000000000),.INIT_RAM_2D(256'h0010000000000000000000000000000000000000000000000000000000000000),.INIT_RAM_2E(256'h00c300c300c300c3000000000000000000000000000000000000000000000000),.INIT_RAM_2F(256'h8606830301000000000000000000000000000000000000000000000000000000),.INIT_RAM_30(256'h0000000100010000000000000000000000000000000000000000000000000000),.INIT_RAM_31(256'h460046004400440044007c007c0044004400440044007c007c00440044004400),.INIT_RAM_32(256'h118e118c319811980190c19081b08dbe0ffe0c060c060c060c060c0ecffe0190),.INIT_RAM_33(256'hc0c4c0c4c184c184c184c104c105c325c337c33fc31ec306c306c30ec33fc304),.INIT_RAM_34(256'hffc71844184c184c184c18441840ffc0ffc018401840184018401840ffc0ffc0),.INIT_RAM_35(256'he0ff6086608660866086e086e08660ff60ff60866086e086e086608660ff60ff),.INIT_RAM_36(256'h1fff18001800180018001fff1fff18001800180018001fff1fff180018001800),.INIT_RAM_37(256'h030003000300060006000c000c000c001800180030003000300060006000c000),.INIT_RAM_38(256'hfc00040004000400fc00fc00040004000400fc00fc00040004000400fc00fc00),.INIT_RAM_39(256'hc3ff82000200020003ff03ff02000200020003ffc3ffc2000200820083ff83ff),.INIT_RAM_3A(256'hfff001b9010f01070107ff06ff06010601060100ffffffff000000000000ffff),.INIT_RAM_3B(256'h07839e00f800f000f00098019c010c00060006000303030301804183c1836083),.INIT_RAM_3C(256'hf83e080708010800080008010803f803f8060806080c080c08180818f818f818),.INIT_RAM_3D(256'h1fff10c310c310c310c310c310c31fff1fff10c310c390c310c310c31fff1fff),.INIT_RAM_3E(256'h018e009c01b4ffa400840184ff8400040004ffe4cc07458744c044c0cc00ffec),.INIT_RAM_3F(256'h000300020003000300020003000300000000001f00000003000600040000000f)) bank_10(
.DO(bank_data[10]),.DI(32'd0),.BLKSEL(3'd0),.AD({address[9:0],4'd0}),
.WRE(1'b0),.CLK(clk),.CE(address[14:10]==10),.OCE(1'b1),.RESET(1'b0));
SP #(.BIT_WIDTH(16),.READ_MODE(1'b0),.WRITE_MODE(2'b00),.INIT_RAM_00(256'h4fc040804080f880008000000000000000000000000000000000000000000000),.INIT_RAM_01(256'h2fd84318c318831f830000000000000000000000000000000000000000000000),.INIT_RAM_02(256'hc408fc18401f4000400100000000000000000000000000000000000000000000),.INIT_RAM_03(256'h208c20ff2008e008000800000000000000000000000000000000000000000000),.INIT_RAM_04(256'h01000100010001ff000000000000000000000000000000000000000000000000),.INIT_RAM_05(256'h100010003000ff00000000000000000000000000000000000000000000000000),.INIT_RAM_06(256'hfe081808101810ff100000000000000000000000000000000000000000000000),.INIT_RAM_07(256'h0184008c00880018001000000000000000000000000000000000000000000000),.INIT_RAM_08(256'h0020e060004080c0000000000000000000000000000000000000000000000000),.INIT_RAM_09(256'h00607fff00601fff000000000000000000000000000000000000000000000000),.INIT_RAM_0A(256'h0180fffe01800180018000000000000000000000000000000000000000000000),.INIT_RAM_0B(256'h000000000000000000000000000000000000000000000000000002007b007e00),.INIT_RAM_0C(256'h0000000000000000000000000000000000000000000000000000000000031f07),.INIT_RAM_0D(256'h0000000000000000000000000000000000000000000000000000000000248064),.INIT_RAM_0E(256'h000000000000000000000000000000000000000000000000000000000040ffc3),.INIT_RAM_0F(256'h000000000000000000000000000000000000000000000000000000006080e0ff),.INIT_RAM_10(256'h0000000000000000000000000000000000000000000000000000000018001fff),.INIT_RAM_11(256'h0000000000000000000000000000000000000000000000000000000001800180),.INIT_RAM_12(256'h000000000000000000000000000000000000000000000000000000000400fc00),.INIT_RAM_13(256'h000000000000000000000000000000000000000000000000000000004200e3ff),.INIT_RAM_14(256'h000000000000000000000000000000000000000000000000000000000000ff80),.INIT_RAM_15(256'h00000000000000000000000000000000000000000000000000000000003001f3),.INIT_RAM_16(256'h0000000000000000000000000000000000000000000000000000000008c0f8f8),.INIT_RAM_17(256'h0000000000000000000000000000000000000000000000000000000010001fff),.INIT_RAM_18(256'h000000000000000000000000000000000000000000000000000000000080ff86),.INIT_RAM_19(256'h0000000000000000000000000000000000000000000000000000000000020003),.INIT_RAM_1A(256'h000000000000000004008c0018c011c033802e806080608060804080408041f0),.INIT_RAM_1B(256'h00000000000000001bc07307c30c03080308fb0823c827982f182318f3183318),.INIT_RAM_1C(256'h00000000000000000460fc7044084405440744ffc422fc2244224422443f440c),.INIT_RAM_1D(256'h00000000000020002080e0ff2088208820882088e08c20ff208820882088e088),.INIT_RAM_1E(256'h0000000000000100010001ff010001000100010001ff010001000100010001ff),.INIT_RAM_1F(256'h0000000000000000010007000c0018001800100010003000ff80100010001000),.INIT_RAM_20(256'h000000000000000004080c089808f008700878084c084c184dffc8088808d808),.INIT_RAM_21(256'h0000000000000000010201fe010201020102010201fe00000200020f03fe0306),.INIT_RAM_22(256'h00000000000000000003e003000280060004800c800c80088018801080308030),.INIT_RAM_23(256'h000000000000000000007fff00601fff006018611fff186118611fff18611fff),.INIT_RAM_24(256'h000000000000000001808181e187398c0db003e003c0ffff018009901998318c),.INIT_RAM_25(256'h0000000000000000000000000000000000000000000000010000000000000000),.INIT_RAM_26(256'hfe00120012001200fe00120012001200fe001000100000000000000000000000),.INIT_RAM_27(256'hff8f808980898089ff8f80898089ff89808f8081ff8100000000000000000000),.INIT_RAM_28(256'h0400040004000400040004000400078007000400000000000000000000000000),.INIT_RAM_29(256'h0100010021082108311811101930092001000100010000000000000000000000),.INIT_RAM_2A(256'h0020c7fe2021c7fe40220200c3fe4202c3fe4202c3fe00000000000000000000),.INIT_RAM_2B(256'h400440ff800480ff80040040007f0040007f0040007f00000000000000000000),.INIT_RAM_2C(256'h3f000100030006000c0110013001300211020e02000000000000000000000000),.INIT_RAM_2D(256'h631026b014a018600840086049904390fe8002f0040000000000000000000000),.INIT_RAM_2E(256'hc0424846444c824880408ffe20424044400440fc870000000000000000000000),.INIT_RAM_2F(256'h819480e70042014201400140014d01f40022004203fa00000000000000000000),.INIT_RAM_30(256'h1c0022006001600120031c023002200422041c04000000000000000000000000),.INIT_RAM_31(256'h7fc040407fc040407fc00000fff011002080ffe0040004000000000000000000),.INIT_RAM_32(256'h0844089c089408a408940894302d08d404940714021c00000000000000000000),.INIT_RAM_33(256'h00080008f0102010603040208020804000400040000000000000000000000000),.INIT_RAM_34(256'h400240024007ff0240024002fe0240034003fe03000000000000000000000000),.INIT_RAM_35(256'h84808480848088bf8ac089c0888f88808be08880f88f00000000000000000000),.INIT_RAM_36(256'h018201820182218019800d8003800180018001807ffc00000000000000000000),.INIT_RAM_37(256'h013100c201a20114021403f800080fff00110211019200000000000000000000),.INIT_RAM_38(256'h0000000000000000000000000000000000000000000000000000000000000200),.INIT_RAM_39(256'h0000000000000000000000000000000000000000000000000000000000008088),.INIT_RAM_3A(256'h00000000000000000000000000000000000000000000000000000000000001e0),.INIT_RAM_3B(256'h000000000000000000000000000000000000000000000000000000000000efff),.INIT_RAM_3C(256'h00000000000000000000000000000000000000000000000000000000200061ff),.INIT_RAM_3D(256'h0000000000000000000000000000000000000000000000000000000000004088),.INIT_RAM_3E(256'h0000000000000000000000000000000000000000000000000000000000000070),.INIT_RAM_3F(256'h000000000000000000000000000000000000000000000000000000004000c008)) bank_11(
.DO(bank_data[11]),.DI(32'd0),.BLKSEL(3'd0),.AD({address[9:0],4'd0}),
.WRE(1'b0),.CLK(clk),.CE(address[14:10]==11),.OCE(1'b1),.RESET(1'b0));
SP #(.BIT_WIDTH(16),.READ_MODE(1'b0),.WRITE_MODE(2'b00),.INIT_RAM_00(256'h0000000000000000000000000000000000000000000000000000000000004040),.INIT_RAM_01(256'h0000000000000000000000000000000000000000000000000000000000000824),.INIT_RAM_02(256'h000000000000000000000000000000000000000000000000000000000004000c),.INIT_RAM_03(256'h0000000000000000000000000000000000000000000000000000000000007800),.INIT_RAM_04(256'h0000000000000000000000000000000000000000000000000000000000008280),.INIT_RAM_05(256'h0000000000000000000000000000000000000000000000000000000000008181),.INIT_RAM_06(256'h000000000000000000000000000000000000000000000000000000000000040c),.INIT_RAM_07(256'h0400020000000000000000000000000000000000000000000000000000000000),.INIT_RAM_08(256'h0006000600000000000000000000000000000000000000000000000000000000),.INIT_RAM_09(256'h8003000100000000000000000000000000000000000000000000000000000000),.INIT_RAM_0A(256'h3e0f000000000000000000000000000000000000000000000000000000000000),.INIT_RAM_0B(256'h6018000000000000000000000000000000000000000000000000000000000000),.INIT_RAM_0C(256'h0000000000000000f0000f002400c40084004400c40044004700c0000800ec00),.INIT_RAM_0D(256'h000000000000000019ffc20082464636f40f0467c47f4466fc66447f0406fcff),.INIT_RAM_0E(256'h00000000000000000070800f80078018803f8000801f8018807f8018800080ff),.INIT_RAM_0F(256'h00000000000000000000020f02380230022002307e18e20fc218c210c230e218),.INIT_RAM_10(256'h00000000000000000000410843084388468844c84c4848485868702870387018),.INIT_RAM_11(256'h0200fe008800ffc0880008007f80098001007fc0020006000000000000000000),.INIT_RAM_12(256'h2c10ec1f0f008e108e118c118cff0801e801181f107000000000000000000000),.INIT_RAM_13(256'h010001ff00000040007f0040007f000001ff000c000400000000000000000000),.INIT_RAM_14(256'h2f8021002300a20027c02c802980a100a3002300020000000000000000000000),.INIT_RAM_15(256'h3e35841e0c0e087f1f04d215363524258c240804080400000000000000000000),.INIT_RAM_16(256'h0011009401920111010003ff0018001801ff0018001800000000000000000000),.INIT_RAM_17(256'h9e00a6000c0008009f00120026002400cc000800180018000000000000000000),.INIT_RAM_18(256'h3181f1ff3000300031fff0180018001803fffc18001800180000000000000000),.INIT_RAM_19(256'h231e23ff230c030c630ce3ff600c600c600ce7ff000c000c0000000000000000),.INIT_RAM_1A(256'h919108b70ff1c811881188370ff4081408340ff7000000000000000000000000),.INIT_RAM_1B(256'h0c0d7fe10462044704cc07f9008901837ff20102030600000000000000000000),.INIT_RAM_1C(256'h00000000000000000000000000000000000000000200fe0002000200fe000200),.INIT_RAM_1D(256'h00000000000000000000000000000000000000000c100c1f0c100c100c1fcc10),.INIT_RAM_1E(256'h0000000000000000000000000000000000000000000f000800080008000800ff),.INIT_RAM_1F(256'h00000000000000000000000000000000000000000000e00021802f802000a380),.INIT_RAM_20(256'h000000000000000000000000000000000000c00080000eff3e000004c0440e24),.INIT_RAM_21(256'h0000000000000000000000000000000000000100018300c6002c003803ff0012),.INIT_RAM_22(256'h00000000000000000000000000000000000000000000800083009e00f0008000),.INIT_RAM_23(256'h00000000000000000000000000000000000000000800198161ffc18181810181),.INIT_RAM_24(256'h000000000000000000000000000000000000000c040c670ce18c20cc202d201e),.INIT_RAM_25(256'h000000000000000000000000000000000000000000101030dcf7869703118f11),.INIT_RAM_26(256'h000000000000000000000000000000000000000007a0c420c463644f24c02483),.INIT_RAM_27(256'h0400cc004800c6004c00c8000000000000000000000000000000000000000000),.INIT_RAM_28(256'hff0000df0190821fc410481f0000000000000000000000000000000000000000),.INIT_RAM_29(256'h0001000400030001000000000000000000000000000000000000000000000000),.INIT_RAM_2A(256'h270060004400f400860082000000000000000000000000000000000000000000),.INIT_RAM_2B(256'hffc230023000ff9f300030000000000000000000000000000000000000000000),.INIT_RAM_2C(256'h000f000000000007000000000000000000000000000000000000000000000000),.INIT_RAM_2D(256'h0ffc88048804880008000ffe0000000000000000000000000000000000000000),.INIT_RAM_2E(256'hc3ff44004400c7ff003000100000000000000000000000000000000000000000),.INIT_RAM_2F(256'h00970110001003ff001000500000000000000000000000000000000000000000),.INIT_RAM_30(256'h0ffcc80408040ffc831002100000000000000000000000000000000000000000),.INIT_RAM_31(256'hc0008fff20842084c7ff80300000000000000000000000000000000000000000),.INIT_RAM_32(256'h004000400049004903ff00300000000000000000000000000000000000000000),.INIT_RAM_33(256'h0000ff0010001000fe00c0000000000000000000000000000000000000000000),.INIT_RAM_34(256'h6080d0bf8c820482019fff800000000000000000000000000000000000000000),.INIT_RAM_35(256'h0000000000010001000000070000000000000000000000000000000000000000),.INIT_RAM_36(256'h0000000000000000000000000000000000000000040044000400f4000500e600),.INIT_RAM_37(256'h0000000000000000000000000000000000000080f30782080408043f0c08081f),.INIT_RAM_38(256'h0000000000000000000000000000000000000000000000010001000100010001),.INIT_RAM_39(256'h0000000000000000000000000000000000000000f0000e000400f4000400e400),.INIT_RAM_3A(256'h0000000000000000000000000000000000000000003fff023102313f3102301f),.INIT_RAM_3B(256'h0000000000000000000000000000000000000000000200030002000200020000),.INIT_RAM_3C(256'h00000000000000000000000000000000000000009ffc10043004100480040804),.INIT_RAM_3D(256'h000000000000000000000000000000000000000017c1ac432844204467ff4000),.INIT_RAM_3E(256'h00000000000000000000000000000000000000000184035b0232022200740094),.INIT_RAM_3F(256'h000000000000000000000000000000000000000003f016111412089200400804)) bank_12(
.DO(bank_data[12]),.DI(32'd0),.BLKSEL(3'd0),.AD({address[9:0],4'd0}),
.WRE(1'b0),.CLK(clk),.CE(address[14:10]==12),.OCE(1'b1),.RESET(1'b0));
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
