Ring-F-nebula/fpga-multitimbral-instrument/firmware/src/poly32_synth.v

// 32 independently gated DDS voices: independent phase/frequency/ADSR/gain.
// Piano/drum/proof waveforms retain COMPETITION32 scaling and fixed headroom.
// Guitar uses measured analytic spectra, 12-bit/1024-point band-limited DDS,
// independent pluck tails, smoothed retriggers and time-varying brightness.
// EXTERNAL_MASTER moves production master gain after the effects.
// Active retriggers retain phase; no voice-count gain jumps.
module poly32_synth #(parameter EXTERNAL_MASTER=0)(input clk,sample_tick,clear,input [31:0] keys,
 input [255:0] note_numbers,input [287:0] voice_gains,input [1:0] instrument,
 input song_gate,input [23:0] song_step,input [3:0] volume,input [8:0] mode_gain,
 input [3:0] attack_sel,decay_sel,release_sel,input [7:0] sustain_level,
 input signed [8:0] expression_bend,input [6:0] expression_vibrato,input [4:0] target_voice,
 input [127:0] fx_params,input test_mode,input [5:0] test_voice_count,
 output reg signed [15:0] pcm=0,output reg pcm_valid=0,output audio_active,
 output [31:0] active_envelopes,output [15:0] phase0,output [7:0] envelope0,
 output reg [5:0] active_count=0,output reg overrun=0);
 // Pipeline asynchronous-to-sample control decoding at the fabric clock.
 reg [31:0] keys_q=0;reg [1:0] instrument_q=0;reg test_mode_q=0;
 reg [127:0] fx_params_q=0;reg song_gate_q=0;reg [23:0] song_step_q=0;
 reg signed [8:0] expression_bend_q=0;reg [6:0] expression_vibrato_q=0;reg [4:0] target_voice_q=0;
 always @(posedge clk)begin
  keys_q<=clear?32'd0:keys;song_gate_q<=clear?1'b0:song_gate;
  instrument_q<=instrument;test_mode_q<=test_mode;fx_params_q<=fx_params;song_step_q<=song_step;
  expression_bend_q<=expression_bend;expression_vibrato_q<=expression_vibrato;target_voice_q<=target_voice;
 end
 reg [23:0] vib_phase=0;
 wire [23:0] vib_rate=(fx_params_q[95:88]*24'd9424)>>8;
 wire signed [8:0] vib_triangle=vib_phase[23]?$signed({1'b0,~vib_phase[22:15]})-9'sd128:$signed({1'b0,vib_phase[22:15]})-9'sd128;
 wire [7:0] depth={1'b0,expression_vibrato_q};
 reg signed [17:0] vp=0;
 always @(posedge clk)if(clear)vp<=0;else vp<=vib_triangle*$signed({1'b0,depth});
 wire signed [10:0] remote_bend=fx_params_q[6]?($signed({1'b0,fx_params_q[119:112]})-11'sd100)*2:11'sd0;
 wire signed [10:0] cents_sum=$signed(expression_bend_q)+remote_bend+($signed(vp)>>>7);
 wire signed [9:0] cents=cents_sum>300?10'sd300:cents_sum< -300?-10'sd300:cents_sum[9:0];
 reg signed [9:0] cents_q=0;wire [16:0] coefficient_wire;reg [16:0] coefficient=65536;
 fx_pitch_coeff pitch(.cents(cents_q),.coeff(coefficient_wire));
 always @(posedge clk)if(clear)begin cents_q<=0;coefficient<=65536;end
 else begin cents_q<=cents;coefficient<=coefficient_wire;end
 always @(posedge clk)if(clear)vib_phase<=0;else if(sample_tick)vib_phase<=vib_phase+vib_rate;
 wire [767:0] bank_steps;wire frequency_done,frequency_overrun;
 frequency_bank4 frequency_bank(.clk(clk),.clear(clear),.frame_tick(sample_tick),.keys(keys_q),.notes(note_numbers),
  .glide_enable(fx_params_q[3]&&!test_mode_q&&instrument_q!=2),.glide_time(fx_params_q[83:80]),
  .coefficient(coefficient),.target_voice(target_voice_q),.expression_enable(!test_mode_q&&instrument_q!=2),
  .phase_steps(bank_steps),.done(frequency_done),.overrun(frequency_overrun));
 reg frame_test=0;reg [1:0] frame_instrument=0;reg [23:0] frame_song_step=0;
 always @(posedge clk)if(sample_tick)begin frame_test<=test_mode_q;frame_instrument<=instrument_q;frame_song_step<=song_step_q;end
 wire [23:0] phases[0:32];wire [15:0] envelopes[0:32];wire [8:0] gains[0:32];
 wire [7:0] brightness[0:32];wire [15:0] string_levels[0:32];
 wire score_active;assign audio_active=(|active_envelopes)||score_active;
 reg [16:0] random_bits=17'h1ab73;reg signed [7:0] noise=0,old_noise=0;
 always @(posedge clk)if(sample_tick)begin random_bits<={random_bits[15:0],random_bits[16]^random_bits[13]};noise<=random_bits[15:8];old_noise<=noise;end
 genvar v;
 generate for(v=0;v<33;v=v+1)begin: voices
  reg [23:0] phase=0,phase_q=0,natural=0,guitar_slew=0;
  reg [15:0] env_q=0,pluck_brightness=0,brightness_slew=0,string_level_q=0;
  reg [7:0] brightness_q=0;
  reg previous_gate=0,phase_attack=0,phase_running=0;
  wire gate;wire [23:0] step;wire [15:0] env,selected_env;wire [2:0] env_state;
  // Schroeder phases are compile-time constants, selected by requested
  // profile (not active envelopes). They retain all independent DDS voices
  // while reducing coherent multitone peaks. Normal playing starts at zero.
  localparam [23:0] SEED4=-(v*(v-1)*2097152);
  localparam [23:0] SEED8=-(v*(v-1)*1048576);
  localparam [23:0] SEED16=-(v*(v-1)*524288);
  localparam [23:0] SEED32=-(v*(v-1)*262144);
  function [23:0] proof_seed;input [5:0] requested;
   begin case(requested)
    4:proof_seed=SEED4;8:proof_seed=SEED8;16:proof_seed=SEED16;32:proof_seed=SEED32;
    default:proof_seed=0;
   endcase end
  endfunction
  if(v==32)begin: score
   assign gate=song_gate_q;assign step=frame_song_step;assign selected_env=env;assign score_active=(env!=0);assign gains[v]=256;
   adsr_envelope envelope(.clk(clk),.tick(sample_tick),.clear(clear),.gate(gate),.attack_sel(4'd0),.decay_sel(4'd2),.release_sel(4'd2),.sustain_level(8'd255),.level(env),.state(env_state));
  end else begin: manual
   reg [8:0] gain_q=256;reg [23:0] drum_step=0,drum_snapshot=0;
   assign gate=keys_q[v];assign gains[v]=gain_q;
   // Coherent FFT bins 8,10,...70: 356..3115 Hz at the production Fs.
   assign step=frame_test?((24'd8+v*24'd2)<<14):frame_instrument==2?drum_snapshot:bank_steps[v*24+:24];
   assign selected_env=(test_mode_q||instrument_q==0)?env:instrument_q==1?(guitar_slew[23:8]!=0?env:16'd0):natural[23:8];
   assign active_envelopes[v]=(selected_env!=0);
   // Preserve local control registers so 32 ADSRs do not share one long mode fanout path.
   reg [3:0] env_attack /* synthesis syn_preserve=1 */ =0;
   reg [3:0] env_decay /* synthesis syn_preserve=1 */ =0;
   reg [3:0] env_release /* synthesis syn_preserve=1 */ =0;
   reg [7:0] env_sustain /* synthesis syn_preserve=1 */ =0;
   always @(posedge clk)begin
    env_attack<=test_mode?4'd0:attack_sel;env_decay<=test_mode?4'd0:decay_sel;
    env_release<=test_mode?4'd0:release_sel;env_sustain<=test_mode?8'd255:sustain_level;
   end
   // A released touchscreen contact does not instantly damp a plucked string.
   // The existing ADSR still shapes each voice; intrinsic string decay ends it.
   wire envelope_gate=gate||(!test_mode_q&&instrument_q==1&&natural[23:8]!=0);
   adsr_envelope envelope(.clk(clk),.tick(sample_tick),.clear(clear),.gate(envelope_gate),
    .attack_sel(env_attack),.decay_sel(env_decay),.release_sel(env_release),
    .sustain_level(env_sustain),.level(env),.state(env_state));
   always @(posedge clk)if(clear)begin gain_q<=256;drum_step<=0;drum_snapshot<=0;end
   else if(sample_tick)begin
    drum_snapshot<=drum_step;
    gain_q<=test_mode_q?9'd256:voice_gains[v*9+:9]>256?9'd256:voice_gains[v*9+:9];
    if(gate&&!previous_gate)case(v%6)
     0:drum_step<=51540;1:drum_step<=66250;2,3:drum_step<=3000000;4:drum_step<=80991;default:drum_step<=1900000;
    endcase
    else if(v%6==0&&drum_step>18000)drum_step<=drum_step-12;
    else if(v%6==4&&drum_step>50000)drum_step<=drum_step-4;
   end
  end
  assign phases[v]=phase_q;assign envelopes[v]=env_q;assign brightness[v]=brightness_q;assign string_levels[v]=string_level_q;
  // Every voice retains its own physical accumulator and envelope state.
  always @(posedge clk)if(clear)phase<=test_mode?proof_seed(test_voice_count):24'd0;
  else if(frequency_done)begin
   if(phase_attack && env_q==0)phase<=frame_test?proof_seed(test_voice_count):24'd0;else if(phase_running)phase<=phase+step;else phase<=0;
  end
  always @(posedge clk)if(clear)begin phase_q<=0;env_q<=0;natural<=0;guitar_slew<=0;pluck_brightness<=0;brightness_slew<=0;brightness_q<=0;string_level_q<=0;previous_gate<=0;phase_attack<=0;phase_running<=0;end
  else if(sample_tick)begin
   previous_gate<=gate;phase_q<=phase;env_q<=selected_env;
   phase_attack<=gate&&!previous_gate;phase_running<=gate||selected_env!=0;
   brightness_q<=brightness_slew[15:8];string_level_q<=guitar_slew[23:8];
   if(natural>guitar_slew)guitar_slew<=natural-guitar_slew>24'd131072 ? guitar_slew+24'd131072 : natural;
   else guitar_slew<=natural;
   if(pluck_brightness>brightness_slew)brightness_slew<=pluck_brightness-brightness_slew>16'd1024 ? brightness_slew+16'd1024 : pluck_brightness;
   else brightness_slew<=pluck_brightness;
   if(gate&&!previous_gate)begin natural<=24'hffff00;pluck_brightness<=65535;end
   else begin
    if(pluck_brightness!=0)pluck_brightness<=pluck_brightness-((pluck_brightness>>12)+1'b1);
    if(instrument_q==1)begin if(natural!=0)natural<=natural-((natural>>15)+1'b1);end
    else if(instrument_q==2)begin if(natural>2048)natural<=natural-2048;else natural<=0;end
   end
  end
 end endgenerate
 assign phase0=voices[0].phase[23:8];assign envelope0=voices[0].selected_env[15:8];
 reg [5:0] index=0;reg [3:0] state=0;reg signed [34:0] mix=0;
 reg signed [28:0] product=0;reg signed [38:0] velocity_product=0;
 reg signed [45:0] string_product=0;
 reg signed [17:0] scaled=0;reg signed [27:0] volume_product=0,gain_product=0;
 reg [8:0] volume_smooth=EXTERNAL_MASTER?256:128;wire [8:0] volume_target=EXTERNAL_MASTER?9'd256:{1'b0,volume,4'b0};
 wire [1:0] kind=test_mode_q?0:index==32?1:instrument_q==2?0:instrument_q==1?2:1;
 wire signed [7:0] tonal;instrument_wave_table wavetable(.phase(phases[index][23:16]),.kind(kind),.value(tonal));
 wire guitar_sample=!test_mode_q&&instrument_q==1&&index<32;
 wire signed [12:0] guitar_tonal;
 guitar_wave_table guitar_table(.clk(clk),.enable(guitar_sample&&state==8),.phase(phases[index]),.step(index<32?bank_steps[index*24+:24]:24'd0),.brightness(brightness[index]),.value(guitar_tonal));
 reg signed [12:0] wave;reg signed [8:0] legacy_wave;
 wire signed [8:0] noise_difference=($signed({noise[7],noise})-$signed({old_noise[7],old_noise}))>>>1;
 always @*begin
  legacy_wave=$signed({tonal[7],tonal});
  if(!test_mode_q&&instrument_q==2&&index<32)case(index%6)
   1:legacy_wave=($signed(noise)>>>1)+($signed(tonal)>>>2);2,3:legacy_wave=noise_difference;5:legacy_wave=$signed(noise)>>>1;default:legacy_wave=$signed(tonal);
  endcase
  wave=guitar_sample?(guitar_tonal+(guitar_tonal>>>1)):($signed(legacy_wave)<<<4);
 end
 reg [5:0] count_work=0;
 always @(posedge clk)begin
  pcm_valid<=0;
  if(clear)begin state<=0;pcm<=0;mix<=0;index<=0;product<=0;string_product<=0;velocity_product<=0;scaled<=0;volume_product<=0;gain_product<=0;overrun<=0;active_count<=0;count_work<=0;volume_smooth<=volume_target;end
  else begin
   if((sample_tick&&state!=0)||frequency_overrun)overrun<=1;
   case(state)
    0:if(sample_tick)begin index<=0;mix<=0;count_work<=0;state<=(!test_mode_q&&instrument_q==1)?8:1;
     if(volume_smooth<volume_target)volume_smooth<=volume_smooth+1'b1;else if(volume_smooth>volume_target)volume_smooth<=volume_smooth-1'b1;
    end
    1:begin product<=wave*$signed({1'b0,envelopes[index]});state<=guitar_sample?11:2;end
    2:begin velocity_product<=(guitar_sample?$signed(string_product[44:16]):product)*$signed({1'b0,gains[index]});state<=3;end
    3:begin mix<=mix+($signed(velocity_product)>>>8);if(envelopes[index]!=0)count_work<=count_work+1'b1;
     if(index==32)state<=4;else begin index<=index+1'b1;state<=(!test_mode_q&&instrument_q==1)?8:1;end
    end
    4:begin scaled<=mix>>>18;active_count<=count_work;state<=5;end
    5:begin volume_product<=scaled*$signed({1'b0,volume_smooth});state<=6;end
    6:begin gain_product<=$signed(volume_product[25:8])*$signed({1'b0,mode_gain>256?9'd256:mode_gain});state<=7;end
    7:begin pcm<=($signed(gain_product)>>>8)>32767?16'sd32767:($signed(gain_product)>>>8)< -32768?-16'sd32768:gain_product[23:8];pcm_valid<=1;state<=0;end
    8:state<=9;9:state<=10;10:state<=1;
    // One shared multiplier combines intrinsic string decay with the actual
    // ADSR, instead of taking their minimum (which creates a flat plateau).
    11:begin string_product<=product*$signed({1'b0,string_levels[index]});state<=2;end
    default:state<=0;
   endcase
  end
 end
endmodule
