Ring-F-nebula/fpga-multitimbral-instrument/firmware/src/midi_step_rom.v

module midi_step_rom(input [7:0] note,output reg [23:0] step);
always @* case(note)
8'd0:step=24'd3010;
8'd1:step=24'd3189;
8'd2:step=24'd3378;
8'd3:step=24'd3579;
8'd4:step=24'd3792;
8'd5:step=24'd4018;
8'd6:step=24'd4257;
8'd7:step=24'd4510;
8'd8:step=24'd4778;
8'd9:step=24'd5062;
8'd10:step=24'd5363;
8'd11:step=24'd5682;
8'd12:step=24'd6020;
8'd13:step=24'd6378;
8'd14:step=24'd6757;
8'd15:step=24'd7159;
8'd16:step=24'd7584;
8'd17:step=24'd8035;
8'd18:step=24'd8513;
8'd19:step=24'd9019;
8'd20:step=24'd9556;
8'd21:step=24'd10124;
8'd22:step=24'd10726;
8'd23:step=24'd11364;
8'd24:step=24'd12039;
8'd25:step=24'd12755;
8'd26:step=24'd13514;
8'd27:step=24'd14317;
8'd28:step=24'd15169;
8'd29:step=24'd16071;
8'd30:step=24'd17026;
8'd31:step=24'd18039;
8'd32:step=24'd19111;
8'd33:step=24'd20248;
8'd34:step=24'd21452;
8'd35:step=24'd22727;
8'd36:step=24'd24079;
8'd37:step=24'd25511;
8'd38:step=24'd27027;
8'd39:step=24'd28635;
8'd40:step=24'd30337;
8'd41:step=24'd32141;
8'd42:step=24'd34052;
8'd43:step=24'd36077;
8'd44:step=24'd38223;
8'd45:step=24'd40495;
8'd46:step=24'd42903;
8'd47:step=24'd45455;
8'd48:step=24'd48157;
8'd49:step=24'd51021;
8'd50:step=24'd54055;
8'd51:step=24'd57269;
8'd52:step=24'd60675;
8'd53:step=24'd64282;
8'd54:step=24'd68105;
8'd55:step=24'd72155;
8'd56:step=24'd76445;
8'd57:step=24'd80991;
8'd58:step=24'd85807;
8'd59:step=24'd90909;
8'd60:step=24'd96315;
8'd61:step=24'd102042;
8'd62:step=24'd108110;
8'd63:step=24'd114538;
8'd64:step=24'd121349;
8'd65:step=24'd128565;
8'd66:step=24'd136210;
8'd67:step=24'd144309;
8'd68:step=24'd152890;
8'd69:step=24'd161982;
8'd70:step=24'd171614;
8'd71:step=24'd181818;
8'd72:step=24'd192630;
8'd73:step=24'd204084;
8'd74:step=24'd216220;
8'd75:step=24'd229077;
8'd76:step=24'd242698;
8'd77:step=24'd257130;
8'd78:step=24'd272420;
8'd79:step=24'd288618;
8'd80:step=24'd305781;
8'd81:step=24'd323963;
8'd82:step=24'd343227;
8'd83:step=24'd363636;
8'd84:step=24'd385259;
8'd85:step=24'd408168;
8'd86:step=24'd432439;
8'd87:step=24'd458153;
8'd88:step=24'd485396;
8'd89:step=24'd514260;
8'd90:step=24'd544839;
8'd91:step=24'd577237;
8'd92:step=24'd611561;
8'd93:step=24'd647926;
8'd94:step=24'd686454;
8'd95:step=24'd727273;
8'd96:step=24'd770519;
8'd97:step=24'd816336;
8'd98:step=24'd864878;
8'd99:step=24'd916306;
8'd100:step=24'd970793;
8'd101:step=24'd1028519;
8'd102:step=24'd1089678;
8'd103:step=24'd1154474;
8'd104:step=24'd1223122;
8'd105:step=24'd1295853;
8'd106:step=24'd1372908;
8'd107:step=24'd1454546;
8'd108:step=24'd1541038;
8'd109:step=24'd1632672;
8'd110:step=24'd1729756;
8'd111:step=24'd1832613;
8'd112:step=24'd1941586;
8'd113:step=24'd2057038;
8'd114:step=24'd2179356;
8'd115:step=24'd2308948;
8'd116:step=24'd2446245;
8'd117:step=24'd2591706;
8'd118:step=24'd2745817;
8'd119:step=24'd2909092;
8'd120:step=24'd3082075;
8'd121:step=24'd3265345;
8'd122:step=24'd3459512;
8'd123:step=24'd3665226;
8'd124:step=24'd3883171;
8'd125:step=24'd4114077;
8'd126:step=24'd4358713;
8'd127:step=24'd4617895;
default:step=0;endcase
endmodule
